zanac/PSN-Presepe-2026/simulation_web/README.md

# Web simulator — PRESEPE.INI

A single HTML page that runs the light cycle described by a `PRESEPE.INI` in the browser, with no hardware and no Arduino. Use it to try curves, colours and timings before copying the file to the microSD card.

Open `index.html` in any modern browser (double-click it). No server and no install needed; only the fonts come from Google Fonts, and the page works with fallback fonts when offline.

## What it shows

- **Left:** the INI text. Edit or paste a file; the simulation updates as you type. Parse errors are listed under the text, one per bad line, by the same rules the firmware uses (the firmware itself only reports how many there are and the first bad line). *Ripristina il file predefinito* reloads the repo's `PRESEPE.INI`; *Copia il file* copies the text, ready for the microSD.
- **Right:** three panels, TRAMONTO (left), CIELO (centre), ALBA (right), with their current RGB values; the name of the current phase and the position in the cycle.
- **Cycle line:** one band per strip (top to bottom: TRAMONTO, CIELO, ALBA), the tappe as white ticks, the level of the two star chains at the bottom (STELLE_01 above, STELLE_02 below, in their tint). Click or drag on it to jump to any point of the cycle.
- **Under the line:** the level of STELLE_01 and STELLE_02, the 16 relays.
- **Transport:** play/pause, cycle duration (`durata1`–`durata3` from the file, plus two fast speeds), previous/next phase.

The text you type is kept in the browser's local storage, so it survives a page reload.

**Grafico / Testo.** The *Grafico* view edits the phases on lanes (colour stops as dots, relay events), the *Testo* view shows the plain file; both stay in sync. See the [README, WiFi](../README.md#wifi-mega--wifi-r3-board) for how it works.

**On the board.** The same page is served by a "Mega + WiFi R3" board at `http://presepe.local/config` ([README, WiFi](../README.md#wifi-mega--wifi-r3-board)). There it starts from the board's `PRESEPE.INI` and adds a card with *Salva sul presepe*, *Riavvia il presepe*, *Ricarica dal presepe* and *Ripristina il file precedente*. `firmware/tools/build_web.py` builds that version from `simulator.template.html`, so rebuild the ESP firmware after changing the template.

## How faithful it is

The JavaScript re-implements the firmware's pure-logic part (the CONFIG block of `PSN-Presepe.ino`, release 039): the parser and its error rules (including the final checks: phase order, potentiometer range, star brightness and twinkle limits of `[STELLE_01]` and `[STELLE_02]`), the defaults, phase positions, the tappe engine (`morbida` smoothstep and `lineare`, truncating interpolation, wrap-around across the cycle end), the level of the two star chains and the relay schedule. The twinkling of single stars is not drawn.

It is a model, not the firmware: when the firmware logic changes, update `simulator.template.html` too.

A screen is not an LED strip. Real strips are more saturated and low values look different, so use the simulator for shape and timing, then fine-tune colours on the real strip or with the board's colour mode.

## Files

| File | Content |
|---|---|
| `index.html` | the simulator, generated — open this one |
| `simulator.template.html` | source of the page, with an `__INI__` placeholder for the default file |
| `build_simulator.py` | rebuilds `index.html` from the template and `firmware/PSN-Presepe/PRESEPE.INI` |

After every change to `firmware/PSN-Presepe/PRESEPE.INI` or to the template, rebuild. After a change to the template also run `python3 firmware/tools/build_web.py` (the ESP pages and the demo use it); after a change to `PRESEPE.INI` run both that and `python3 firmware/tools/embed_ini.py` (the copy inside the firmware). `firmware/tools/run_tests.sh` checks all of them with `--check`:

```sh
python3 simulation_web/build_simulator.py
# options: --ini PATH  --template PATH  --out PATH  --check
```
