zanac/PSN-Presepe-2026/reports/schematic-pcb-parity.txt

schematic pins 363, pcb pads 363, net mismatches 0, footprint mismatches 0
