zanac/PSN-Presepe-2026/hardware/rev-e/reports/schematic-pcb-parity.txt

schematic pins 373, pcb pads 373, net mismatches 0, footprint mismatches 0
