zanac/PSN-Presepe-2026/hardware/rev-e/previews/PSN-Presepe-Mega-RevE-copper-both.png

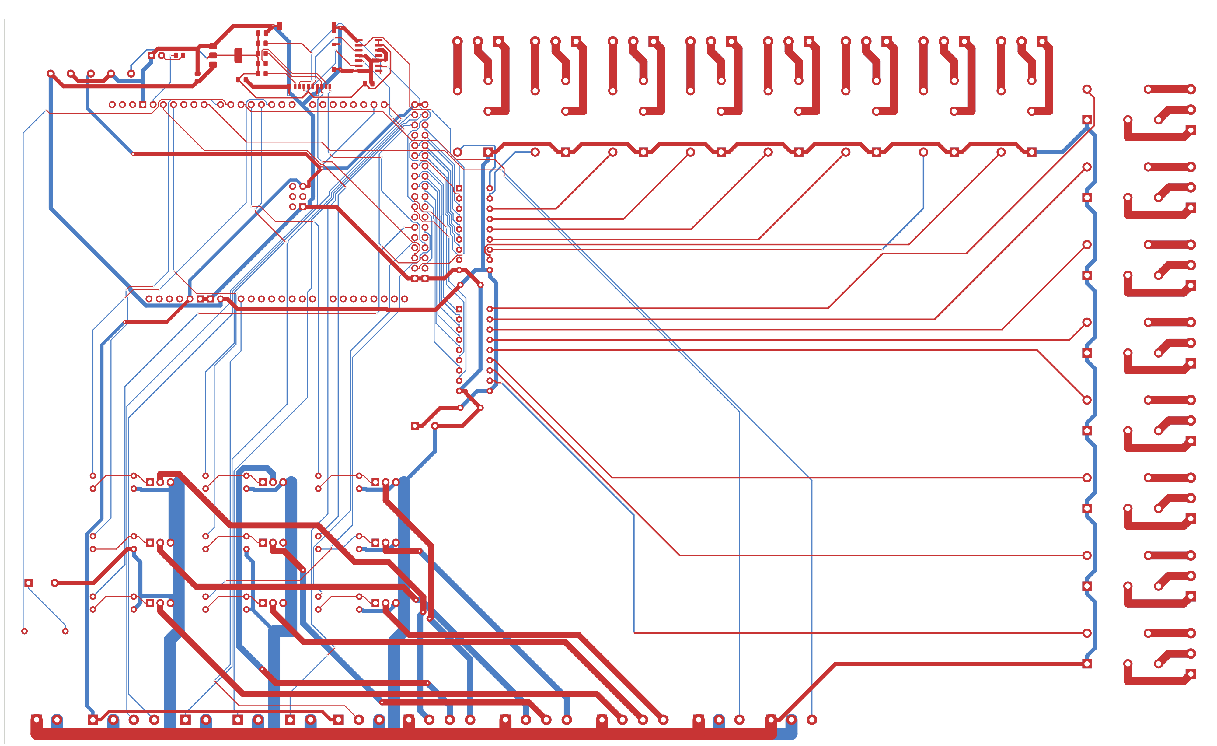
hardware/rev-e/previews/PSN-Presepe-Mega-RevE-copper-both.png
