zanac/PSN-Presepe-2026/hardware/rev-e/previews/PSN-Presepe-Mega-RevE-gerber-render-bottom.png

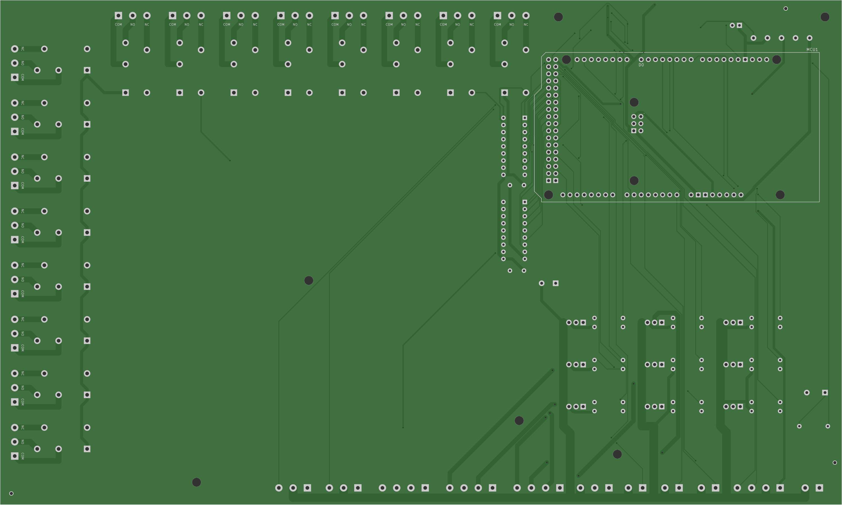
hardware/rev-e/previews/PSN-Presepe-Mega-RevE-gerber-render-bottom.png
