zanac/PSN-Presepe-2026/hardware/rev-e/previews/PSN-Presepe-Mega-RevE-gerber-render-top.png

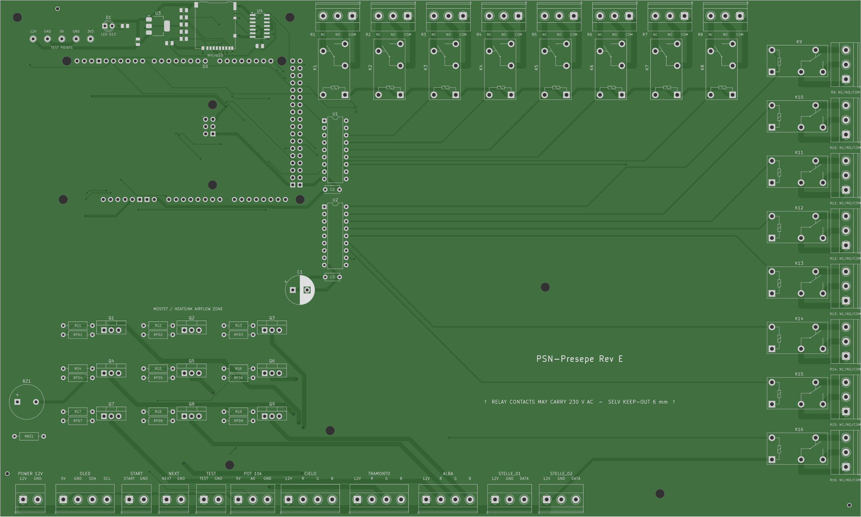
hardware/rev-e/previews/PSN-Presepe-Mega-RevE-gerber-render-top.png
