zanac/PSN-Presepe-2026/previews/PSN-Presepe-Mega-RevD-copper-both.png

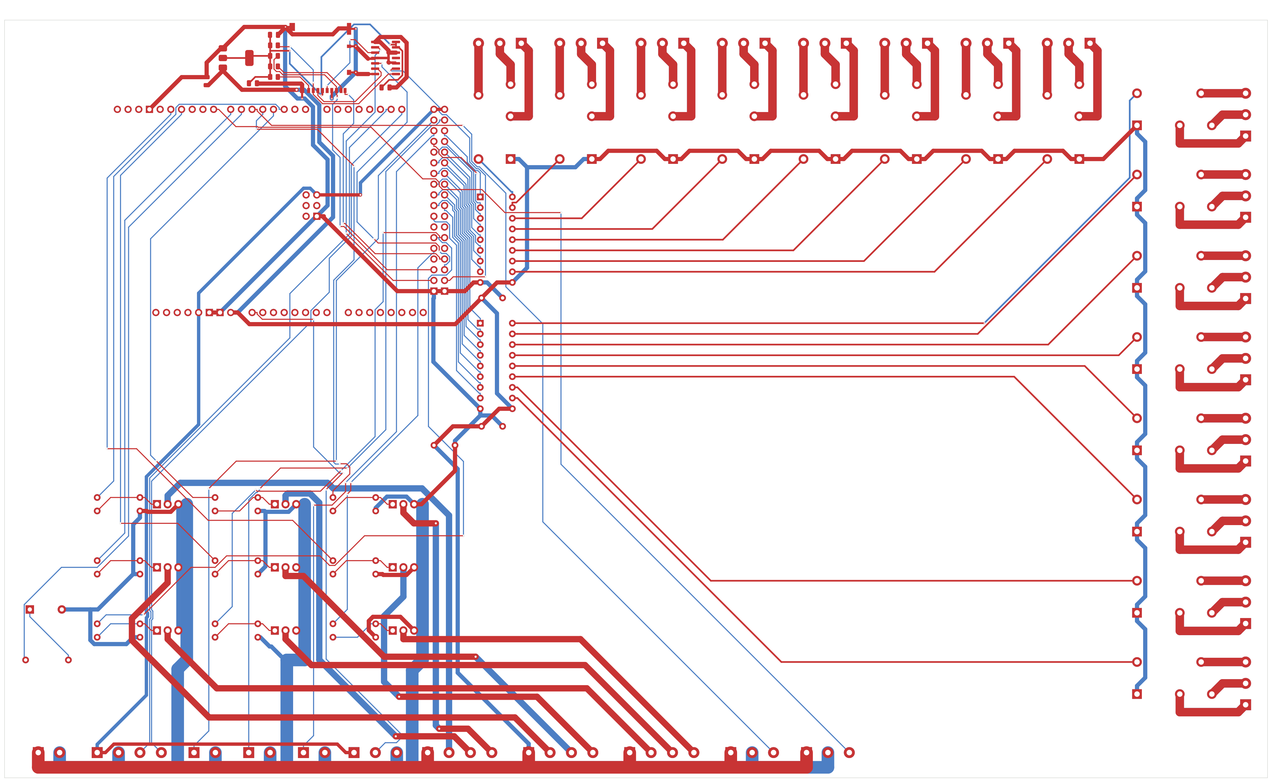
previews/PSN-Presepe-Mega-RevD-copper-both.png
