zanac/PSN-Presepe-2026/previews/PSN-Presepe-Mega-RevD-gerber-render-bottom.png

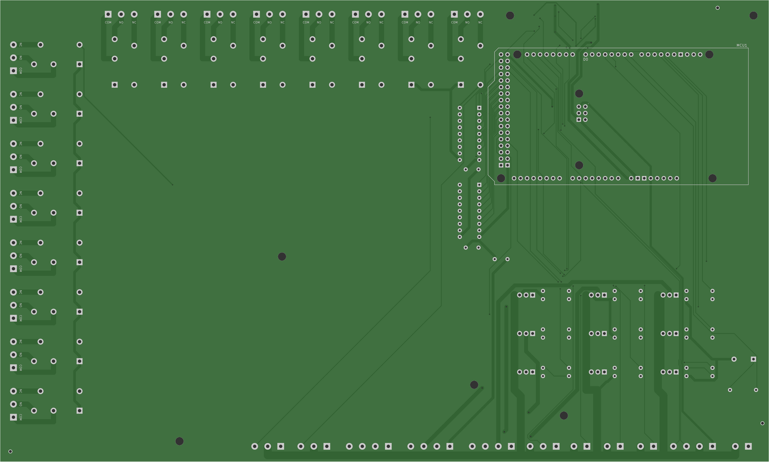
previews/PSN-Presepe-Mega-RevD-gerber-render-bottom.png
