zanac/PSN-Presepe-2026/undefined/sim.png

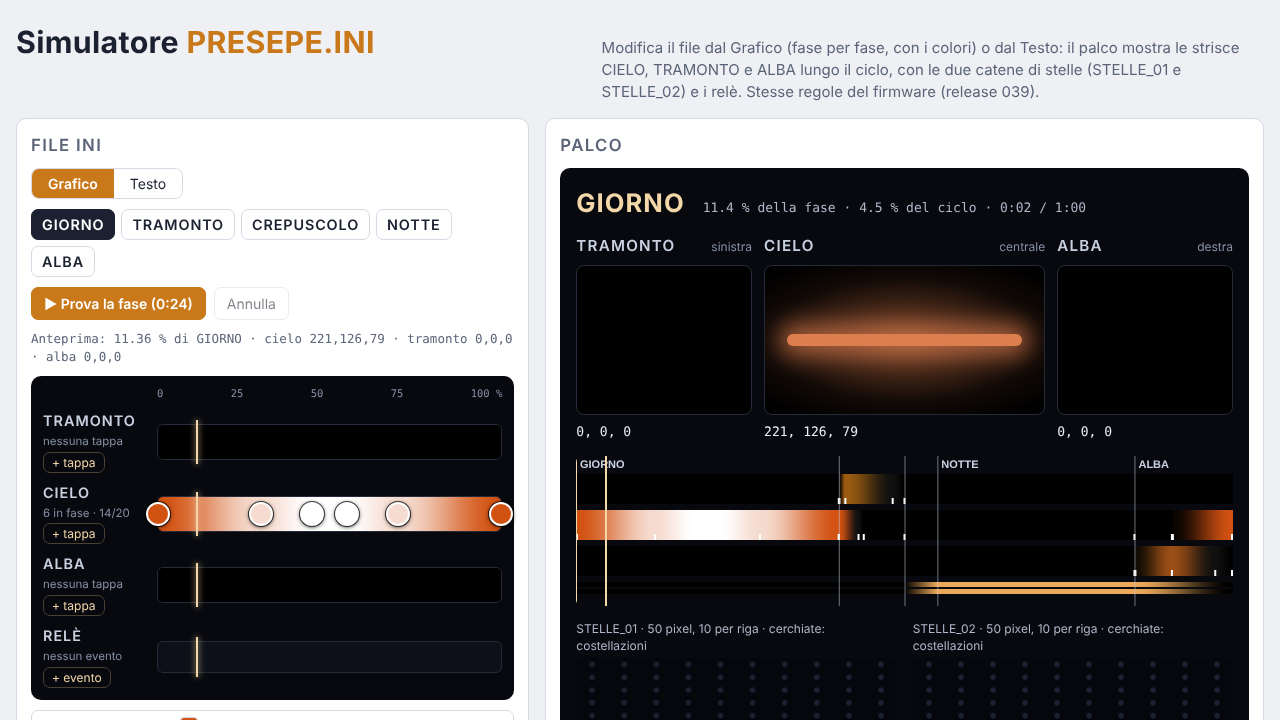
undefined/sim.png
