zanac/PSN-Presepe-2026/hardware/rev-d/manufacturing/pcbway-order-2026-10-04/README.md

# PCBWay order of 2026-10-04 (frozen)

These are the exact files uploaded to PCBWay for the first Rev D production run.
Never regenerate or edit them; `SHA256SUMS` lets you check that they are intact
(`sha256sum -c SHA256SUMS`).

| PCBWay upload field | File |
|---|---|
| Upload Gerbers file | `PSN-Presepe-Mega-RevD-gerbers.zip` |
| Parts List (BOM) Upload | `PSN-Presepe-Mega-RevD-BOM-PCBWay.csv` |
| Upload Centroid file | `PSN-Presepe-Mega-RevD-Centroid-PCBWay.csv` |
| Upload assembly other files | `PSN-Presepe-Mega-RevD-Assembly-Instructions.pdf` |

Order numbers: PCB `W1109855AS3D1`, assembly `T-3D2W1109855A`.

PCB options chosen: single pieces, 300 x 180 mm, quantity 5, 2 layers, FR-4 TG150,
1.6 mm, 8/8 mil (set by PCBWay for 2 oz), min hole 0.3 mm, green mask, white silk,
HASL lead-free (ENIG substitution allowed), tented vias, 2 oz finished copper,
product number removed. Assembly: turnkey, 2 boards, both sides (MCU1 headers on
the bottom), alternatives accepted for passives only (see the remarks below).

Remarks sent with the order:

> Board carries 230 VAC on relay contacts: do not modify copper, clearances or add
> vias. 2 oz copper required. Please send DFM results before production.

Message to the sales representative (Contact sales-rep):

> 1. Min copper spacing in the design is 0.20 mm (7.9 mil). Please confirm it is OK
>    with 2 oz copper, otherwise tell us before production. Do not modify copper,
>    clearances or vias: the relay area carries 230 VAC.
> 2. The Arduino Mega headers (MCU1) must be mounted on the BOTTOM side, and the ICSP
>    2x3 holes left empty, as described in the Assembly-Instructions PDF.
> 3. Please keep the exact part numbers in the BOM for relays, MOSFETs, ICs, the
>    microSD socket and the terminal blocks, and ask before substituting them.
> 4. Please send photos of the first assembled board before shipping.

Differences from the files regenerated by `./build.sh` (all cosmetic, verified):

* Gerbers: the X2 header attribute `TF.ProjectId` / job-file `Revision` says `C`
  (a leftover title-block value, fixed to `D` afterwards) and the creation dates
  differ. `reports/gerber-equivalence-vs-pcbway-order.txt` proves the copper, mask,
  silkscreen, outline and drill geometry is identical, primitive by primitive.
* Centroid: MCU1 X was rounded by hand to 85.6600 mm; the script writes 85.6580 mm.
