zanac/PSN-Presepe-2026/hardware/rev-e/previews/PSN-Presepe-Mega-RevE-assembly.png

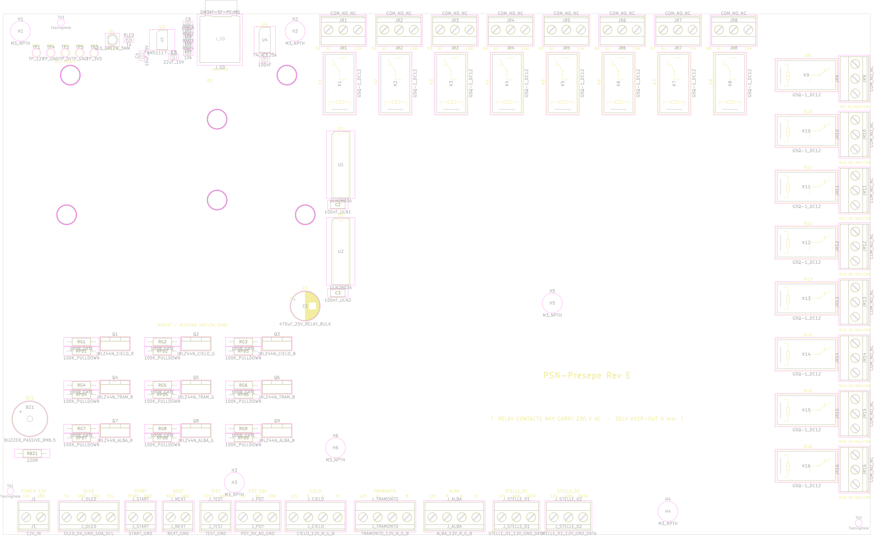
hardware/rev-e/previews/PSN-Presepe-Mega-RevE-assembly.png
