zanac/PSN-Presepe-2026/hardware/rev-e/kicad/PSN-Presepe-Mega-RevE-schematic.pdf

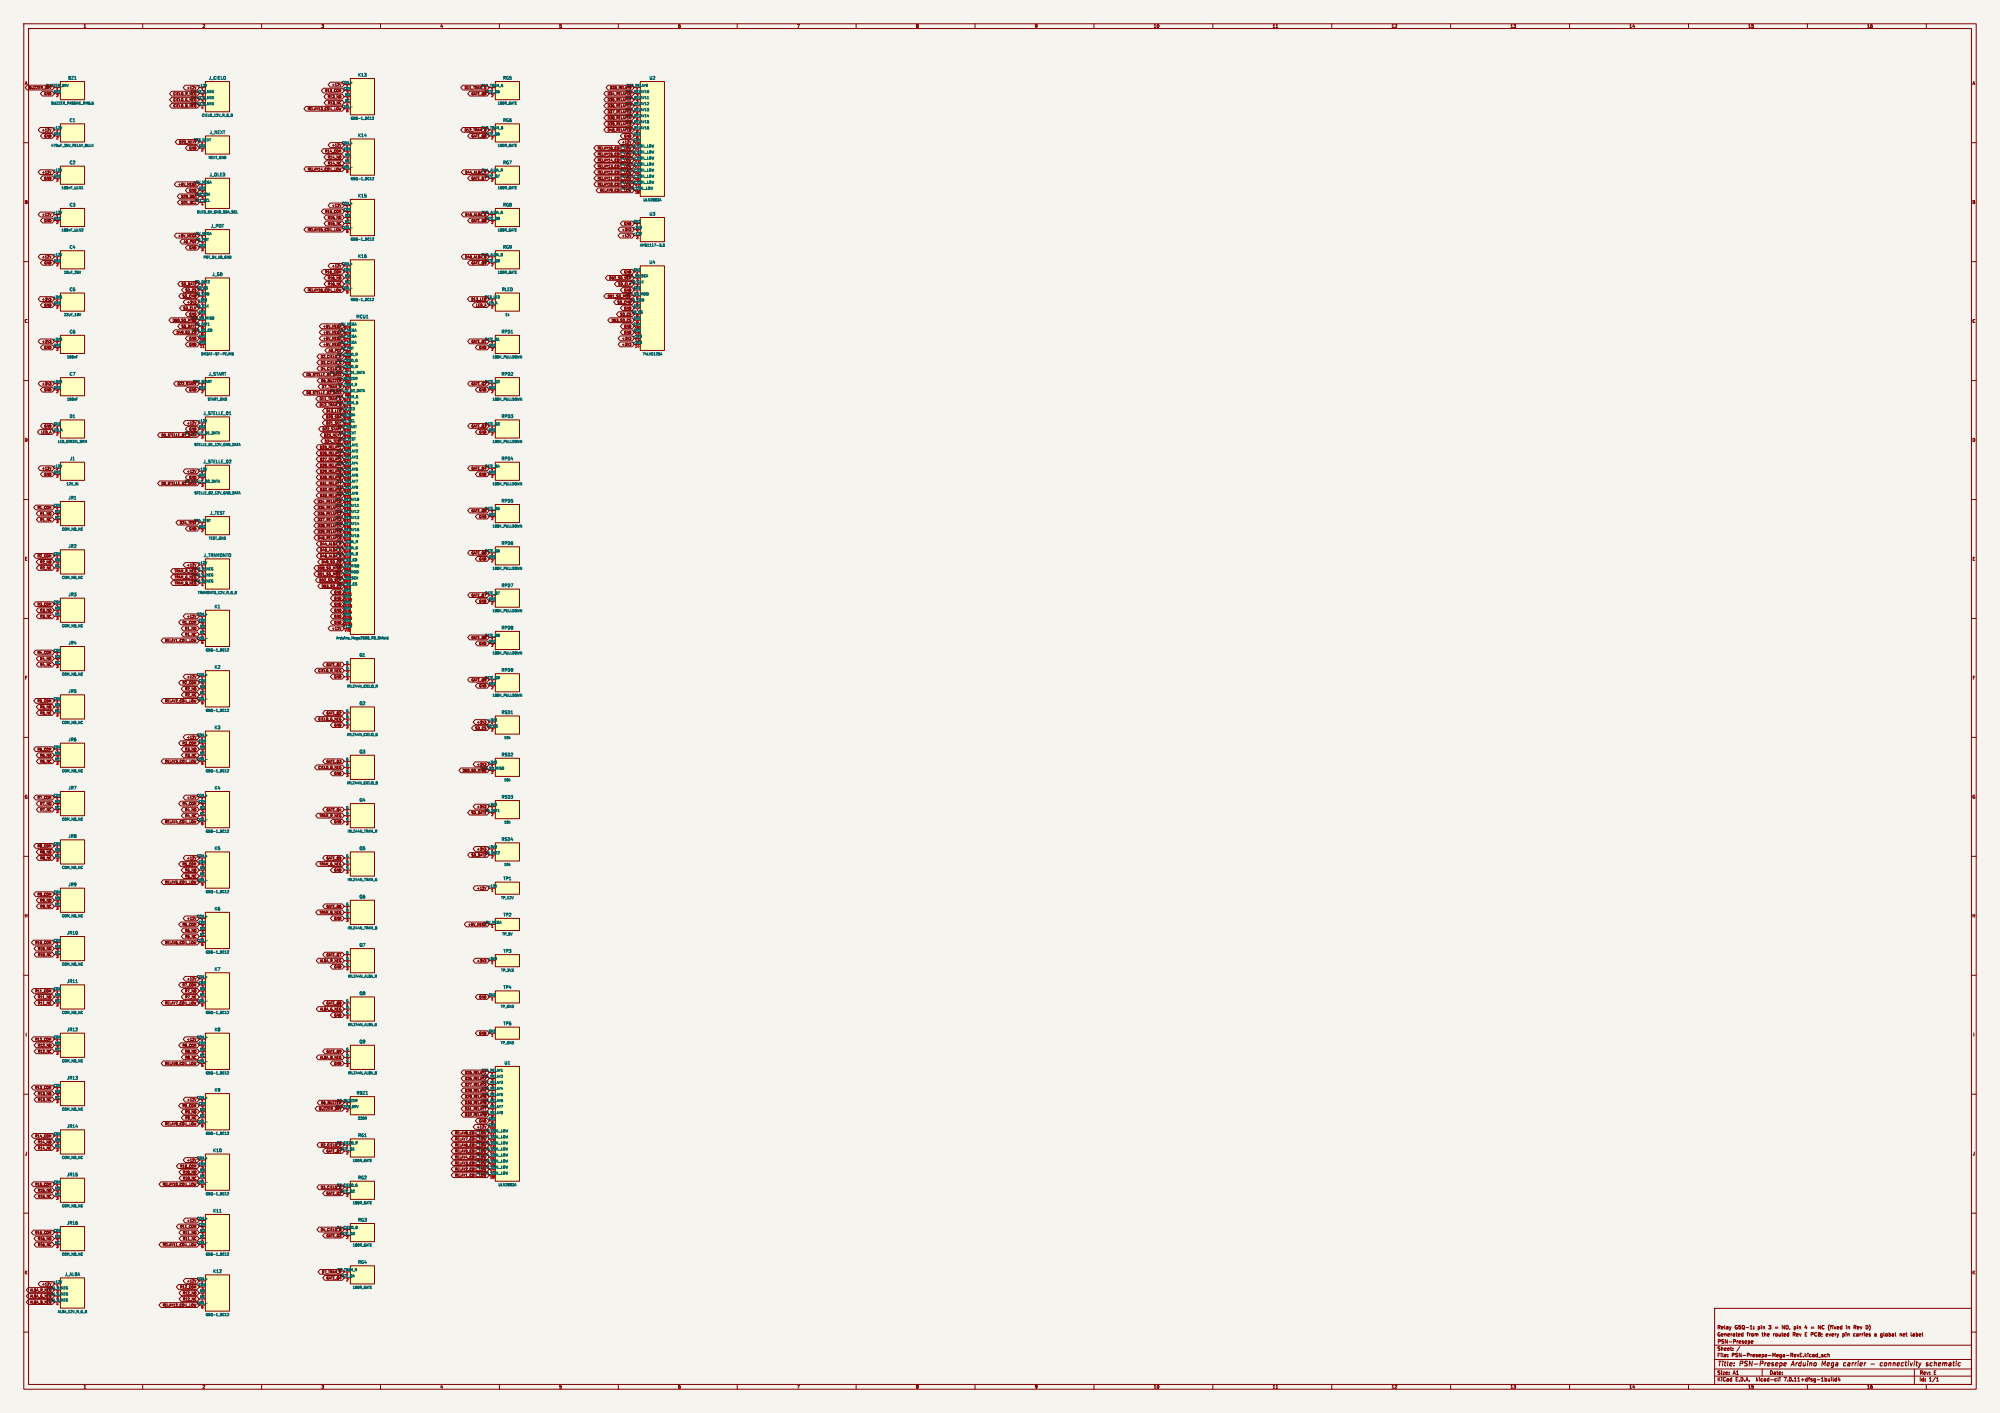
[picture p14: page 1]

POT_5V_A0_GND
D7 D8_STELLE_02_DATA D8 GND GND1 GND GND2 GND GND3 GND GND4 GND GND5 GND GND6 +12V

+3V3 GND GATE_Q9 GND GATE_Q8 GND GATE_Q7 GND GND
+12V GND GND GND GND
GATE_Q2 GND
