zanac/PSN-Presepe-2026/manufacturing/PSN-Presepe-Mega-RevD-1to1-A3-top.pdf

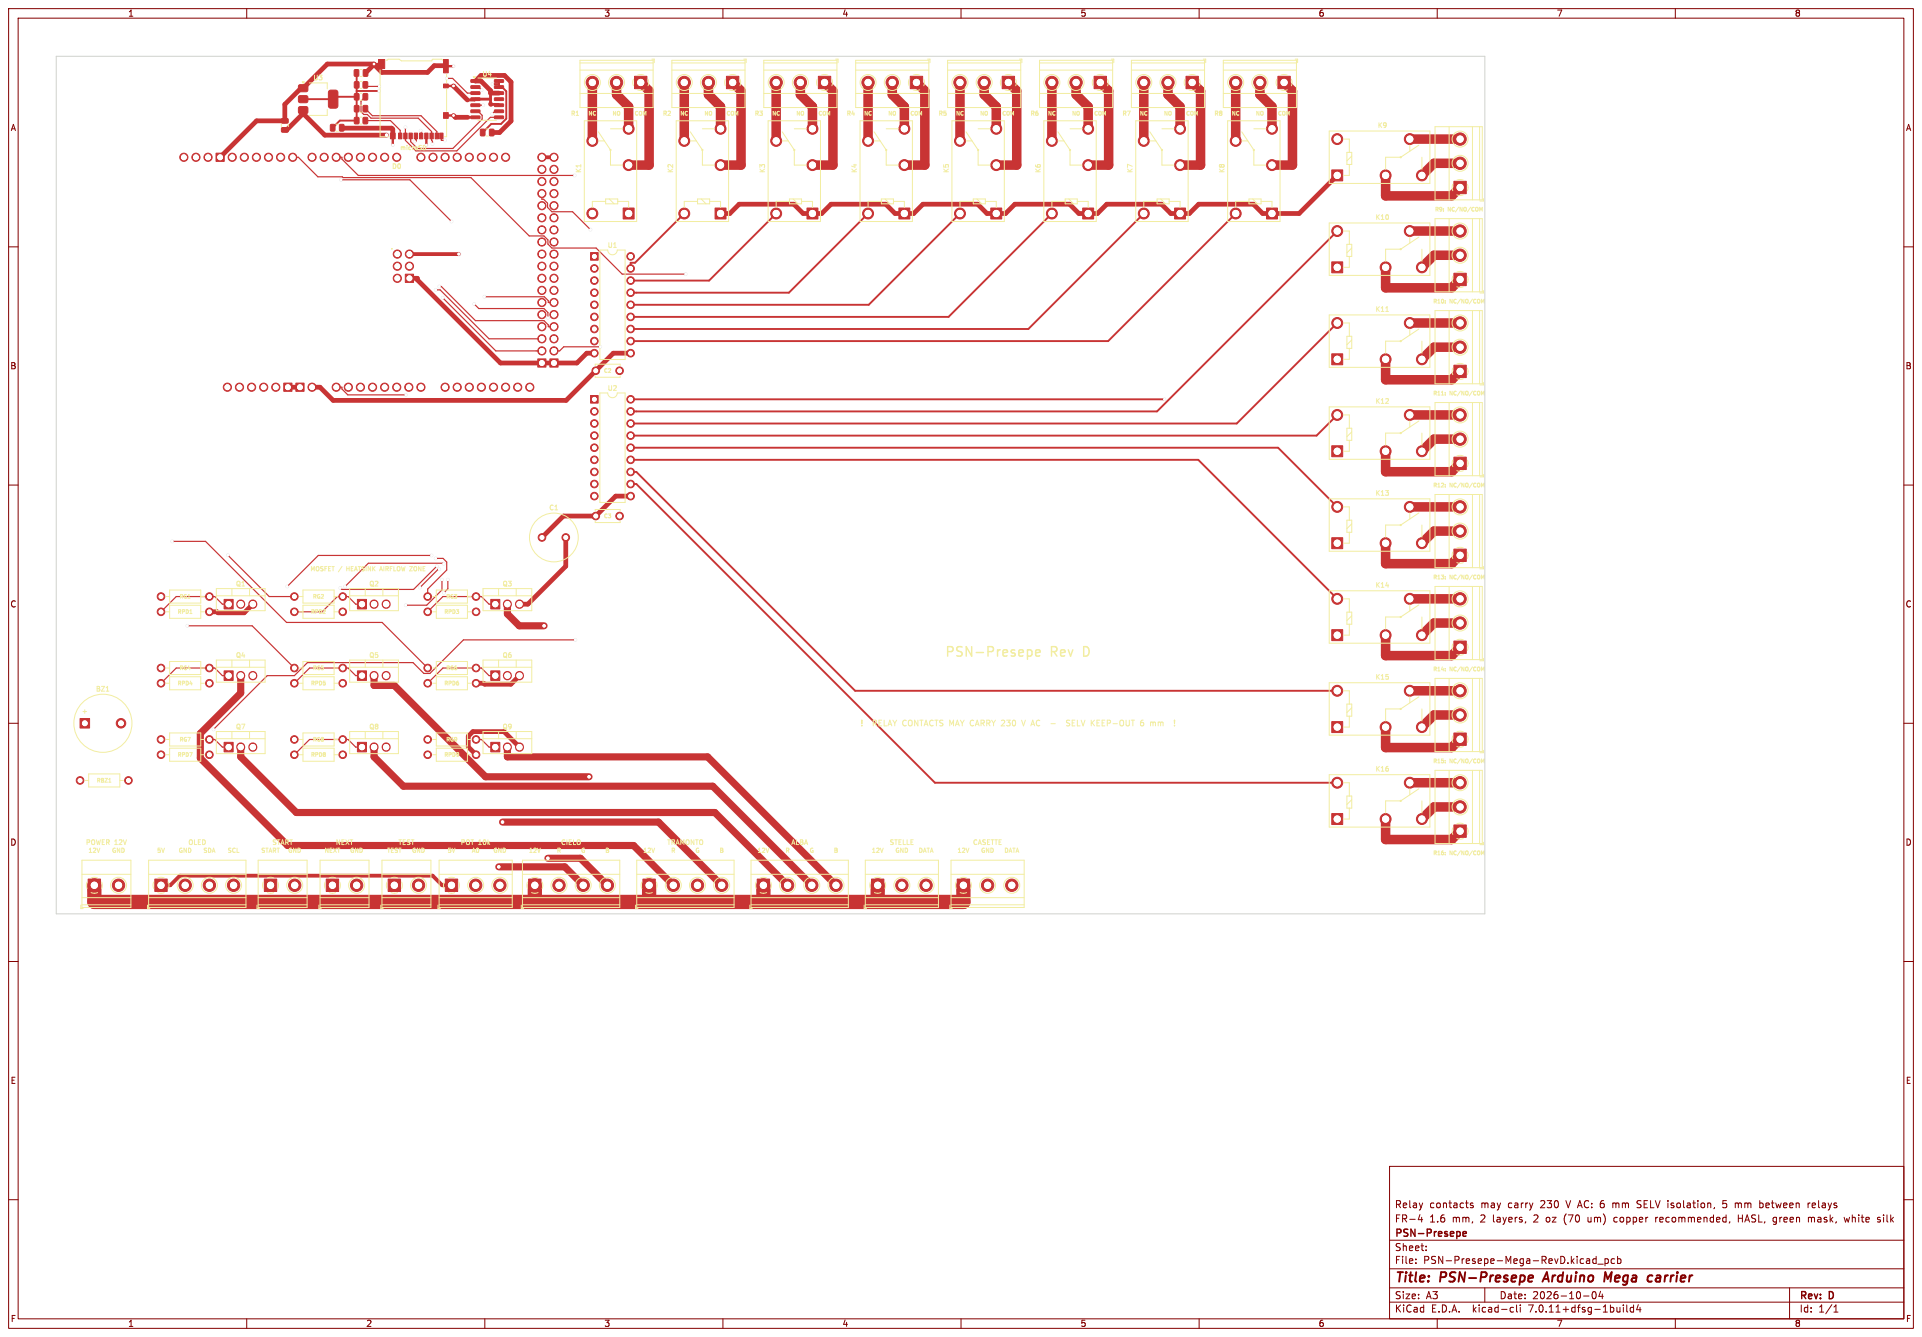
[picture p15: page 1]

R12: NC/NO/COM CASETTE
