zanac/PSN-Presepe-2026/hardware/rev-e/manufacturing/PSN-Presepe-Mega-RevE-1to1-A3-top.pdf

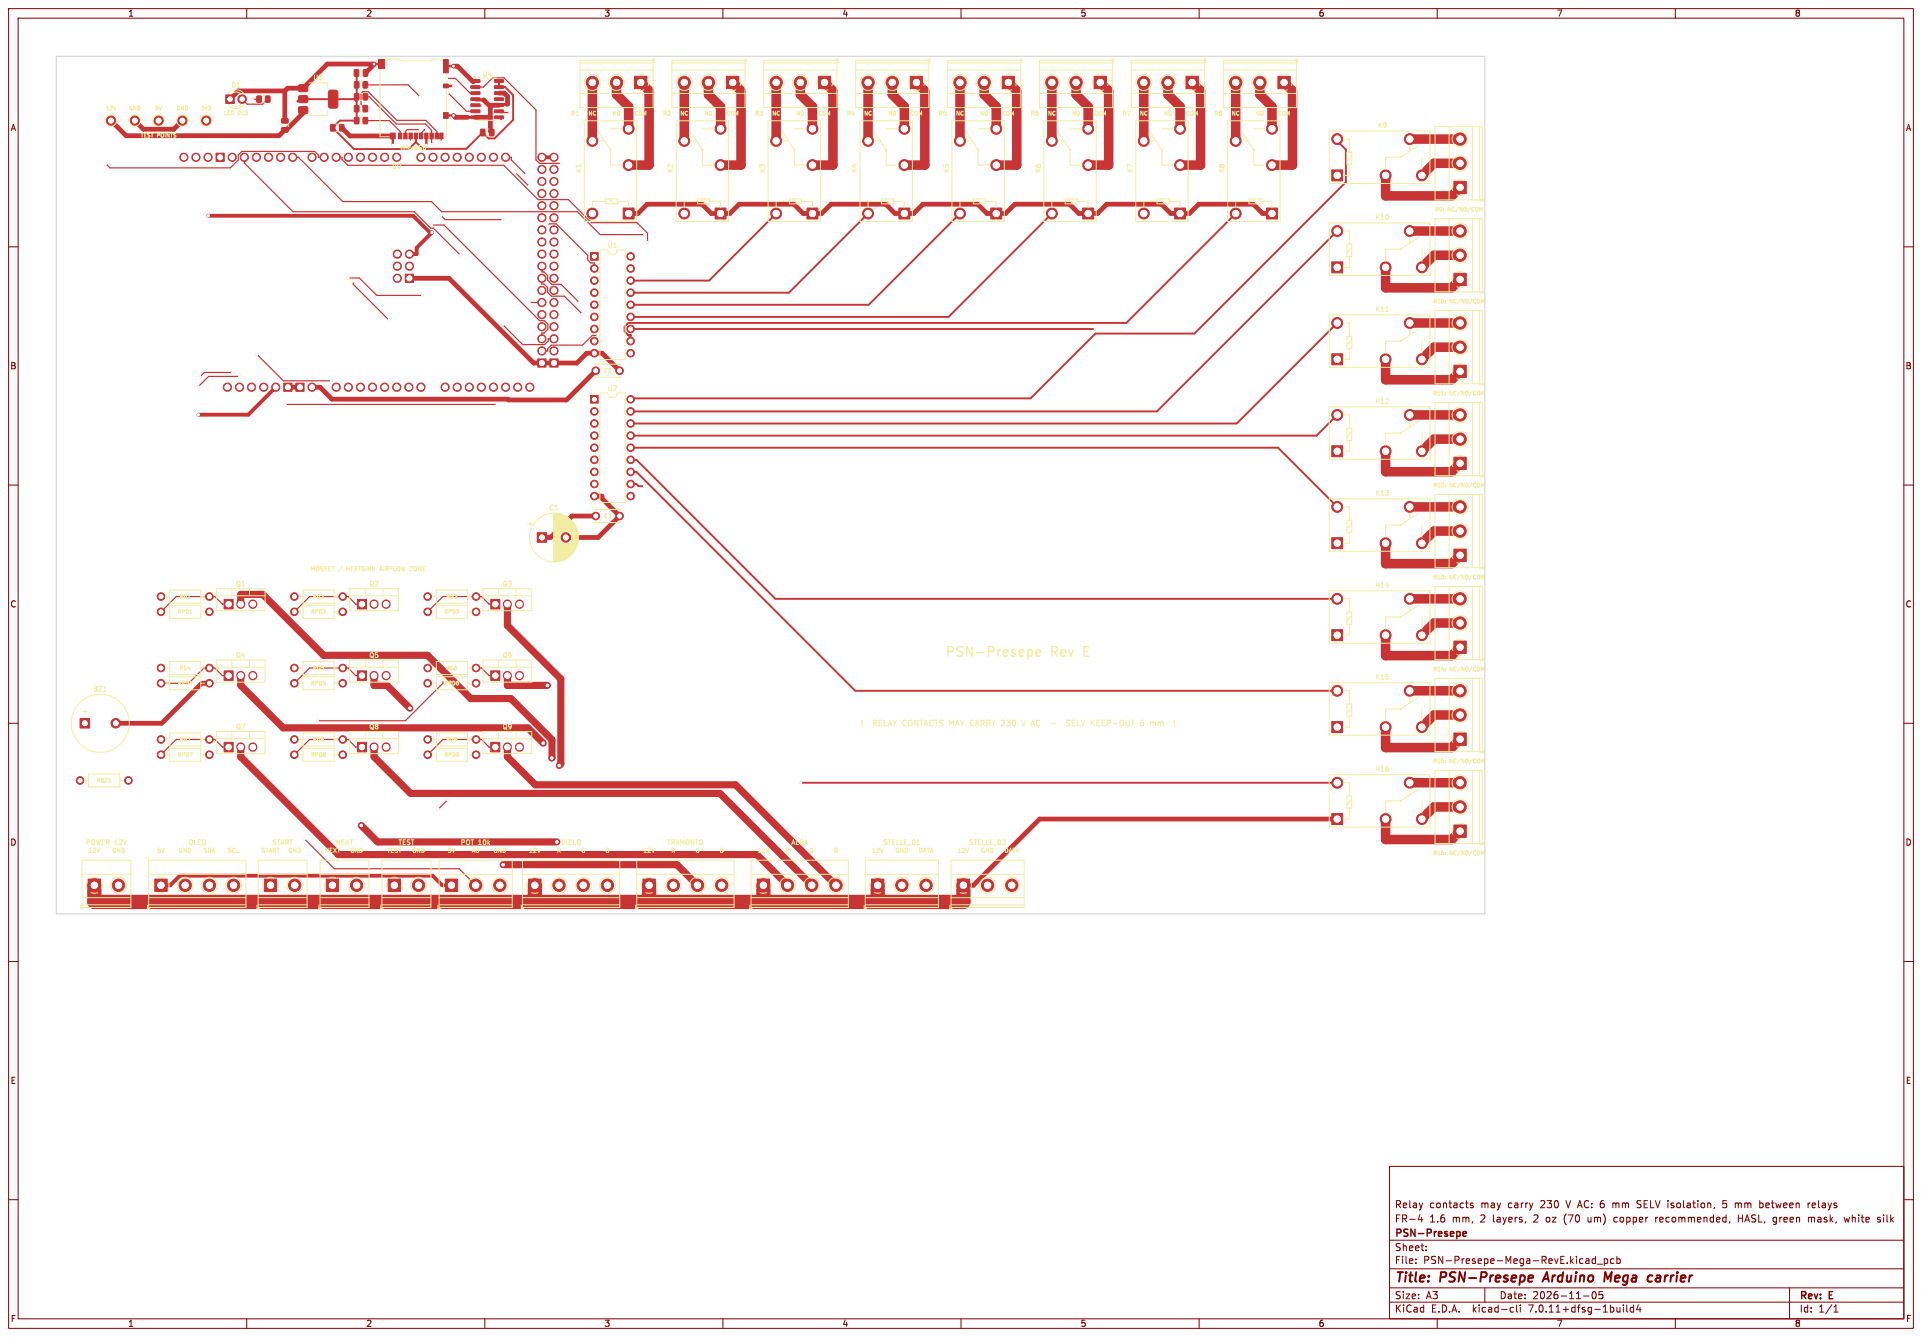
[picture p16: page 1]
