zanac/PSN-Presepe-2026/hardware/rev-d/kicad/PSN-Presepe-Mega-RevD-schematic.pdf

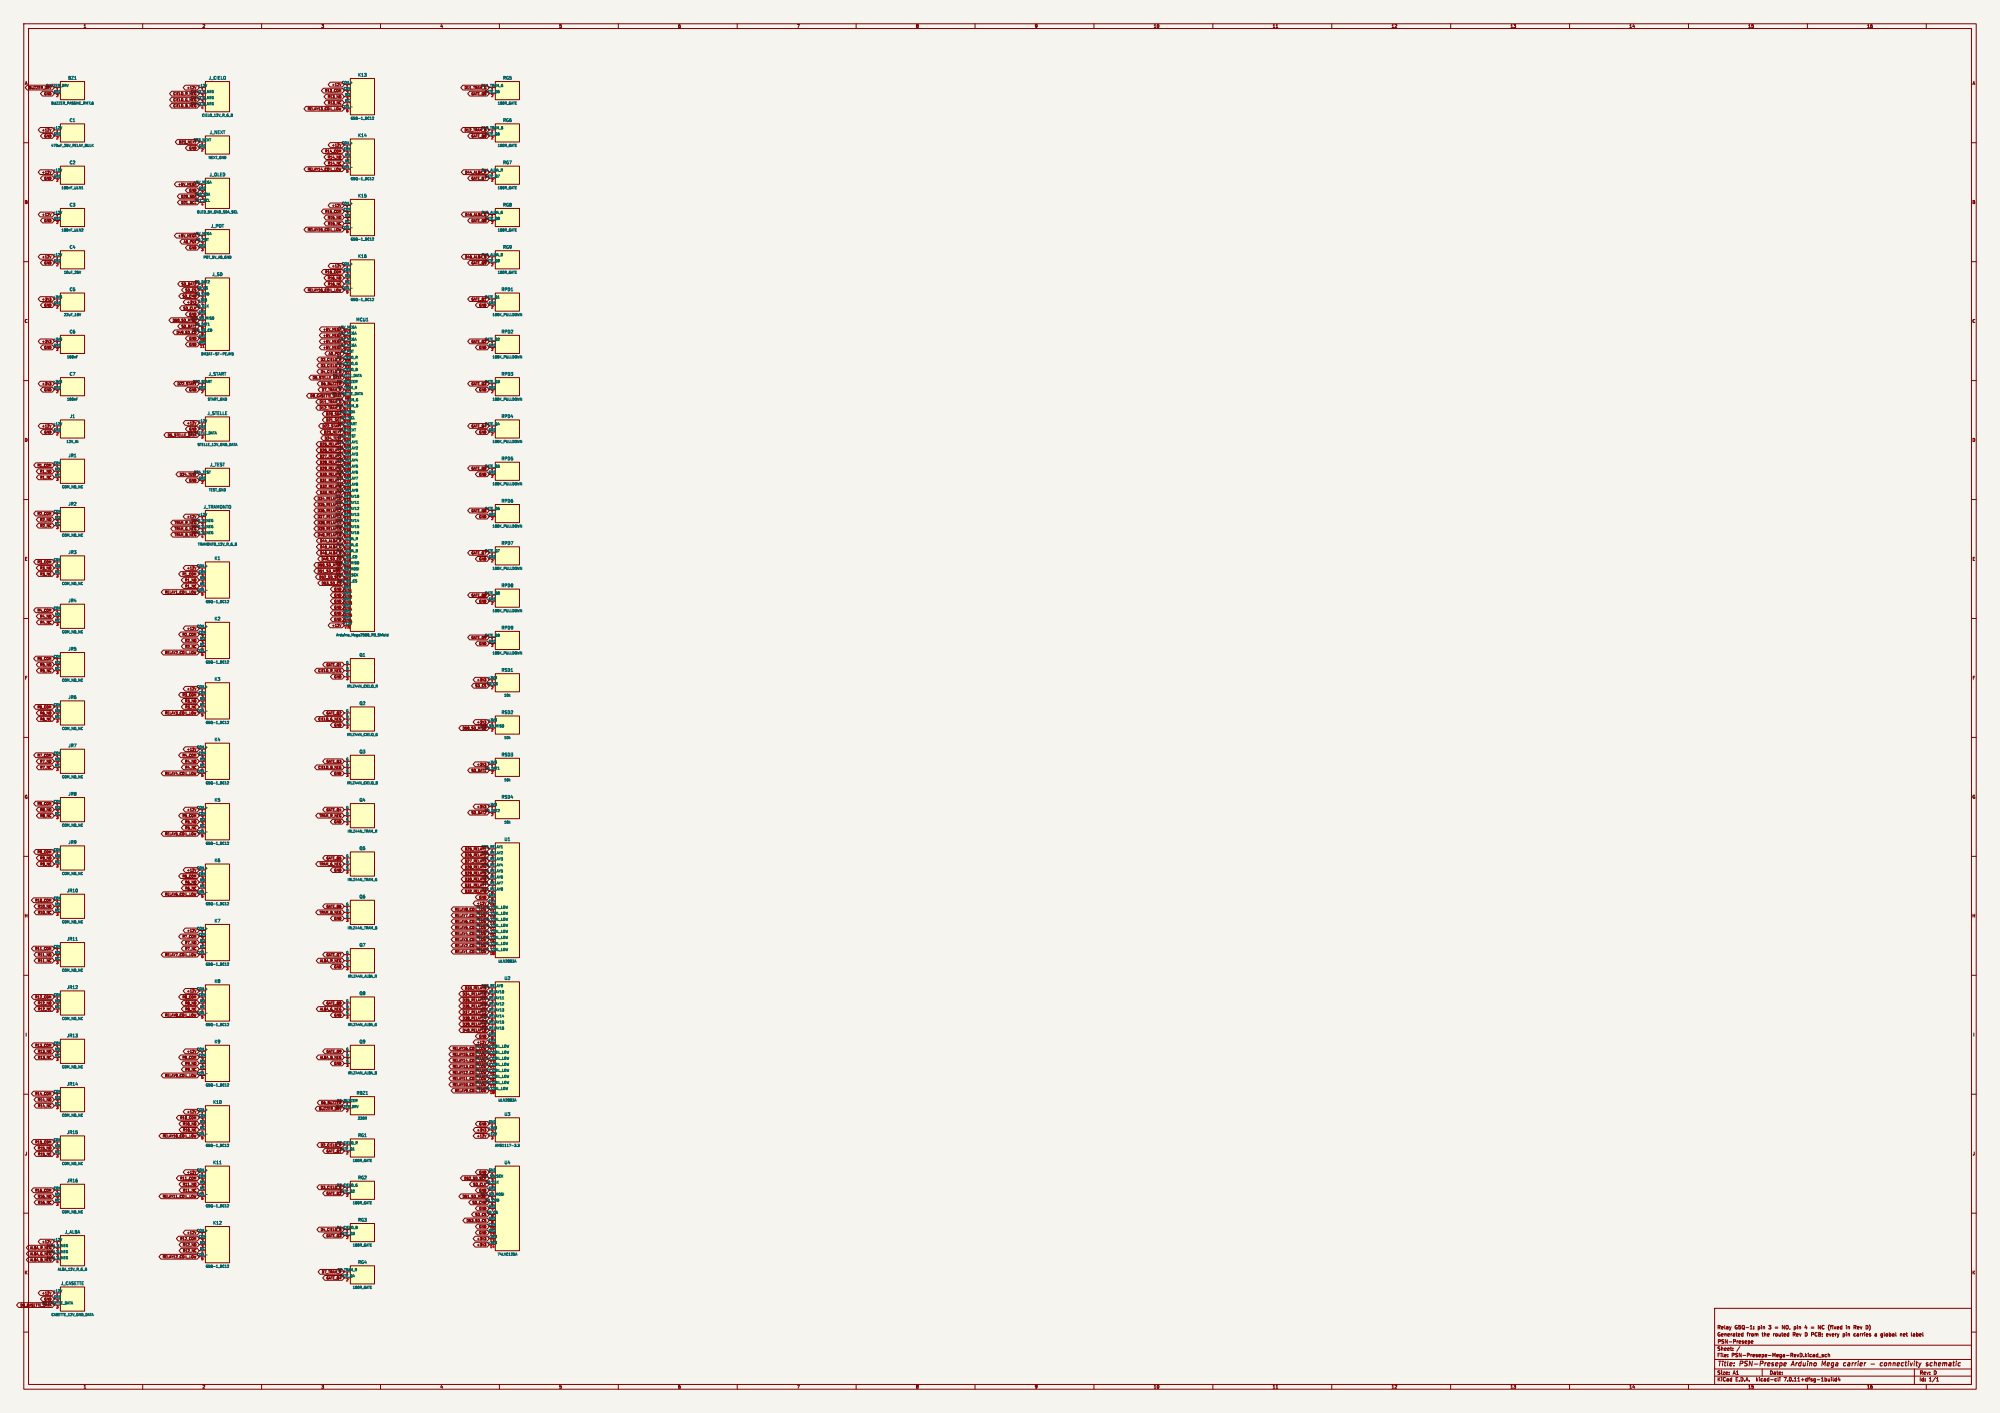
[picture p17: page 1]

+12V GND GND GND GND
