zanac/PSN-Presepe-2026/hardware/rev-e/kicad/PSN-Presepe-Mega-RevE.kicad_pcb

## KiCad design hardware/rev-e/kicad/PSN-Presepe-Mega-RevE.kicad_pcb (2026-11-05)

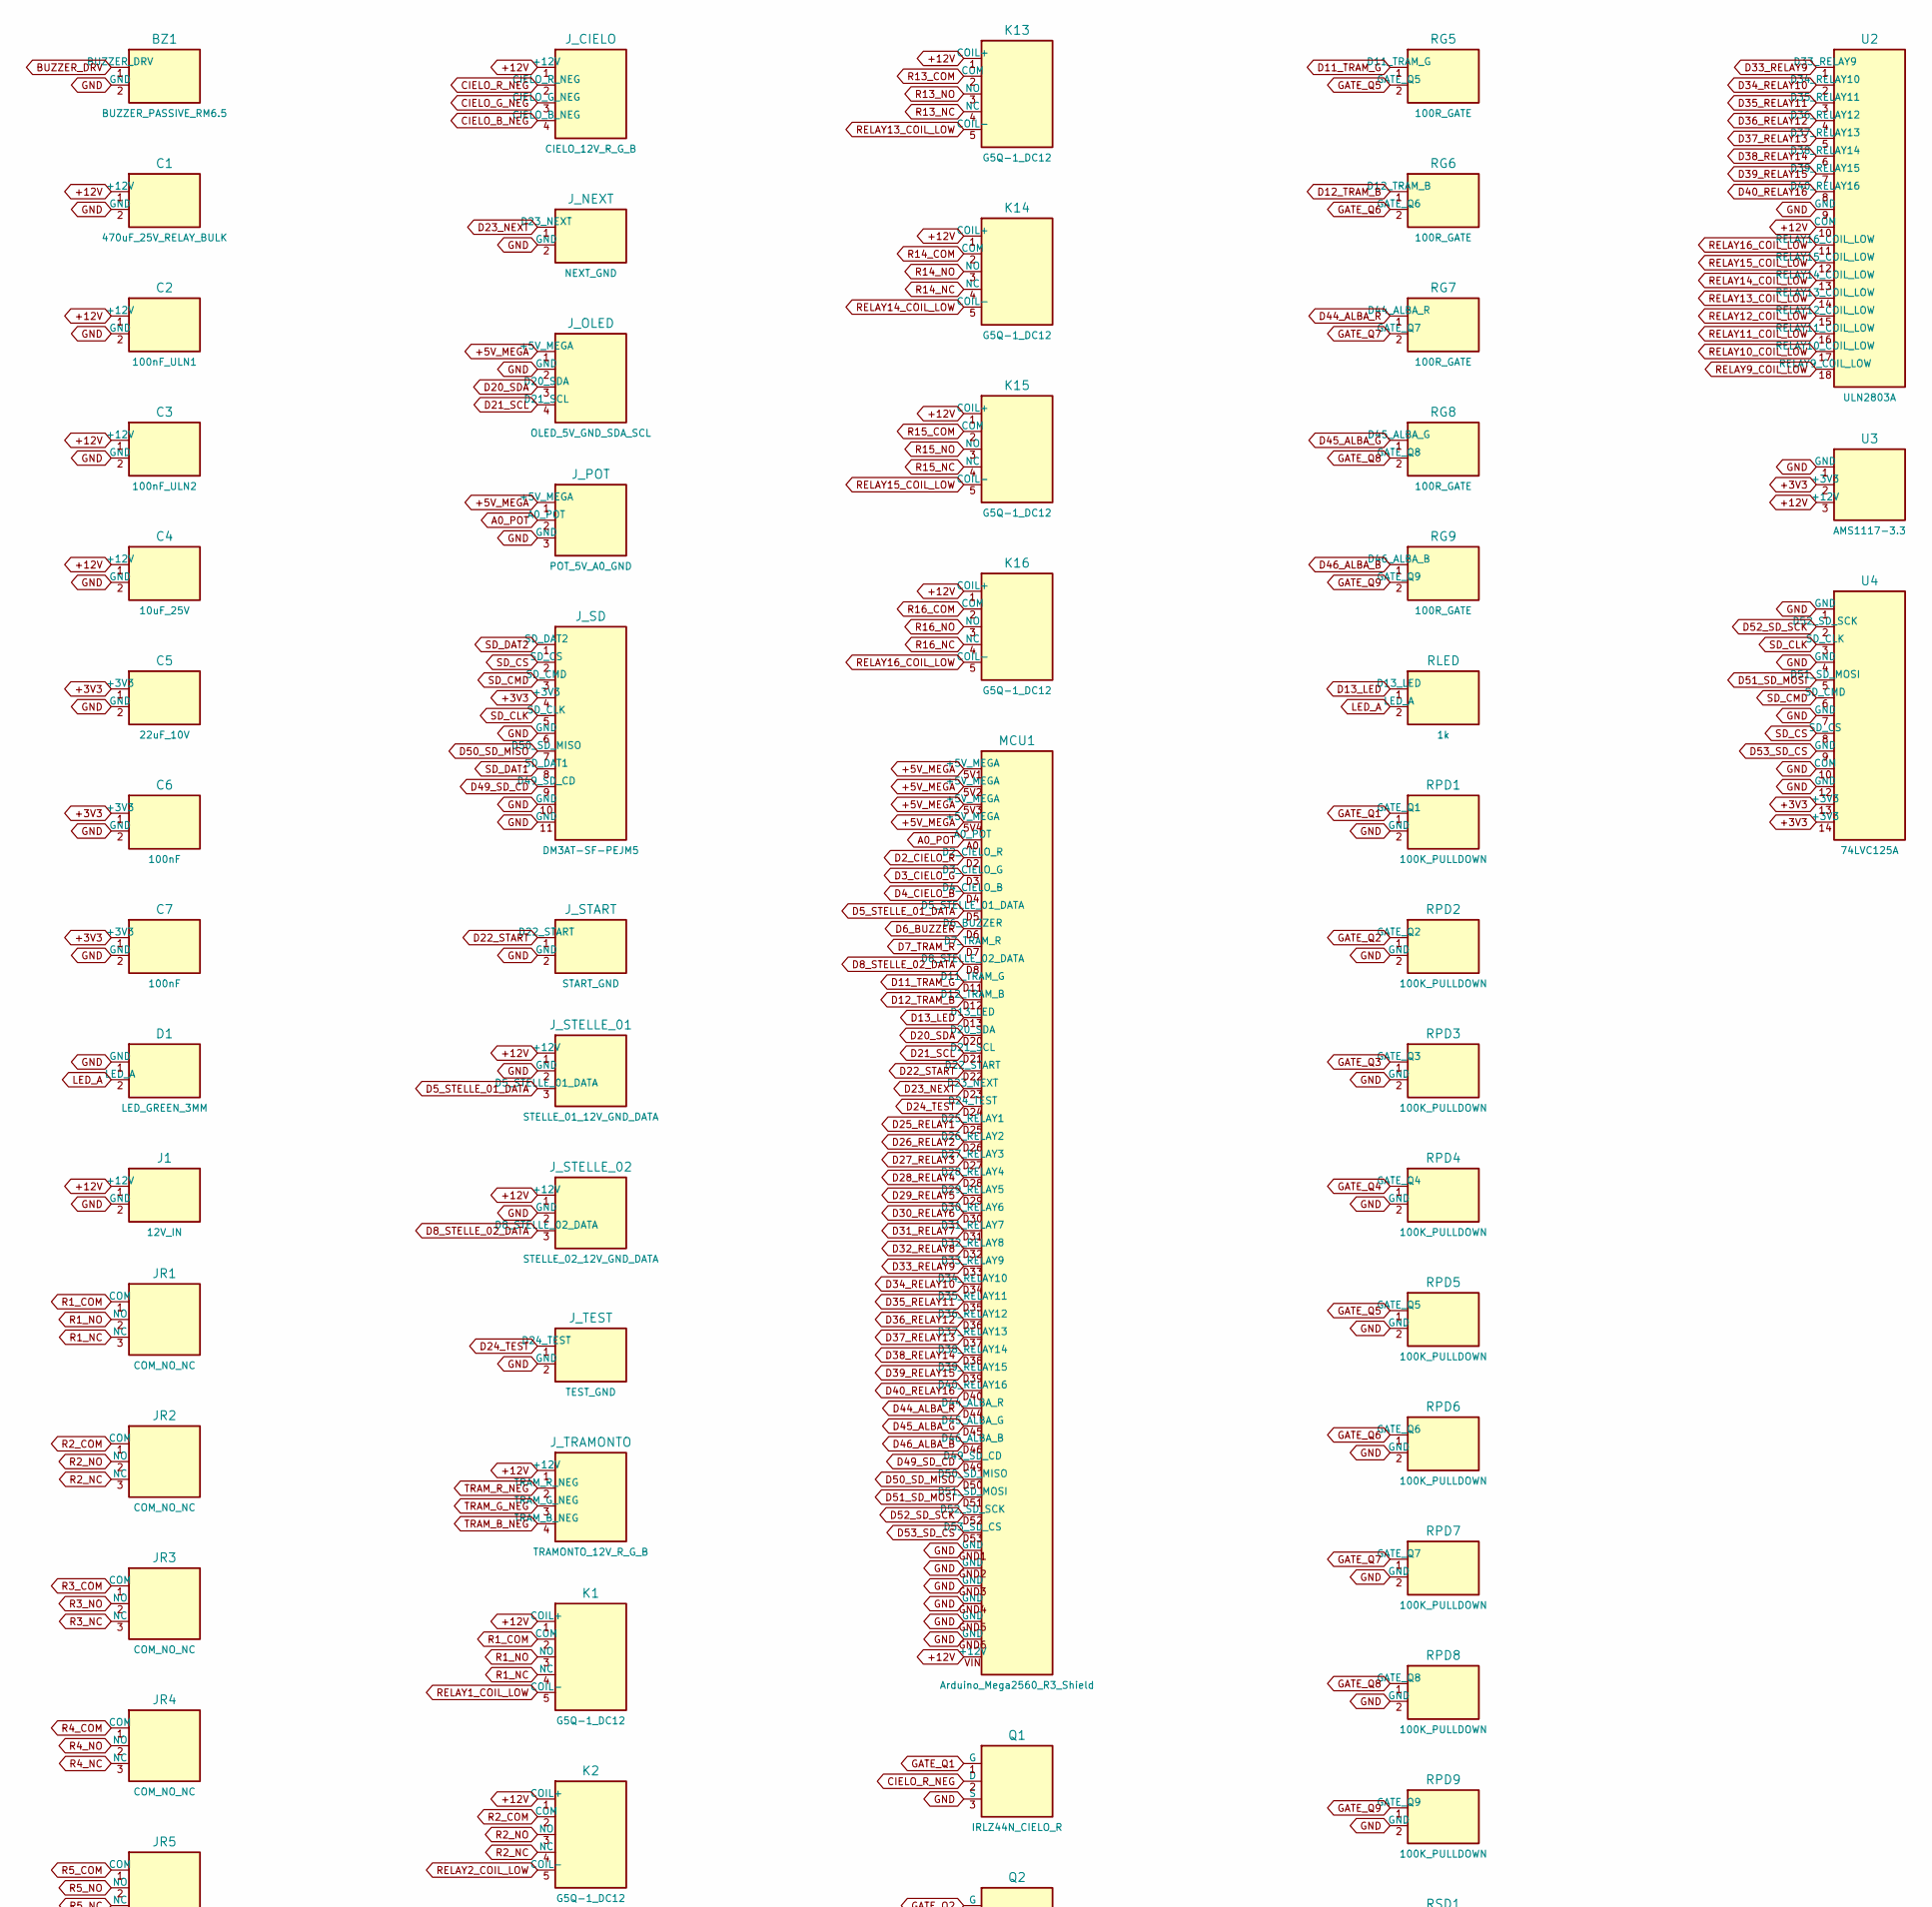
[picture p18: schematic PSN-Presepe-Mega-RevE.kicad_sch, PSN-Presepe Arduino Mega carrier - connectivity schematic, part in row 1, column 1]

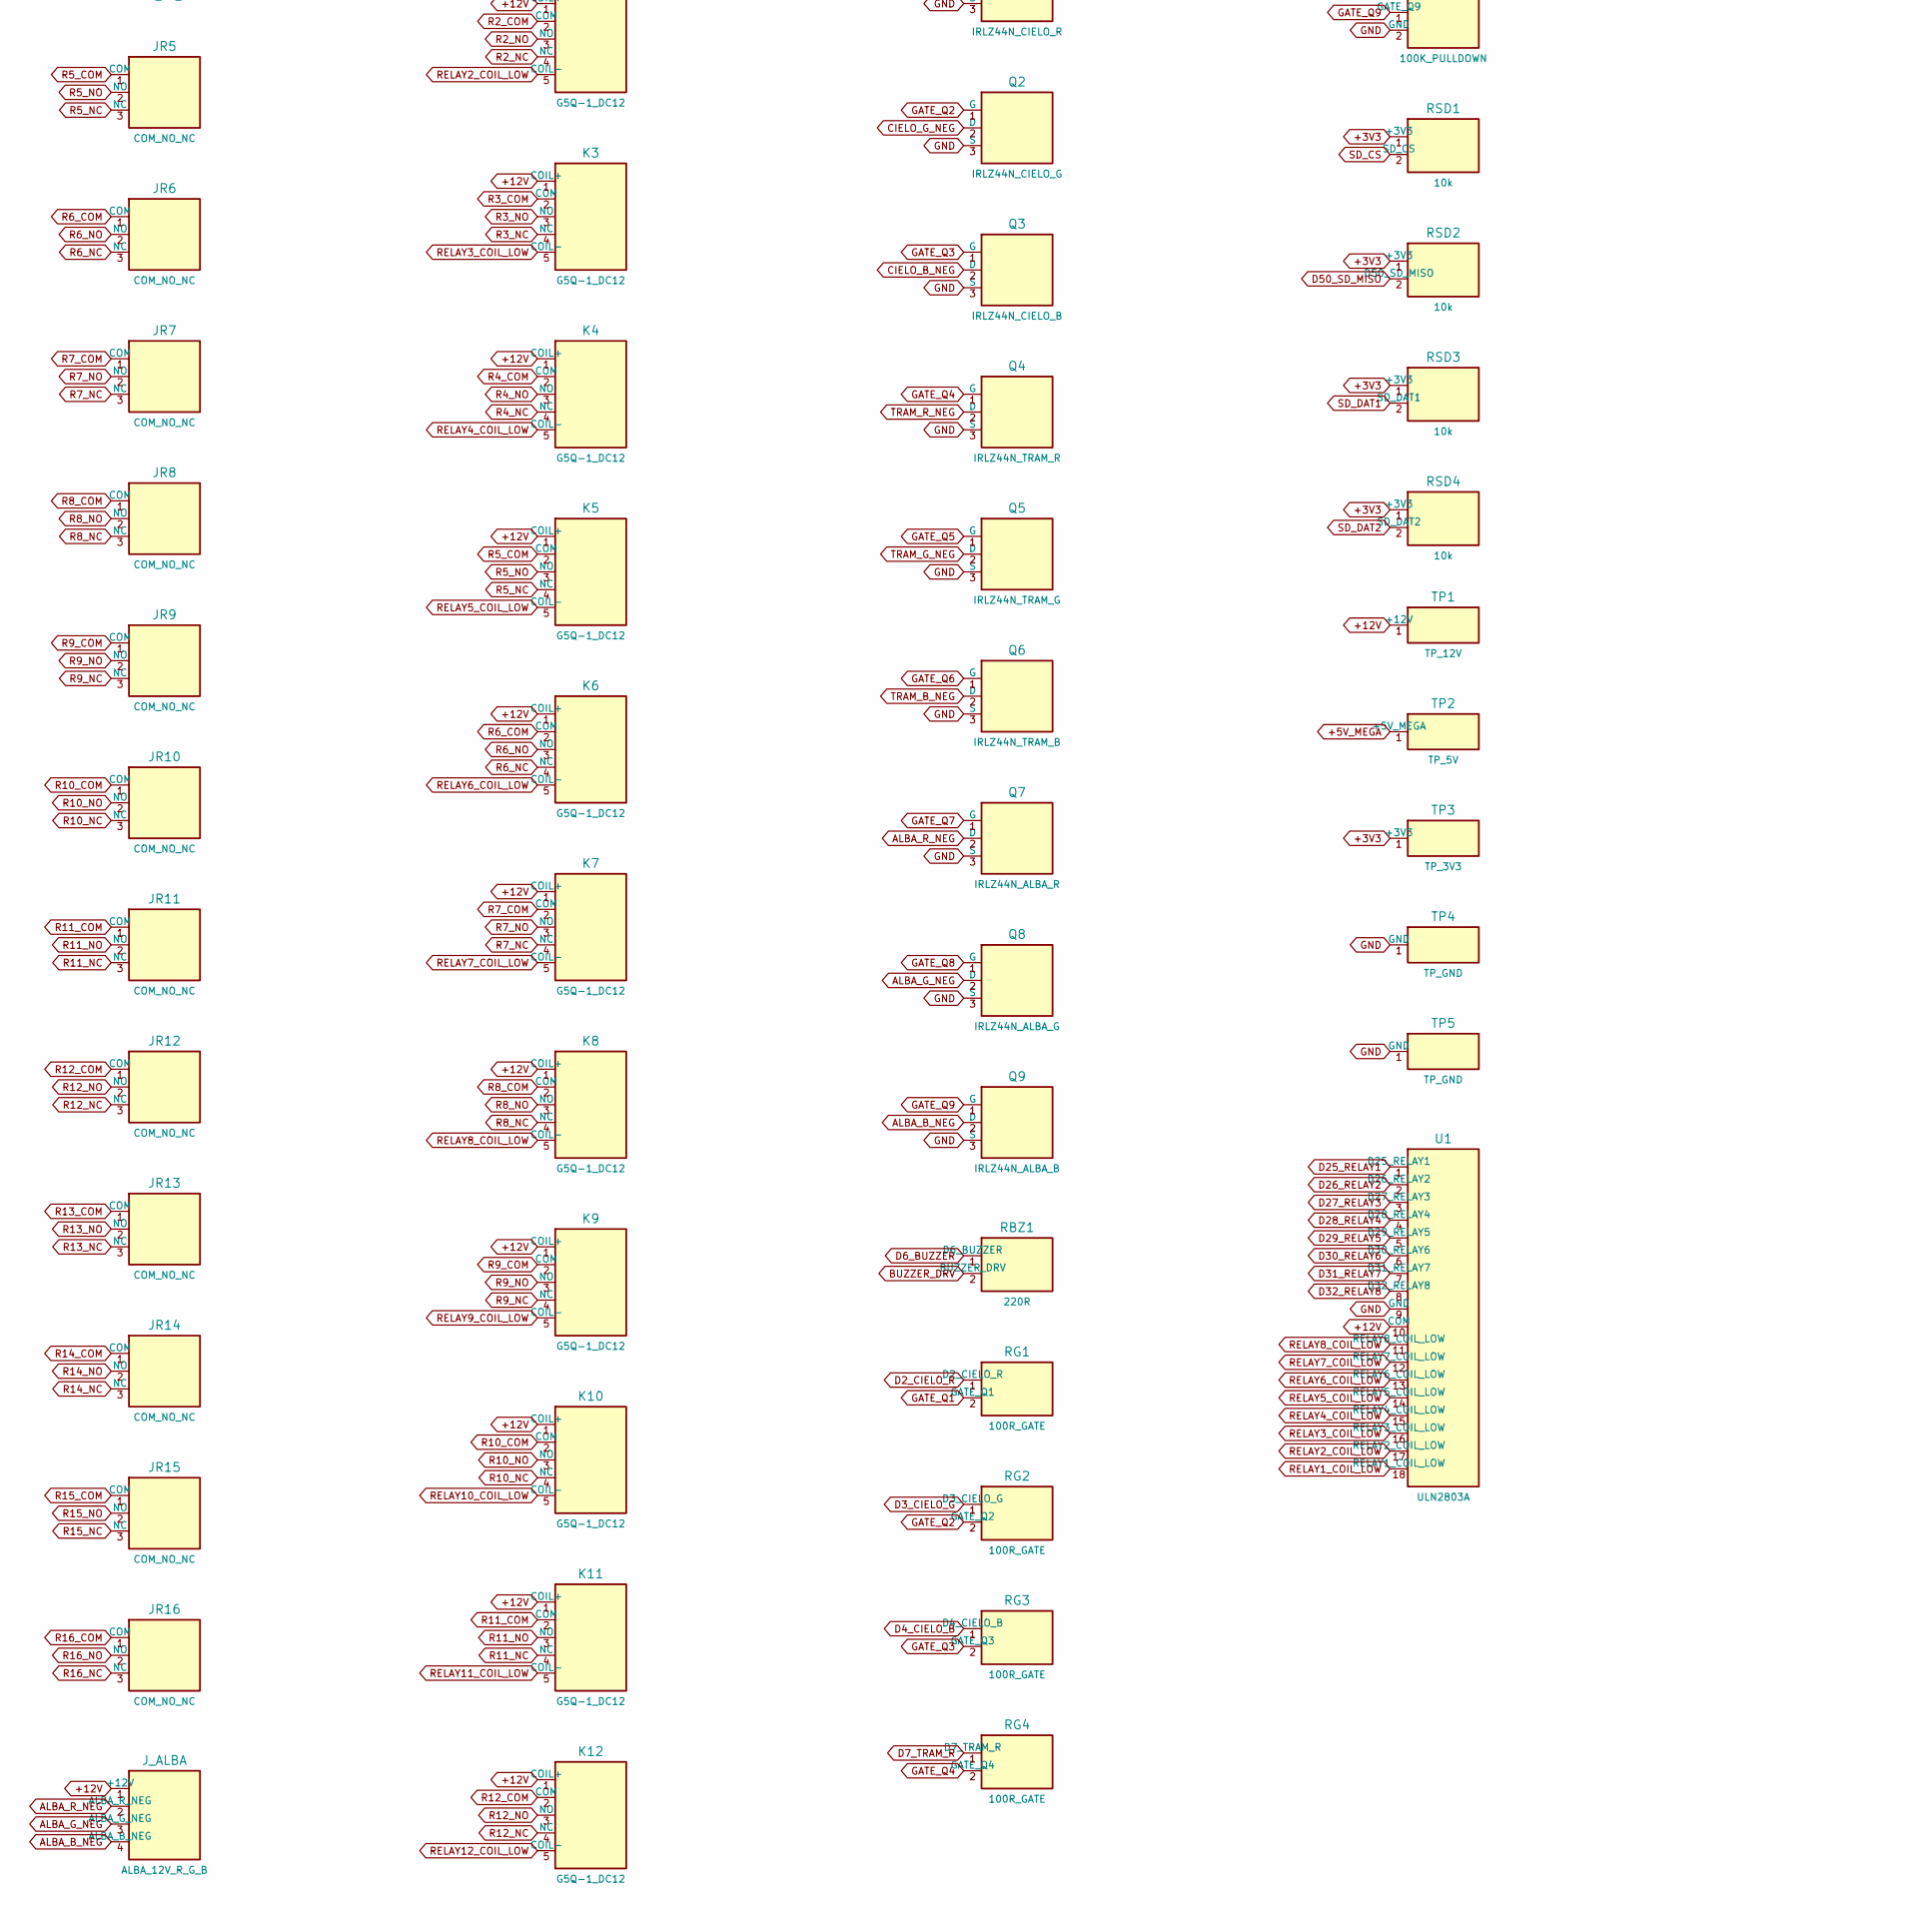
[picture p19: schematic PSN-Presepe-Mega-RevE.kicad_sch, PSN-Presepe Arduino Mega carrier - connectivity schematic, part in row 2, column 1]

Parts:
BZ1: BUZZER_PASSIVE_RM6.5; Buzzer_12x9.5RM6.5
C1: 470uF_25V_RELAY_BULK; CP_Radial_D10.0mm_P5.00mm
C2: 100nF_ULN1; C_Disc_D5.0mm_W2.5mm_P5.00mm
C3: 100nF_ULN2; C_Disc_D5.0mm_W2.5mm_P5.00mm
C4: 10uF_25V; C_0805_2012Metric
C5: 22uF_10V; C_0805_2012Metric
C6, C7: 100nF; C_0805_2012Metric
D1: LED_GREEN_3MM; LED_D3.0mm
J1: 12V_IN; TerminalBlock_Phoenix_MKDS-1,5-2-5.08_1x02_P5.08mm_Horizont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
JR1, JR2, JR3, JR4, JR5, JR6, JR7, JR8, JR9, JR10, JR11, JR12, JR13, JR14, JR15, JR16: COM_NO_NC; TerminalBlock_Phoenix_MKDS-1,5-3-5.08_1x03_P5.08mm_Horizont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
J_ALBA: ALBA_12V_R_G_B; TerminalBlock_Phoenix_MKDS-1,5-4-5.08_1x04_P5.08mm_Horizont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
J_CIELO: CIELO_12V_R_G_B; TerminalBlock_Phoenix_MKDS-1,5-4-5.08_1x04_P5.08mm_Horizont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
J_NEXT: NEXT_GND; TerminalBlock_Phoenix_MKDS-1,5-2-5.08_1x02_P5.08mm_Horizont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
J_OLED: OLED_5V_GND_SDA_SCL; TerminalBlock_Phoenix_MKDS-1,5-4-5.08_1x04_P5.08mm_Horizont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
J_POT: POT_5V_A0_GND; TerminalBlock_Phoenix_MKDS-1,5-3-5.08_1x03_P5.08mm_Horizont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
J_SD: DM3AT-SF-PEJM5; microSD_HC_Hirose_DM3AT-SF-PEJM5
J_START: START_GND; TerminalBlock_Phoenix_MKDS-1,5-2-5.08_1x02_P5.08mm_Horizont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
J_STELLE_01: STELLE_01_12V_GND_DATA; TerminalBlock_Phoenix_MKDS-1,5-3-5.08_1x03_P5.08mm_Horizont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
J_STELLE_02: STELLE_02_12V_GND_DATA; TerminalBlock_Phoenix_MKDS-1,5-3-5.08_1x03_P5.08mm_Horizont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
J_TEST: TEST_GND; TerminalBlock_Phoenix_MKDS-1,5-2-5.08_1x02_P5.08mm_Horizont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
J_TRAMONTO: TRAMONTO_12V_R_G_B; TerminalBlock_Phoenix_MKDS-1,5-4-5.08_1x04_P5.08mm_Horizont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
K1, K2, K3, K4, K5, K6, K7, K8, K9, K10, K11, K12, K13, K14, K15, K16: G5Q-1_DC12; Relay_SPDT_Omron-G5Q-1
MCU1: Arduino_Mega2560_R3_Shield
Q1: IRLZ44N_CIELO_R; TO-220-3_Vertical
Q2: IRLZ44N_CIELO_G; TO-220-3_Vertical
Q3: IRLZ44N_CIELO_B; TO-220-3_Vertical
Q4: IRLZ44N_TRAM_R; TO-220-3_Vertical
Q5: IRLZ44N_TRAM_G; TO-220-3_Vertical
Q6: IRLZ44N_TRAM_B; TO-220-3_Vertical
Q7: IRLZ44N_ALBA_R; TO-220-3_Vertical
Q8: IRLZ44N_ALBA_G; TO-220-3_Vertical
Q9: IRLZ44N_ALBA_B; TO-220-3_Vertical
RBZ1: 220R; R_Axial_DIN0207_L6.3mm_D2.5mm_P10.16mm_Horizontal
RG1, RG2, RG3, RG4, RG5, RG6, RG7, RG8, RG9: 100R_GATE; R_Axial_DIN0207_L6.3mm_D2.5mm_P10.16mm_Horizontal
RLED: 1k; R_0805_2012Metric
RPD1, RPD2, RPD3, RPD4, RPD5, RPD6, RPD7, RPD8, RPD9: 100K_PULLDOWN; R_Axial_DIN0207_L6.3mm_D2.5mm_P10.16mm_Horizontal
RSD1, RSD2, RSD3, RSD4: 10k; R_0805_2012Metric
TP1: TP_12V; TestPoint_THTPad_D2.0mm_Drill1.0mm
TP2: TP_5V; TestPoint_THTPad_D2.0mm_Drill1.0mm
TP3: TP_3V3; TestPoint_THTPad_D2.0mm_Drill1.0mm
TP4, TP5: TP_GND; TestPoint_THTPad_D2.0mm_Drill1.0mm
U1, U2: ULN2803A; DIP-18_W7.62mm
U3: AMS1117-3.3; SOT-223-3_TabPin2
U4: 74LVC125A; SOIC-14_3.9x8.7mm_P1.27mm

Connections:
+3V3: C5.1 (+3V3), C6.1 (+3V3), C7.1 (+3V3), J_SD.4 (+3V3), RSD1.1 (+3V3), RSD2.1 (+3V3), RSD3.1 (+3V3), RSD4.1 (+3V3), TP3.1, U3.2 (+3V3), U4.13 (+3V3), U4.14 (+3V3)
+5V_MEGA: J_OLED.1 (+5V_MEGA), J_POT.1 (+5V_MEGA), MCU1.5V1 (+5V_MEGA), MCU1.5V2 (+5V_MEGA), MCU1.5V3 (+5V_MEGA), MCU1.5V4 (+5V_MEGA), TP2.1
+12V: C1.1 (+12V), C2.1 (+12V), C3.1 (+12V), C4.1 (+12V), J1.1 (+12V), J_ALBA.1 (+12V), J_CIELO.1 (+12V), J_STELLE_01.1 (+12V), J_STELLE_02.1 (+12V), J_TRAMONTO.1 (+12V), K1.1 (COIL+), K2.1 (COIL+), K3.1 (COIL+), K4.1 (COIL+), K5.1 (COIL+), K6.1 (COIL+), K7.1 (COIL+), K8.1 (COIL+), K9.1 (COIL+), K10.1 (COIL+), K11.1 (COIL+), K12.1 (COIL+), K13.1 (COIL+), K14.1 (COIL+), K15.1 (COIL+), K16.1 (COIL+), MCU1.VIN (+12V), TP1.1, U1.10 (COM), U2.10 (COM), U3.3 (+12V)
A0_POT: J_POT.2 (A0_POT), MCU1.A0 (A0_POT)
ALBA_B_NEG: J_ALBA.4 (ALBA_B_NEG), Q9.2 (D)
ALBA_G_NEG: J_ALBA.3 (ALBA_G_NEG), Q8.2 (D)
ALBA_R_NEG: J_ALBA.2 (ALBA_R_NEG), Q7.2 (D)
BUZZER_DRV: BZ1.1 (BUZZER_DRV), RBZ1.2 (BUZZER_DRV)
CIELO_B_NEG: J_CIELO.4 (CIELO_B_NEG), Q3.2 (D)
CIELO_G_NEG: J_CIELO.3 (CIELO_G_NEG), Q2.2 (D)
CIELO_R_NEG: J_CIELO.2 (CIELO_R_NEG), Q1.2 (D)
D2_CIELO_R: MCU1.D2 (D2_CIELO_R), RG1.1 (D2_CIELO_R)
D3_CIELO_G: MCU1.D3 (D3_CIELO_G), RG2.1 (D3_CIELO_G)
D4_CIELO_B: MCU1.D4 (D4_CIELO_B), RG3.1 (D4_CIELO_B)
D5_STELLE_01_DATA: J_STELLE_01.3 (D5_STELLE_01_DATA), MCU1.D5 (D5_STELLE_01_DATA)
D6_BUZZER: MCU1.D6 (D6_BUZZER), RBZ1.1 (D6_BUZZER)
D7_TRAM_R: MCU1.D7 (D7_TRAM_R), RG4.1 (D7_TRAM_R)
D8_STELLE_02_DATA: J_STELLE_02.3 (D8_STELLE_02_DATA), MCU1.D8 (D8_STELLE_02_DATA)
D11_TRAM_G: MCU1.D11 (D11_TRAM_G), RG5.1 (D11_TRAM_G)
D12_TRAM_B: MCU1.D12 (D12_TRAM_B), RG6.1 (D12_TRAM_B)
D13_LED: MCU1.D13 (D13_LED), RLED.1 (D13_LED)
D20_SDA: J_OLED.3 (D20_SDA), MCU1.D20 (D20_SDA)
D21_SCL: J_OLED.4 (D21_SCL), MCU1.D21 (D21_SCL)
D22_START: J_START.1 (D22_START), MCU1.D22 (D22_START)
D23_NEXT: J_NEXT.1 (D23_NEXT), MCU1.D23 (D23_NEXT)
D24_TEST: J_TEST.1 (D24_TEST), MCU1.D24 (D24_TEST)
D25_RELAY1: MCU1.D25 (D25_RELAY1), U1.1 (D25_RELAY1)
D26_RELAY2: MCU1.D26 (D26_RELAY2), U1.2 (D26_RELAY2)
D27_RELAY3: MCU1.D27 (D27_RELAY3), U1.3 (D27_RELAY3)
D28_RELAY4: MCU1.D28 (D28_RELAY4), U1.4 (D28_RELAY4)
D29_RELAY5: MCU1.D29 (D29_RELAY5), U1.5 (D29_RELAY5)
D30_RELAY6: MCU1.D30 (D30_RELAY6), U1.6 (D30_RELAY6)
D31_RELAY7: MCU1.D31 (D31_RELAY7), U1.7 (D31_RELAY7)
D32_RELAY8: MCU1.D32 (D32_RELAY8), U1.8 (D32_RELAY8)
D33_RELAY9: MCU1.D33 (D33_RELAY9), U2.1 (D33_RELAY9)
D34_RELAY10: MCU1.D34 (D34_RELAY10), U2.2 (D34_RELAY10)
D35_RELAY11: MCU1.D35 (D35_RELAY11), U2.3 (D35_RELAY11)
D36_RELAY12: MCU1.D36 (D36_RELAY12), U2.4 (D36_RELAY12)
D37_RELAY13: MCU1.D37 (D37_RELAY13), U2.5 (D37_RELAY13)
D38_RELAY14: MCU1.D38 (D38_RELAY14), U2.6 (D38_RELAY14)
D39_RELAY15: MCU1.D39 (D39_RELAY15), U2.7 (D39_RELAY15)
D40_RELAY16: MCU1.D40 (D40_RELAY16), U2.8 (D40_RELAY16)
D44_ALBA_R: MCU1.D44 (D44_ALBA_R), RG7.1 (D44_ALBA_R)
D45_ALBA_G: MCU1.D45 (D45_ALBA_G), RG8.1 (D45_ALBA_G)
D46_ALBA_B: MCU1.D46 (D46_ALBA_B), RG9.1 (D46_ALBA_B)
D49_SD_CD: J_SD.9 (D49_SD_CD), MCU1.D49 (D49_SD_CD)
D50_SD_MISO: J_SD.7 (D50_SD_MISO), MCU1.D50 (D50_SD_MISO), RSD2.2 (D50_SD_MISO)
D51_SD_MOSI: MCU1.D51 (D51_SD_MOSI), U4.5 (D51_SD_MOSI)
D52_SD_SCK: MCU1.D52 (D52_SD_SCK), U4.2 (D52_SD_SCK)
D53_SD_CS: MCU1.D53 (D53_SD_CS), U4.9 (GND)
GATE_Q1: Q1.1 (G), RG1.2 (GATE_Q1), RPD1.1 (GATE_Q1)
GATE_Q2: Q2.1 (G), RG2.2 (GATE_Q2), RPD2.1 (GATE_Q2)
GATE_Q3: Q3.1 (G), RG3.2 (GATE_Q3), RPD3.1 (GATE_Q3)
GATE_Q4: Q4.1 (G), RG4.2 (GATE_Q4), RPD4.1 (GATE_Q4)
GATE_Q5: Q5.1 (G), RG5.2 (GATE_Q5), RPD5.1 (GATE_Q5)
GATE_Q6: Q6.1 (G), RG6.2 (GATE_Q6), RPD6.1 (GATE_Q6)
GATE_Q7: Q7.1 (G), RG7.2 (GATE_Q7), RPD7.1 (GATE_Q7)
GATE_Q8: Q8.1 (G), RG8.2 (GATE_Q8), RPD8.1 (GATE_Q8)
GATE_Q9: Q9.1 (G), RG9.2 (GATE_Q9), RPD9.1 (GATE_Q9)
GND: BZ1.2 (GND), C1.2 (GND), C2.2 (GND), C3.2 (GND), C4.2 (GND), C5.2 (GND), C6.2 (GND), C7.2 (GND), D1.1 (GND), J1.2 (GND), J_NEXT.2 (GND), J_OLED.2 (GND), J_POT.3 (GND), J_SD.6 (GND), J_SD.10 (GND), J_SD.11 (GND), J_START.2 (GND), J_STELLE_01.2 (GND), J_STELLE_02.2 (GND), J_TEST.2 (GND), MCU1.GND1 (GND), MCU1.GND2 (GND), MCU1.GND3 (GND), MCU1.GND4 (GND), MCU1.GND5 (GND), MCU1.GND6 (GND), Q1.3 (S), Q2.3 (S), Q3.3 (S), Q4.3 (S), Q5.3 (S), Q6.3 (S), Q7.3 (S), Q8.3 (S), Q9.3 (S), RPD1.2 (GND), RPD2.2 (GND), RPD3.2 (GND), RPD4.2 (GND), RPD5.2 (GND), RPD6.2 (GND), RPD7.2 (GND), RPD8.2 (GND), RPD9.2 (GND), TP4.1, TP5.1, U1.9 (GND), U2.9 (GND), U3.1 (GND), U4.1 (GND), U4.4 (GND), U4.7 (GND), U4.10 (COM), U4.12 (GND)
LED_A: D1.2 (LED_A), RLED.2 (LED_A)
R1_COM: JR1.1 (COM), K1.2 (COM)
R1_NC: JR1.3 (NC), K1.4 (NC)
R1_NO: JR1.2 (NO), K1.3 (NO)
R2_COM: JR2.1 (COM), K2.2 (COM)
R2_NC: JR2.3 (NC), K2.4 (NC)
R2_NO: JR2.2 (NO), K2.3 (NO)
R3_COM: JR3.1 (COM), K3.2 (COM)
R3_NC: JR3.3 (NC), K3.4 (NC)
R3_NO: JR3.2 (NO), K3.3 (NO)
R4_COM: JR4.1 (COM), K4.2 (COM)
R4_NC: JR4.3 (NC), K4.4 (NC)
R4_NO: JR4.2 (NO), K4.3 (NO)
R5_COM: JR5.1 (COM), K5.2 (COM)
R5_NC: JR5.3 (NC), K5.4 (NC)
R5_NO: JR5.2 (NO), K5.3 (NO)
R6_COM: JR6.1 (COM), K6.2 (COM)
R6_NC: JR6.3 (NC), K6.4 (NC)
R6_NO: JR6.2 (NO), K6.3 (NO)
R7_COM: JR7.1 (COM), K7.2 (COM)
R7_NC: JR7.3 (NC), K7.4 (NC)
R7_NO: JR7.2 (NO), K7.3 (NO)
R8_COM: JR8.1 (COM), K8.2 (COM)
R8_NC: JR8.3 (NC), K8.4 (NC)
R8_NO: JR8.2 (NO), K8.3 (NO)
R9_COM: JR9.1 (COM), K9.2 (COM)
R9_NC: JR9.3 (NC), K9.4 (NC)
R9_NO: JR9.2 (NO), K9.3 (NO)
R10_COM: JR10.1 (COM), K10.2 (COM)
R10_NC: JR10.3 (NC), K10.4 (NC)
R10_NO: JR10.2 (NO), K10.3 (NO)
R11_COM: JR11.1 (COM), K11.2 (COM)
R11_NC: JR11.3 (NC), K11.4 (NC)
R11_NO: JR11.2 (NO), K11.3 (NO)
R12_COM: JR12.1 (COM), K12.2 (COM)
R12_NC: JR12.3 (NC), K12.4 (NC)
R12_NO: JR12.2 (NO), K12.3 (NO)
R13_COM: JR13.1 (COM), K13.2 (COM)
R13_NC: JR13.3 (NC), K13.4 (NC)
R13_NO: JR13.2 (NO), K13.3 (NO)
R14_COM: JR14.1 (COM), K14.2 (COM)
R14_NC: JR14.3 (NC), K14.4 (NC)
R14_NO: JR14.2 (NO), K14.3 (NO)
R15_COM: JR15.1 (COM), K15.2 (COM)
R15_NC: JR15.3 (NC), K15.4 (NC)
R15_NO: JR15.2 (NO), K15.3 (NO)
R16_COM: JR16.1 (COM), K16.2 (COM)
R16_NC: JR16.3 (NC), K16.4 (NC)
R16_NO: JR16.2 (NO), K16.3 (NO)
RELAY1_COIL_LOW: K1.5 (COIL-), U1.18 (RELAY1_COIL_LOW)
RELAY2_COIL_LOW: K2.5 (COIL-), U1.17 (RELAY2_COIL_LOW)
RELAY3_COIL_LOW: K3.5 (COIL-), U1.16 (RELAY3_COIL_LOW)
RELAY4_COIL_LOW: K4.5 (COIL-), U1.15 (RELAY4_COIL_LOW)
RELAY5_COIL_LOW: K5.5 (COIL-), U1.14 (RELAY5_COIL_LOW)
RELAY6_COIL_LOW: K6.5 (COIL-), U1.13 (RELAY6_COIL_LOW)
RELAY7_COIL_LOW: K7.5 (COIL-), U1.12 (RELAY7_COIL_LOW)
RELAY8_COIL_LOW: K8.5 (COIL-), U1.11 (RELAY8_COIL_LOW)
RELAY9_COIL_LOW: K9.5 (COIL-), U2.18 (RELAY9_COIL_LOW)
RELAY10_COIL_LOW: K10.5 (COIL-), U2.17 (RELAY10_COIL_LOW)
RELAY11_COIL_LOW: K11.5 (COIL-), U2.16 (RELAY11_COIL_LOW)
RELAY12_COIL_LOW: K12.5 (COIL-), U2.15 (RELAY12_COIL_LOW)
RELAY13_COIL_LOW: K13.5 (COIL-), U2.14 (RELAY13_COIL_LOW)
RELAY14_COIL_LOW: K14.5 (COIL-), U2.13 (RELAY14_COIL_LOW)
RELAY15_COIL_LOW: K15.5 (COIL-), U2.12 (RELAY15_COIL_LOW)
RELAY16_COIL_LOW: K16.5 (COIL-), U2.11 (RELAY16_COIL_LOW)
SD_CLK: J_SD.5 (SD_CLK), U4.3 (SD_CLK)
SD_CMD: J_SD.3 (SD_CMD), U4.6 (SD_CMD)
SD_CS: J_SD.2 (SD_CS), RSD1.2 (SD_CS), U4.8 (SD_CS)
SD_DAT1: J_SD.8 (SD_DAT1), RSD3.2 (SD_DAT1)
SD_DAT2: J_SD.1 (SD_DAT2), RSD4.2 (SD_DAT2)
TRAM_B_NEG: J_TRAMONTO.4 (TRAM_B_NEG), Q6.2 (D)
TRAM_G_NEG: J_TRAMONTO.3 (TRAM_G_NEG), Q5.2 (D)
TRAM_R_NEG: J_TRAMONTO.2 (TRAM_R_NEG), Q4.2 (D)

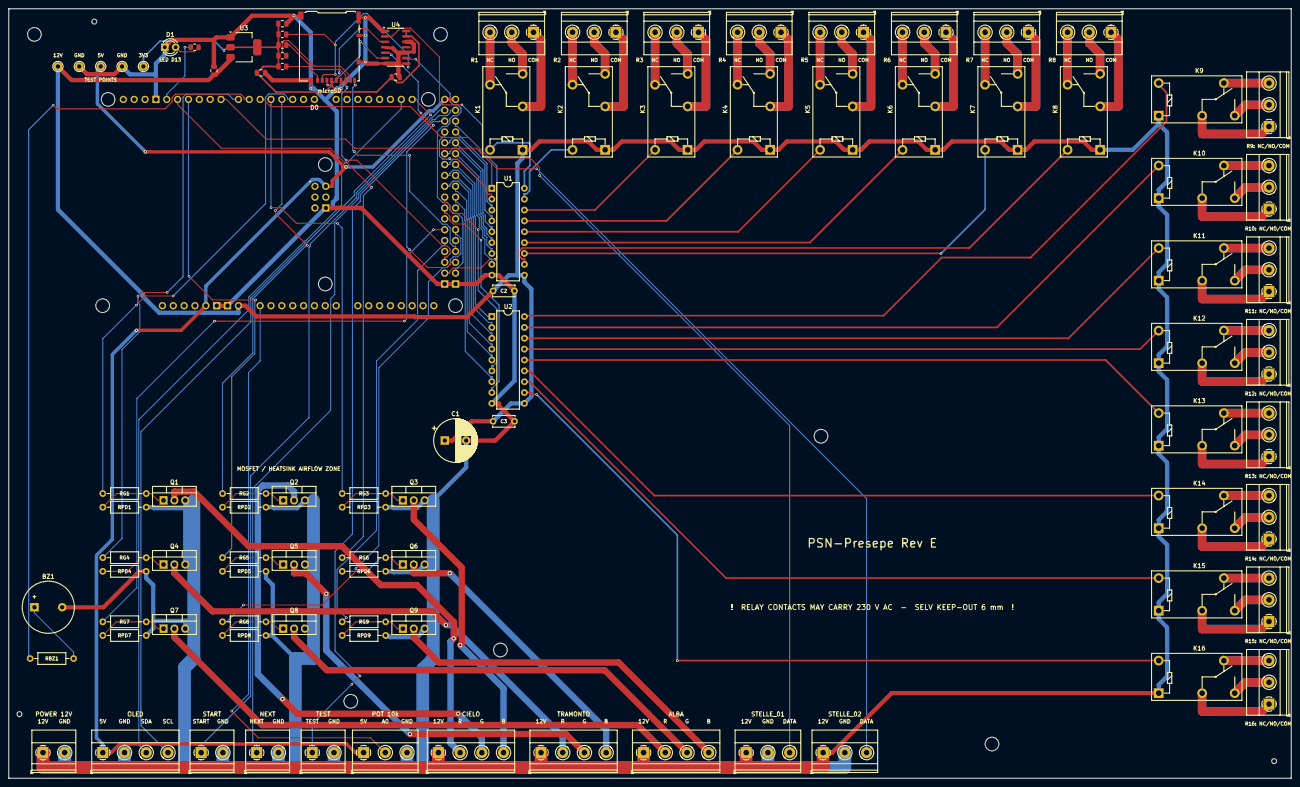
[picture p20: board PSN-Presepe-Mega-RevE.kicad_pcb from above]

Board: 2 copper layers, 300.0 x 180.0 mm, 105 parts (0 on the bottom side), 133 nets.

Other parts of the board:
H1, H2, H3, H4, H5, H6: M3_NPTH; MountingHole_3.2mm_M3
TH1, TH2, TH3: ToolingHole; ToolingHole_JLC_1.152mm_NPTH
