zanac/PSN-Presepe-2026/firmware/PSN-Presepe/PSN-Presepe.ino

/*
  PresepeController - Rev D (PCB PSN-Presepe Rev D)
  Arduino Mega 2560

  FILE UNICO: tutto il firmware sta in questo .ino (aprilo con l'IDE Arduino o
  copialo in sketch.ino su Wokwi). Il blocco CONFIG BEGIN/END contiene il lettore
  di PRESEPE.INI ed e' verificato su PC da firmware/tools/run_tests.sh.

  NOVITA' REV D
    - Parametri della scenografia letti all'avvio da microSD (/PRESEPE.INI, oppure
      /PRESEPE.TXT se manca il primo):
      durate del ciclo, fasi, schedulazione rele', nomi rele', colori,
      stelle (due catene), buzzer/OLED/autotest. Senza SD -> valori di default.
    - microSD su SPI: D50 MISO, D51 MOSI, D52 SCK, D53 CS, D49 rilevamento scheda.
    - Potenziometro esterno su morsetto J_POT (5V / A0 / GND).
    - Due catene di stelle WS2811 uguali: STELLE_01 su D5 e STELLE_02 su D8, ognuna
      con la sua sezione [STELLE_01] / [STELLE_02] (per due zone del cielo).

  USCITE (PCB Rev D)
    D2/D3/D4    = CIELO RGB R/G/B      -> MOSFET Q1-Q3 -> morsetto J_CIELO (12V comune, R-, G-, B-)
    D7/D11/D12  = TRAMONTO RGB R/G/B   -> MOSFET Q4-Q6 -> morsetto J_TRAMONTO
    D44/D45/D46 = ALBA RGB R/G/B       -> MOSFET Q7-Q9 -> morsetto J_ALBA
    D5          = DATA WS2811 STELLE_01 -> morsetto J_STELLE (Rev D) / J_STELLE_01 (Rev E) (12V / GND / DATA)
    D8          = DATA WS2811 STELLE_02 -> morsetto J_CASETTE (Rev D) / J_STELLE_02 (Rev E) (12V / GND / DATA)
    D6          = buzzer passivo (220 ohm in serie, BZ1 sulla scheda)
    D25..D40    = rele' 1..16 tramite ULN2803A U1/U2 -> morsetti JR1..JR16 (COM/NO/NC)

  COMANDI (pulsanti NO verso GND, INPUT_PULLUP: nessuna resistenza esterna)
    D22 = START/STOP   (morsetto J_START): breve = pausa/ripresa, tenuto 2 s = STOP
                       (tutto spento), in STOP breve = PLAY (ciclo dall'inizio del GIORNO)
    D23 = AVANTI/NEXT  (morsetto J_NEXT)
    D24 = TEST         (morsetto J_TEST)
    A0  = potenziometro lineare 10k esterno (morsetto J_POT: 5V / cursore / GND)

  DISPLAY E SD
    D20 SDA / D21 SCL = OLED SSD1306 128x64 I2C 0x3C (morsetto J_OLED: 5V / GND / SDA / SCL)
    D49 = rilevamento scheda microSD, D50-D53 = SPI microSD (MISO/MOSI/SCK/CS)

  CICLO
    GIORNO -> TRAMONTO -> CREPUSCOLO -> NOTTE -> ALBA -> GIORNO
    Il potenziometro sceglie fra tre durate del ciclo ([CICLO] durata1..3,
    default 1, 3 o 5 minuti).

  Serial Monitor: 115200 baud
*/

#include <Arduino.h>
#include <Adafruit_NeoPixel.h>
#include <Wire.h>
#include <Adafruit_GFX.h>
#include <Adafruit_SSD1306.h>
#include <SPI.h>
#include <SD.h>
// (blocco CONFIG piu' sotto, prima della prima funzione: vedi CONFIG BEGIN)

// ============================================================
// CONFIGURAZIONE PIN
// ============================================================

const uint8_t PIN_CIELO_R = 2;
const uint8_t PIN_CIELO_G = 3;
const uint8_t PIN_CIELO_B = 4;
const uint8_t PIN_STELLE_01_DATA = 5;   // catena WS2811 STELLE_01
const uint8_t PIN_STELLE_02_DATA = 8;   // catena WS2811 STELLE_02 (stesso funzionamento)
const uint8_t PIN_BUZZER = 6; // piezo passivo opzionale: se assente il firmware funziona normalmente

// Strisce RGB laterali da 1 m, dedicate agli effetti direzionali.
// Sinistra = tramonto; destra = alba.
const uint8_t PIN_TRAMONTO_R = 7;
const uint8_t PIN_TRAMONTO_G = 11;
const uint8_t PIN_TRAMONTO_B = 12;
const uint8_t PIN_ALBA_R = 44;
const uint8_t PIN_ALBA_G = 45;
const uint8_t PIN_ALBA_B = 46;
// Due catene di stelle identiche: indice 0 = STELLE_01, 1 = STELLE_02 (sezioni [STELLE_01] e [STELLE_02]).
Adafruit_NeoPixel stelle01(50, PIN_STELLE_01_DATA, NEO_GRB + NEO_KHZ800);   // lunghezza aggiornata da cfg nel setup
Adafruit_NeoPixel stelle02(50, PIN_STELLE_02_DATA, NEO_GRB + NEO_KHZ800);
Adafruit_NeoPixel *const catena[2] = { &stelle01, &stelle02 };

const uint8_t PIN_START = 22;
const uint8_t PIN_NEXT  = 23;
const uint8_t PIN_TEST  = 24;
const uint8_t PIN_POT   = A0;   // Rev D: potenziometro esterno su morsetto J_POT
const uint8_t PIN_SD_CS = 53;   // microSD chip select (SPI hardware: D50 MISO, D51 MOSI, D52 SCK)
const uint8_t PIN_SD_CD = 49;   // contatto "scheda inserita" dello slot (LOW = inserita)
// LED di stato (PCB Rev E: LED verde D1 + RLED su D13). D13 e' libero anche sulla Rev D,
// dove lampeggia solo il LED "L" della Mega sotto lo shield. Nome senza PIN_ di proposito:
// le verifiche della Rev D controllano che ogni PIN_ arrivi a una pista della scheda.
const uint8_t LED_STATO = 13;


// -----------------------------------------------------------------------------
// RELÈ: 16 uscite ON/OFF (G5Q-1 sulla PCB, pilotati da ULN2803A U1/U2).
// D25-D40 = rele' 1..16 (Grp_GG_RR: gruppo GG 01..04, rele' RR 01..04).
// La logica scenografica usa una tabella di schedulazione per fase/percentuale.
// -----------------------------------------------------------------------------
const uint8_t PIN_RELE[16] = {
  25, 26, 27, 28,
  29, 30, 31, 32,
  33, 34, 35, 36,
  37, 38, 39, 40
};

#define PWM_INVERTED (cfg.pwmInvertito)
#define RELE_ACTIVE_LOW (cfg.releAttivoBasso)   // [RELE] logica = alta|bassa
#define BUZZER_ENABLED (cfg.buzzer)             // [SISTEMA] buzzer = 0 silenzia tutto

// OLED ELEGOO EL-SM-008, 128x64, I2C 0x3C.
// Il display e' opzionale: se assente il presepe continua normalmente.
const uint8_t OLED_ADDR = 0x3C;
const uint8_t OLED_W = 128;
const uint8_t OLED_H = 64;
Adafruit_SSD1306 display(OLED_W, OLED_H, &Wire, -1);
bool oledPresente = false;
unsigned long oledPopupFino = 0;
enum OledPopup : uint8_t { OLED_NESSUNO, OLED_PAUSA, OLED_RIPRESA, OLED_AVANTI, OLED_TEST, OLED_VELOCITA, OLED_PLAY };
OledPopup oledPopup = OLED_NESSUNO;
int ultimoPotOled = -1;
int potRawOled = 0;
int potPopupUltimaLettura = -1;
unsigned long potPopupUltimaVariazioneMs = 0;
bool potPopupInAttesa = false;
const int POT_POPUP_DELTA = 60;
const unsigned long POT_POPUP_SETTLE_MS = 3000UL;
const unsigned long OLED_POPUP_MS = 1800UL;

// Tre velocita' discrete scelte dal potenziometro: durate da [CICLO] durata1..3
// (default 1, 3, 5 minuti). Corsa utile del pot da [CICLO] pot_min / pot_max.
#define MIN_CYCLE_MS (cfg.durataMs[0])
#define MID_CYCLE_MS (cfg.durataMs[1])
#define MAX_CYCLE_MS (cfg.durataMs[2])

// Tasti della modalita' colore (dichiarati qui, prima di ogni funzione, per i
// prototipi automatici dell'IDE Arduino).
struct TastoColore {
  uint8_t pin;
  bool stabile, ultimaLettura, lungoFatto;
  unsigned long cambioMs, premutoMs;
};
enum EventoTasto : uint8_t { TASTO_NULLA = 0, TASTO_BREVE, TASTO_LUNGO };

// ==== CONFIG BEGIN ====
// Parametri da microSD: strutture, valori di default, lettore di PRESEPE.INI.
// Questo blocco (fino a CONFIG END) e' indipendente dall'hardware tranne le parti
// #ifdef ARDUINO: firmware/tools/run_tests.sh lo estrae e lo verifica su PC.
// =============================================================================
// PresepeConfig - parametri della scenografia caricati da microSD (PRESEPE.INI)
// =============================================================================
// Ogni parametro ha un valore di default identico al comportamento del firmware
// precedente. All'avvio il firmware legge /PRESEPE.INI dalla microSD: le chiavi
// presenti sostituiscono il default, quelle assenti o errate restano di default.
// Senza SD (o senza file) si usano solo i default.
//
// Il parser e' indipendente dall'hardware (cfgParseBuffer / cfgParseLine) e
// viene verificato anche su PC con test automatici (tools/test_config.cpp).
// =============================================================================
#include <stdint.h>

#define CFG_MAX_STELLE   100   // pixel WS2811 massimi per catena di stelle
#define CFG_NUM_CATENE     2   // catene di stelle: [STELLE_01] e [STELLE_02]
#define CFG_MAX_COSTELLAZIONI 8 // righe "costellazione" di [COSTELLAZIONI]
#define CFG_MAX_EVENTI    64   // righe "evento" della schedulazione rele'
#define CFG_NOME_LEN      13   // 12 caratteri + terminatore (nome rele' su OLED)
#define CFG_MAX_TAPPE     20   // tappe di colore massime per striscia RGB (CIELO / TRAMONTO / ALBA)
#define CFG_SSID_LEN      33   // SSID WiFi: max 32 caratteri + terminatore
#define CFG_WPWD_LEN      64   // password WPA/WPA2: 8..63 caratteri (vuota = rete aperta)
#define CFG_HOST_LEN      25   // nome in rete (mDNS): max 24 caratteri a-z 0-9 -
#define CFG_UTENTE_LEN    33   // utente e password della pagina web: max 32 caratteri
#define CFG_FILE_NAME     "PRESEPE.INI"   // file cercato per primo nella radice della microSD
#define CFG_FILE_NAME_ALT "PRESEPE.TXT"   // alternativa (Wokwi non accetta file .ini; utile anche su Windows)

enum CfgFase : uint8_t { CFG_GIORNO = 0, CFG_TRAMONTO, CFG_CREPUSCOLO, CFG_NOTTE, CFG_ALBA };

struct CfgRGB { uint8_t r, g, b; };

struct CfgEvento {          // { FASE, RELE', ACCESO, % DELLA FASE }
  uint8_t fase;             // CfgFase
  uint8_t rele;             // 0..15
  uint8_t acceso;           // 0/1
  uint8_t pct;              // 0..100
};

enum CfgForza : uint8_t { FORZA_AUTO = 0, FORZA_ON = 1, FORZA_OFF = 2 };

// Strisce RGB analogiche con colori a tappe ([CIELO], [TRAMONTO], [ALBA]).
enum CfgStriscia : uint8_t { CFG_S_CIELO = 0, CFG_S_TRAMONTO, CFG_S_ALBA, CFG_NUM_STRISCE };
// Come si arriva a una tappa partendo dalla precedente.
enum CfgCurva : uint8_t { CURVA_MORBIDA = 0,   // parte e arriva piano (smoothstep), come le dissolvenze storiche
                          CURVA_LINEARE = 1 }; // velocita' costante per tutto il tratto

// Aggancio del potenziometro nella modalita' colore (vedi cfgAggancioAggiorna).
struct CfgAggancio { uint8_t agganciato; int8_t lato; };   // lato: -1 sotto, +1 sopra, 0 ignoto

struct CfgTappa {           // "tappa = FASE, %, R, G, B [, curva]"
  uint8_t fase;             // CfgFase
  uint8_t curva;            // CfgCurva del tratto che ARRIVA a questa tappa
  float   pct;              // 0..100 % della fase
  CfgRGB  col;              // colore da avere esattamente in quel punto
};

enum CfgSdStato : uint8_t {
  SD_NON_LETTA = 0,   // lettura non tentata
  SD_ASSENTE,         // nessuna scheda / init fallita
  SD_NO_FILE,         // scheda presente ma PRESEPE.INI mancante
  SD_OK,              // file letto senza errori
  SD_OK_ERRORI        // file letto, alcune righe ignorate (vedi primaRigaErrata)
};

// Una catena di stelle ([STELLE_01] o [STELLE_02]): stessi parametri per entrambe.
struct CfgStelle {
  uint16_t numero;                        // pixel della catena (0 = non usata)
  uint8_t  attive, lumMin, lumMax, livelloNotte;
  uint16_t scintillioMinMs, scintillioMaxMs;
  CfgRGB   colore;                        // tinta in % per canale (100,72,38 = bianco caldo)
};

// [COSTELLAZIONE]: una sezione per costellazione.
enum CfgModoCost { COST_INSIEME, COST_UNA_ALLA_VOLTA, COST_SCINTILLA };
struct CfgPunto { uint8_t fase, pct; };     // FASE (0..4) e % della fase
struct CfgCostellazione {
  uint8_t  lum;             // luminosita' piena 0..255
  uint8_t  modo;            // CfgModoCost
  bool     haColore;        // colore proprio, altrimenti quello della catena di ogni stella
  CfgRGB   colore;          // tinta in % per canale
  CfgPunto acc[2], sp[2];   // accensione da..a, spegnimento da..a (posizioni nel ciclo)
  uint8_t  n0, n;           // stelle in STELLE_01 e in tutto (le conta cfgValida)
};

struct PresepeConfig {
  // [CICLO]
  uint32_t durataMs[3];      // 3 scaglioni selezionati dal potenziometro
  int16_t  potMin, potMax;   // corsa utile letta su A0
  uint8_t  potInvertito;     // 1 = pot cablato al contrario (comportamento storico)
  uint8_t  partenzaInPausa;  // 1 = dopo il boot il ciclo parte in PAUSA
  // [FASI] inizio di ogni fase in % del ciclo (GIORNO parte da 0)
  float    pTramonto, pCrepuscolo, pNotte, pAlba;
  // [RELE]
  uint8_t  releAttivoBasso;
  uint8_t  forza[16];
  char     nome[16][CFG_NOME_LEN];
  CfgEvento eventi[CFG_MAX_EVENTI];
  uint8_t  numEventi;
  // [CIELO] [TRAMONTO] [ALBA] - colori a tappe, in ordine di tempo nel ciclo
  CfgTappa tappe[CFG_NUM_STRISCE][CFG_MAX_TAPPE];
  uint8_t  numTappe[CFG_NUM_STRISCE];
  // [COLORI]
  uint8_t  lumCielo, lumTramonto, lumAlba; // limite luminosita' 0..100 %
  uint8_t  gamma, pwmInvertito;
  // [STELLE_01] [STELLE_02]
  CfgStelle stelle[CFG_NUM_CATENE];
  // [COSTELLAZIONE] (una sezione per costellazione) gruppi di stelle, anche di catene
  // diverse, esclusi dalle stelle scelte a caso
  uint8_t  numCostellazioni;
  CfgCostellazione cost[CFG_MAX_COSTELLAZIONI];
  // costellazione di ogni stella, 4 bit per stella (0 = libera): cfgCost() / cfgSetCost()
  uint8_t  costStella[CFG_NUM_CATENE][CFG_MAX_STELLE / 2];
  // [SISTEMA]
  uint8_t  buzzer, melodiaAvvio, autotestAvvio, oled;
  uint8_t  fastboot;                      // 1 = avvio rapido: niente schermata SD, autotest e melodia (lo splash di 3 s resta)
  uint16_t beepHz, beepMs;
  uint32_t debugMs;
  // [WIFI] scheda Mega + WiFi (ESP8266 collegato alla Serial3)
  uint8_t  wifiAbilitato;                 // 0 = Serial3 non usata: come un Mega senza WiFi, 1 = rete di casa,
                                          // 2 = access point, 3 = rete di casa, se non si collega access point
  char     wifiSsid[CFG_SSID_LEN];
  char     wifiPassword[CFG_WPWD_LEN];
  char     wifiNome[CFG_HOST_LEN];        // nome in rete: http://<nome>.local
  // [ACCESS_POINT] rete creata dall'ESP8266 (abilitato = 2, oppure 3 senza rete di casa)
  char     apSsid[CFG_SSID_LEN];
  char     apPassword[CFG_WPWD_LEN];
  uint8_t  apCanale, apNascosta, apMaxClient, apPortale;
  uint8_t  apIp[4];
  uint16_t apAttesa;                      // abilitato = 3: secondi di tentativi sulla rete di casa
  // [AUTENTICAZIONE] utente e password della pagina web
  char     webUtente[CFG_UTENTE_LEN];
  char     webPassword[CFG_UTENTE_LEN];
  // stato lettura (non configurabile)
  uint8_t  sdStato;
  uint16_t righeLette, errori, primaRigaErrata;
  uint8_t  eventiDaFile;                  // 1 = la schedulazione arriva dal file
  uint8_t  tappeDaFile[CFG_NUM_STRISCE];  // bit f = le tappe di quella striscia nella fase f arrivano dal file
};

extern PresepeConfig cfg;

void cfgDefault(PresepeConfig &c);
// Elabora una singola riga (modifica 'riga'). 'sezione' mantiene lo stato tra le righe.
void cfgParseLine(PresepeConfig &c, char *riga, char *sezione, uint16_t numeroRiga);
// Elabora un testo completo (usato dai test su PC).
void cfgParseBuffer(PresepeConfig &c, const char *testo);
// Controlli di coerenza finali (fasi crescenti, limiti, ecc.).
void cfgValida(PresepeConfig &c);
const char *cfgNomeFase(uint8_t f);
// Posizione nel ciclo (0..100 %) del punto "pct % della fase".
float cfgPosizione(const PresepeConfig &c, uint8_t fase, float pct);
// Colore della striscia 's' nel punto 'p' (0..100 %) del ciclo, calcolato dalle tappe.
CfgRGB cfgColoreTappe(const PresepeConfig &c, uint8_t s, float p);

#ifdef ARDUINO
// Legge /PRESEPE.INI dalla microSD (pin CS). Ritorna lo stato in cfg.sdStato.
uint8_t cfgCaricaDaSD(uint8_t pinCS, uint8_t pinCD);
// Nome del file effettivamente letto (CFG_FILE_NAME o CFG_FILE_NAME_ALT).
extern const char *cfgFileLetto;
#endif

#include <string.h>
#include <stdlib.h>
#include <ctype.h>
#ifdef ARDUINO
  #include <Arduino.h>
  #include <SPI.h>
  #include <SD.h>
#else
  #include <strings.h>
#endif

PresepeConfig cfg;

static const char *const NOMI_FASE[5] = { "GIORNO", "TRAMONTO", "CREPUSCOLO", "NOTTE", "ALBA" };
const char *cfgNomeFase(uint8_t f) { return f < 5 ? NOMI_FASE[f] : "?"; }

static CfgRGB rgb(uint8_t r, uint8_t g, uint8_t b) { CfgRGB c = { r, g, b }; return c; }

static void tappa(PresepeConfig &c, uint8_t s, uint8_t fase, float pct, uint8_t r, uint8_t g, uint8_t b) {
  CfgTappa &t = c.tappe[s][c.numTappe[s]++];
  t.fase = fase; t.pct = pct; t.col = rgb(r, g, b); t.curva = CURVA_MORBIDA;
}

// Curve storiche (fino al firmware Rev D senza tappe), tutte con curva morbida.
static void cfgTappeDefault(PresepeConfig &c) {
  for (uint8_t s = 0; s < CFG_NUM_STRISCE; s++) c.numTappe[s] = 0;
  // In ordine di tempo; ogni fase in cui la striscia lavora ha la tappa di inizio (0) e di fine (100).
  // CIELO: caldo -> quasi bianco al 30 % del GIORNO -> bianco pieno 45..55 % -> quasi bianco
  // al 70 % -> caldo a fine giorno; nel TRAMONTO sbiadisce e si spegne; resta spento fino al
  // 38 % dell'ALBA, si accende rapidamente (1 %) a un minimo caldo e sale fino al GIORNO.
  tappa(c, CFG_S_CIELO, CFG_GIORNO,     0.0f, 210,  82,  18);
  tappa(c, CFG_S_CIELO, CFG_GIORNO,    30.0f, 246, 220, 208);
  tappa(c, CFG_S_CIELO, CFG_GIORNO,    45.0f, 255, 255, 255);
  tappa(c, CFG_S_CIELO, CFG_GIORNO,    55.0f, 255, 255, 255);
  tappa(c, CFG_S_CIELO, CFG_GIORNO,    70.0f, 246, 220, 208);
  tappa(c, CFG_S_CIELO, CFG_GIORNO,   100.0f, 210,  82,  18);
  tappa(c, CFG_S_CIELO, CFG_TRAMONTO,   0.0f, 210,  82,  18);
  tappa(c, CFG_S_CIELO, CFG_TRAMONTO,  30.0f,  16,  16,  16);
  tappa(c, CFG_S_CIELO, CFG_TRAMONTO,  38.0f,   0,   0,   0);
  tappa(c, CFG_S_CIELO, CFG_TRAMONTO, 100.0f,   0,   0,   0);
  tappa(c, CFG_S_CIELO, CFG_ALBA,       0.0f,   0,   0,   0);
  tappa(c, CFG_S_CIELO, CFG_ALBA,      38.0f,   0,   0,   0);
  tappa(c, CFG_S_CIELO, CFG_ALBA,      39.0f,  10,   4,   1);
  tappa(c, CFG_S_CIELO, CFG_ALBA,     100.0f, 210,  82,  18);
  // TRAMONTO (striscia sinistra): accesa solo nella fase TRAMONTO, accensione rapida (1 %).
  tappa(c, CFG_S_TRAMONTO, CFG_TRAMONTO,   0.0f,   0,  0,  0);
  tappa(c, CFG_S_TRAMONTO, CFG_TRAMONTO,   1.0f,  18, 10,  4);
  tappa(c, CFG_S_TRAMONTO, CFG_TRAMONTO,  10.0f, 155, 92, 16);
  tappa(c, CFG_S_TRAMONTO, CFG_TRAMONTO,  82.0f,  16, 16, 16);
  tappa(c, CFG_S_TRAMONTO, CFG_TRAMONTO, 100.0f,   0,  0,  0);
  // ALBA (striscia destra): accesa solo nella fase ALBA, accensione rapida (1 %).
  tappa(c, CFG_S_ALBA, CFG_ALBA,   0.0f,   0,  0,  0);
  tappa(c, CFG_S_ALBA, CFG_ALBA,   1.0f,  18, 12,  5);
  tappa(c, CFG_S_ALBA, CFG_ALBA,  38.0f, 155, 78, 22);
  tappa(c, CFG_S_ALBA, CFG_ALBA,  82.0f,  16, 16, 16);
  tappa(c, CFG_S_ALBA, CFG_ALBA, 100.0f,   0,  0,  0);
}

float cfgPosizione(const PresepeConfig &c, uint8_t fase, float pct) {
  const float inizio[5] = { 0.0f, c.pTramonto, c.pCrepuscolo, c.pNotte, c.pAlba };
  const float fine[5]   = { c.pTramonto, c.pCrepuscolo, c.pNotte, c.pAlba, 100.0f };
  if (fase > 4) fase = 4;
  return inizio[fase] + (fine[fase] - inizio[fase]) * pct / 100.0f;
}

// Stessa aritmetica di interpola8() dello sketch (troncamento).
static uint8_t interp8(uint8_t da, uint8_t a, float t) {
  if (t < 0.0f) t = 0.0f;
  if (t > 1.0f) t = 1.0f;
  return (uint8_t)(da + ((float)a - da) * t);
}

CfgRGB cfgColoreTappe(const PresepeConfig &c, uint8_t s, float p) {
  const uint8_t n = c.numTappe[s];
  if (n == 0) return rgb(0, 0, 0);
  const CfgTappa *t = c.tappe[s];
  if (n == 1) return t[0].col;
  // tappa precedente = l'ultima con posizione <= p (a pari posizione vince l'ultima: "scatto")
  int8_t prec = -1;
  for (uint8_t i = 0; i < n; i++) if (cfgPosizione(c, t[i].fase, t[i].pct) <= p) prec = i;
  float pPrec, pSucc; uint8_t succ;
  if (prec < 0) {                       // prima della prima tappa: arriva dall'ultima del giro prima
    prec = n - 1; succ = 0;
    pPrec = cfgPosizione(c, t[prec].fase, t[prec].pct) - 100.0f;
    pSucc = cfgPosizione(c, t[0].fase, t[0].pct);
  } else {
    pPrec = cfgPosizione(c, t[prec].fase, t[prec].pct);
    if (prec + 1 < n) { succ = prec + 1; pSucc = cfgPosizione(c, t[succ].fase, t[succ].pct); }
    else { succ = 0; pSucc = cfgPosizione(c, t[0].fase, t[0].pct) + 100.0f; }   // giro del ciclo
  }
  float x = (pSucc > pPrec) ? (p - pPrec) / (pSucc - pPrec) : 1.0f;
  if (x < 0.0f) x = 0.0f;
  if (x > 1.0f) x = 1.0f;
  if (t[succ].curva == CURVA_MORBIDA) x = x * x * (3.0f - 2.0f * x);
  return rgb(interp8(t[prec].col.r, t[succ].col.r, x),
             interp8(t[prec].col.g, t[succ].col.g, x),
             interp8(t[prec].col.b, t[succ].col.b, x));
}

void cfgDefault(PresepeConfig &c) {
  memset(&c, 0, sizeof(c));
  // [CICLO] - 1 / 3 / 5 minuti, pot invertito come nel cablaggio storico.
  c.durataMs[0] = 60000UL; c.durataMs[1] = 180000UL; c.durataMs[2] = 300000UL;
  c.potMin = 0; c.potMax = 1023;  // Rev D: pot esterno alimentato a 5 V -> corsa 0..1023
  c.potInvertito = 1; c.partenzaInPausa = 0;
  // [FASI]
  c.pTramonto = 40.0f; c.pCrepuscolo = 50.0f; c.pNotte = 55.0f; c.pAlba = 85.0f;
  // [RELE] - logica alta, nessuna forzatura, schedulazione storica di esempio.
  c.releAttivoBasso = 0;
  c.eventi[0].fase = CFG_TRAMONTO; c.eventi[0].rele = 2; c.eventi[0].acceso = 1; c.eventi[0].pct = 30;
  c.eventi[1].fase = CFG_NOTTE;    c.eventi[1].rele = 2; c.eventi[1].acceso = 0; c.eventi[1].pct = 50;
  c.numEventi = 2;
  // [CIELO] [TRAMONTO] [ALBA] - tappe che riproducono le curve storiche del firmware.
  cfgTappeDefault(c);
  // [COLORI]
  c.lumCielo = 100; c.lumTramonto = 100; c.lumAlba = 100;
  c.gamma = 1; c.pwmInvertito = 0;
  // [STELLE_01] [STELLE_02] - stessi valori predefiniti per le due catene.
  for (uint8_t k = 0; k < CFG_NUM_CATENE; k++) {
    CfgStelle &s = c.stelle[k];
    s.numero = 50; s.attive = 20; s.lumMin = 22; s.lumMax = 75; s.livelloNotte = 235;
    s.scintillioMinMs = 6400; s.scintillioMaxMs = 12200; s.colore = rgb(100, 72, 38);
  }
  // [SISTEMA]
  c.buzzer = 1; c.melodiaAvvio = 1; c.autotestAvvio = 1; c.oled = 1;
  c.fastboot = 1;   // dalla release 038 l'avvio rapido e' il predefinito
  c.beepHz = 900; c.beepMs = 90; c.debugMs = 5000UL;
  // [WIFI] spento: la scheda si comporta come un Arduino Mega senza WiFi.
  // Resta spento anche senza microSD (nessun dato sui pin 14/15 di un Mega senza ESP8266):
  // il file di esempio invece lo accende (abilitato = 3).
  c.wifiAbilitato = 0;
  strcpy(c.wifiNome, "presepe");
  // [ACCESS_POINT] pronto all'uso: rete "Presepe", password presepe2026, http://192.168.4.1
  strcpy(c.apSsid, "Presepe");
  strcpy(c.apPassword, "presepe2026");
  c.apCanale = 6; c.apNascosta = 0; c.apMaxClient = 4; c.apPortale = 0;
  c.apIp[0] = 192; c.apIp[1] = 168; c.apIp[2] = 4; c.apIp[3] = 1;
  c.apAttesa = 60;
  // [AUTENTICAZIONE] della pagina web (da cambiare nel file).
  strcpy(c.webUtente, "admin");
  strcpy(c.webPassword, "presepe2026");
  c.sdStato = SD_NON_LETTA;
}

// ------------------------------------------------------------------ utilita'
static char *trim(char *s) {
  while (*s == ' ' || *s == '\t') s++;
  char *e = s + strlen(s);
  while (e > s && (e[-1] == ' ' || e[-1] == '\t' || e[-1] == '\r' || e[-1] == '\n')) *--e = 0;
  return s;
}
static bool ugualeCI(const char *a, const char *b) { return strcasecmp(a, b) == 0; }

static void errore(PresepeConfig &c, uint16_t riga) {
  c.errori++;
  if (!c.primaRigaErrata) c.primaRigaErrata = riga;
}

static bool leggiLong(const char *s, long &out, long minimo, long massimo) {
  char *fine;
  long v = strtol(s, &fine, 10);
  while (*fine == ' ' || *fine == '\t') fine++;
  if (fine == s || *fine) return false;
  if (v < minimo || v > massimo) return false;
  out = v; return true;
}
static bool leggiFloat(const char *s, float &out, float minimo, float massimo) {
  char *fine;
  double v = strtod(s, &fine);
  while (*fine == ' ' || *fine == '\t') fine++;
  if (fine == s || *fine) return false;
  if (v < minimo || v > massimo) return false;
  out = (float)v; return true;
}
static bool leggiBool(const char *s, uint8_t &out) {
  if (ugualeCI(s, "1") || ugualeCI(s, "si") || ugualeCI(s, "on") || ugualeCI(s, "true") || ugualeCI(s, "acceso")) { out = 1; return true; }
  if (ugualeCI(s, "0") || ugualeCI(s, "no") || ugualeCI(s, "off") || ugualeCI(s, "false") || ugualeCI(s, "spento")) { out = 0; return true; }
  return false;
}
// Divide "a, b, c" in campi (modifica la stringa). Ritorna il numero di campi.
static uint8_t campi(char *s, char **out, uint8_t max) {
  uint8_t n = 0;
  while (n < max) {
    char *virg = strchr(s, ',');
    if (virg) *virg = 0;
    out[n++] = trim(s);
    if (!virg) break;
    s = virg + 1;
  }
  return n;
}
static bool leggiRGB(char *s, CfgRGB &out) {
  char *f[4]; if (campi(s, f, 4) != 3) return false;
  long r, g, b;
  if (!leggiLong(f[0], r, 0, 255) || !leggiLong(f[1], g, 0, 255) || !leggiLong(f[2], b, 0, 255)) return false;
  out = rgb((uint8_t)r, (uint8_t)g, (uint8_t)b); return true;
}
static bool leggiFase(const char *s, uint8_t &out) {
  for (uint8_t i = 0; i < 5; i++) if (ugualeCI(s, NOMI_FASE[i])) { out = i; return true; }
  return false;
}
// Rele': numero 1..16, "Grp_GG_RR" (GG 01..04, RR 01..04) oppure un nome gia' definito.
static bool leggiRele(const PresepeConfig &c, const char *s, uint8_t &out) {
  long n;
  if (leggiLong(s, n, 1, 16)) { out = (uint8_t)(n - 1); return true; }
  if ((s[0] == 'G' || s[0] == 'g') && strlen(s) == 9 && (s[1] == 'r' || s[1] == 'R') && (s[2] == 'p' || s[2] == 'P')
      && s[3] == '_' && s[6] == '_' && isdigit(s[4]) && isdigit(s[5]) && isdigit(s[7]) && isdigit(s[8])) {
    int gg = (s[4] - '0') * 10 + (s[5] - '0'), rr = (s[7] - '0') * 10 + (s[8] - '0');
    if (gg >= 1 && gg <= 4 && rr >= 1 && rr <= 4) { out = (uint8_t)((gg - 1) * 4 + (rr - 1)); return true; }
    return false;
  }
  for (uint8_t i = 0; i < 16; i++) if (c.nome[i][0] && ugualeCI(s, c.nome[i])) { out = i; return true; }
  return false;
}
// "chiaveN" con N 1..16 -> indice 0..15, altrimenti -1
static int8_t suffissoRele(const char *chiave, const char *prefisso) {
  size_t lp = strlen(prefisso);
  if (strncasecmp(chiave, prefisso, lp) != 0) return -1;
  long n; if (!leggiLong(chiave + lp, n, 1, 16)) return -1;
  return (int8_t)(n - 1);
}

// ------------------------------------------------------------------ parser
static bool sezCiclo(PresepeConfig &c, const char *k, char *v) {
  long n;
  if (ugualeCI(k, "durata1") || ugualeCI(k, "durata2") || ugualeCI(k, "durata3")) {
    if (!leggiLong(v, n, 10, 86400)) return false;
    c.durataMs[k[6] - '1'] = (uint32_t)n * 1000UL; return true;
  }
  if (ugualeCI(k, "pot_min")) { if (!leggiLong(v, n, 0, 1023)) return false; c.potMin = (int16_t)n; return true; }
  if (ugualeCI(k, "pot_max")) { if (!leggiLong(v, n, 0, 1023)) return false; c.potMax = (int16_t)n; return true; }
  if (ugualeCI(k, "pot_invertito")) return leggiBool(v, c.potInvertito);
  if (ugualeCI(k, "partenza")) {
    if (ugualeCI(v, "marcia")) { c.partenzaInPausa = 0; return true; }
    if (ugualeCI(v, "pausa"))  { c.partenzaInPausa = 1; return true; }
    return false;
  }
  return false;
}
static bool sezFasi(PresepeConfig &c, const char *k, char *v) {
  float *dst = 0;
  if (ugualeCI(k, "tramonto")) dst = &c.pTramonto;
  else if (ugualeCI(k, "crepuscolo")) dst = &c.pCrepuscolo;
  else if (ugualeCI(k, "notte")) dst = &c.pNotte;
  else if (ugualeCI(k, "alba")) dst = &c.pAlba;
  if (!dst) return false;
  return leggiFloat(v, *dst, 1.0f, 99.0f);
}
static bool sezRele(PresepeConfig &c, const char *k, char *v) {
  int8_t i;
  if (ugualeCI(k, "logica")) {
    if (ugualeCI(v, "alta")) { c.releAttivoBasso = 0; return true; }
    if (ugualeCI(v, "bassa")) { c.releAttivoBasso = 1; return true; }
    return false;
  }
  if ((i = suffissoRele(k, "nome")) >= 0) {
    if (!*v || strlen(v) >= CFG_NOME_LEN || strchr(v, ',')) return false;
    strcpy(c.nome[i], v); return true;
  }
  if ((i = suffissoRele(k, "forza")) >= 0) {
    if (ugualeCI(v, "auto")) c.forza[i] = FORZA_AUTO;
    else if (ugualeCI(v, "on") || ugualeCI(v, "acceso")) c.forza[i] = FORZA_ON;
    else if (ugualeCI(v, "off") || ugualeCI(v, "spento")) c.forza[i] = FORZA_OFF;
    else return false;
    return true;
  }
  return false;
}
static bool sezColori(PresepeConfig &c, const char *k, char *v) {
  long n;
  if (ugualeCI(k, "lum_cielo")) { if (!leggiLong(v, n, 0, 100)) return false; c.lumCielo = (uint8_t)n; return true; }
  if (ugualeCI(k, "lum_tramonto")) { if (!leggiLong(v, n, 0, 100)) return false; c.lumTramonto = (uint8_t)n; return true; }
  if (ugualeCI(k, "lum_alba")) { if (!leggiLong(v, n, 0, 100)) return false; c.lumAlba = (uint8_t)n; return true; }
  if (ugualeCI(k, "gamma")) return leggiBool(v, c.gamma);
  if (ugualeCI(k, "pwm_invertito")) return leggiBool(v, c.pwmInvertito);
  return false;
}
// Sezioni di fase [GIORNO] [TRAMONTO] [CREPUSCOLO] [NOTTE] [ALBA]:
//   cielo | tramonto | alba = %, R, G, B [, morbida|lineare]     (tappa di colore)
//   rele = RELE', ON|OFF, %                                      (evento rele')
static bool tappaPrima(const CfgTappa &a, const CfgTappa &b) {   // a viene prima di b nel ciclo?
  return a.fase < b.fase || (a.fase == b.fase && a.pct < b.pct);
}
static bool sezFase(PresepeConfig &c, uint8_t fase, const char *k, char *v) {
  int8_t s = -1;
  if (ugualeCI(k, "cielo")) s = CFG_S_CIELO;
  else if (ugualeCI(k, "tramonto")) s = CFG_S_TRAMONTO;
  else if (ugualeCI(k, "alba")) s = CFG_S_ALBA;
  if (s >= 0) {
    char *f[6]; uint8_t nf = campi(v, f, 6);
    if (nf != 4 && nf != 5) return false;
    CfgTappa t; memset(&t, 0, sizeof(t)); float pct; long r, g, b;
    if (!leggiFloat(f[0], pct, 0.0f, 100.0f) ||
        !leggiLong(f[1], r, 0, 255) || !leggiLong(f[2], g, 0, 255) || !leggiLong(f[3], b, 0, 255)) return false;
    t.fase = fase; t.pct = pct; t.col = rgb((uint8_t)r, (uint8_t)g, (uint8_t)b); t.curva = CURVA_MORBIDA;
    if (nf == 5) {
      if (ugualeCI(f[4], "morbida")) t.curva = CURVA_MORBIDA;
      else if (ugualeCI(f[4], "lineare")) t.curva = CURVA_LINEARE;
      else return false;
    }
    CfgTappa *lista = c.tappe[s];
    uint8_t &n = c.numTappe[s];
    if (!(c.tappeDaFile[s] & (1 << fase))) {         // prima riga di questa striscia in questa fase:
      uint8_t j = 0;                                   // toglie le tappe predefinite di questa fase
      for (uint8_t i = 0; i < n; i++) if (lista[i].fase != fase) lista[j++] = lista[i];
      for (uint8_t i = j; i < n; i++) memset(&lista[i], 0, sizeof(CfgTappa));
      n = j;
      c.tappeDaFile[s] |= (uint8_t)(1 << fase);
    }
    if (n >= CFG_MAX_TAPPE) return false;
    uint8_t pos = n;                                   // inserimento in ordine di tempo; a pari punto
    while (pos > 0 && tappaPrima(t, lista[pos - 1])) { lista[pos] = lista[pos - 1]; pos--; }   // resta l'ordine del file
    lista[pos] = t; n++;
    return true;
  }
  if (ugualeCI(k, "rele")) {
    char *f[4]; if (campi(v, f, 4) != 3) return false;
    CfgEvento e; uint8_t st; long pct;
    if (!leggiRele(c, f[0], e.rele) || !leggiBool(f[1], st) || !leggiLong(f[2], pct, 0, 100)) return false;
    e.fase = fase; e.acceso = st; e.pct = (uint8_t)pct;
    if (!c.eventiDaFile) { c.numEventi = 0; c.eventiDaFile = 1; }   // il file sostituisce la tabella di default
    if (c.numEventi >= CFG_MAX_EVENTI) return false;
    c.eventi[c.numEventi++] = e; return true;
  }
  return false;
}
static bool sezStelle(CfgStelle &s, const char *k, char *v) {   // [STELLE_01] e [STELLE_02]
  long n;
  if (ugualeCI(k, "numero")) { if (!leggiLong(v, n, 0, CFG_MAX_STELLE)) return false; s.numero = (uint16_t)n; return true; }
  if (ugualeCI(k, "attive")) { if (!leggiLong(v, n, 0, CFG_MAX_STELLE)) return false; s.attive = (uint8_t)n; return true; }
  if (ugualeCI(k, "lum_min")) { if (!leggiLong(v, n, 0, 255)) return false; s.lumMin = (uint8_t)n; return true; }
  if (ugualeCI(k, "lum_max")) { if (!leggiLong(v, n, 0, 255)) return false; s.lumMax = (uint8_t)n; return true; }
  if (ugualeCI(k, "livello_notte")) { if (!leggiLong(v, n, 0, 255)) return false; s.livelloNotte = (uint8_t)n; return true; }
  if (ugualeCI(k, "scintillio_min")) { if (!leggiLong(v, n, 500, 60000)) return false; s.scintillioMinMs = (uint16_t)n; return true; }
  if (ugualeCI(k, "scintillio_max")) { if (!leggiLong(v, n, 500, 60000)) return false; s.scintillioMaxMs = (uint16_t)n; return true; }
  if (ugualeCI(k, "colore")) {
    CfgRGB x; if (!leggiRGB(v, x) || x.r > 100 || x.g > 100 || x.b > 100) return false;
    s.colore = x; return true;
  }
  return false;
}
uint8_t cfgCost(const PresepeConfig &c, uint8_t k, uint8_t i) {
  uint8_t b = c.costStella[k][i >> 1];
  return (i & 1) ? (b >> 4) : (b & 15);
}
static void cfgSetCost(PresepeConfig &c, uint8_t k, uint8_t i, uint8_t n) {
  uint8_t &b = c.costStella[k][i >> 1];
  b = (i & 1) ? (uint8_t)((b & 15) | (n << 4)) : (uint8_t)((b & 0xF0) | n);
}
// Valori di una costellazione nuova: luminosita' 80, tutte insieme, colore della catena,
// tempi come le stelle (appaiono in tutto il CREPUSCOLO, spariscono in tutta l'ALBA).
static void costDefault(CfgCostellazione &x) {
  memset(&x, 0, sizeof(x));
  x.lum = 80; x.modo = COST_INSIEME;
  x.acc[0] = { CFG_CREPUSCOLO, 0 }; x.acc[1] = { CFG_NOTTE, 0 };
  x.sp[0]  = { CFG_ALBA, 0 };       x.sp[1]  = { CFG_ALBA, 100 };
}
// "catena:numero" o "catena:da-a" (catena 01 o 02, numero da 1)
static bool stellaCost(char *t, uint8_t &k, uint8_t &da, uint8_t &a) {
  char *dp = strchr(t, ':');
  if (!dp) return false;
  *dp = 0;
  long kk, x, y;
  char *cat = trim(t), *num = trim(dp + 1), *tr = strchr(num, '-');
  if (!leggiLong(cat, kk, 1, CFG_NUM_CATENE)) return false;
  if (tr) { *tr = 0; if (!leggiLong(trim(num), x, 1, CFG_MAX_STELLE) || !leggiLong(trim(tr + 1), y, x, CFG_MAX_STELLE)) return false; }
  else { if (!leggiLong(num, x, 1, CFG_MAX_STELLE)) return false; y = x; }
  k = (uint8_t)(kk - 1); da = (uint8_t)(x - 1); a = (uint8_t)(y - 1);
  return true;
}
// "FASE %" (anche "FASE, %"), % intero 0..100
static bool puntoCost(char *t, CfgPunto &out) {
  t = trim(t);
  char *sp = t; while (*sp && *sp != ' ' && *sp != '\t' && *sp != ',') sp++;
  if (!*sp) return false;
  *sp = 0;
  char *num = trim(sp + 1); if (*num == ',') num = trim(num + 1);
  long n;
  if (!leggiFase(t, out.fase) || !leggiLong(num, n, 0, 100)) return false;
  out.pct = (uint8_t)n; return true;
}
// "FASE % - FASE %": da dove a dove sale (accendi) o scende (spegni)
static bool trattoCost(char *v, CfgPunto out[2]) {
  char *m = strchr(v, '-');
  if (!m) return false;
  *m = 0;
  CfgPunto a, b;
  if (!puntoCost(v, a) || !puntoCost(m + 1, b)) return false;
  out[0] = a; out[1] = b; return true;
}
// [COSTELLAZIONE] (la sezione e' gia' stata aggiunta da cfgParseRiga: questa e' l'ultima)
//   nome        = Orsa maggiore                  solo per l'editor
//   stelle      = 01:3, 01:7, 01:12-14, 02:5     catena:numero o catena:da-a
//   luminosita  = 80                             0..255
//   accendi     = CREPUSCOLO 30 - NOTTE 0        sale da .. a
//   spegni      = ALBA 10 - ALBA 60              scende da .. a
//   colore      = 100,90,60                      facoltativo, % per canale
//   modo        = insieme | una_alla_volta | scintilla
// La riga "stelle" si prende tutta o niente: una stella scritta male o gia' in un'altra
// costellazione la scarta intera. I numeri oltre il "numero" della catena li toglie cfgValida().
static bool sezCostellazione(PresepeConfig &c, const char *k, char *v) {
  if (!c.numCostellazioni) return false;
  uint8_t n = c.numCostellazioni;                 // 1..8
  CfgCostellazione &x = c.cost[n - 1];
  long l;
  if (ugualeCI(k, "nome")) return true;
  if (ugualeCI(k, "luminosita")) { if (!leggiLong(v, l, 0, 255)) return false; x.lum = (uint8_t)l; return true; }
  if (ugualeCI(k, "accendi")) return trattoCost(v, x.acc);
  if (ugualeCI(k, "spegni")) return trattoCost(v, x.sp);
  if (ugualeCI(k, "colore")) {
    CfgRGB y; if (!leggiRGB(v, y) || y.r > 100 || y.g > 100 || y.b > 100) return false;
    x.colore = y; x.haColore = true; return true;
  }
  if (ugualeCI(k, "modo")) {
    if (ugualeCI(v, "insieme")) x.modo = COST_INSIEME;
    else if (ugualeCI(v, "una_alla_volta")) x.modo = COST_UNA_ALLA_VOLTA;
    else if (ugualeCI(v, "scintilla")) x.modo = COST_SCINTILLA;
    else return false;
    return true;
  }
  if (!ugualeCI(k, "stelle")) return false;
  // due giri sulla stessa lista: il primo controlla, il secondo assegna
  char copia[128];
  for (uint8_t giro = 0; giro < 2; giro++) {
    strncpy(copia, v, sizeof(copia) - 1); copia[sizeof(copia) - 1] = 0;
    char *t = copia; uint8_t quante = 0;
    while (t) {
      char *virg = strchr(t, ',');
      if (virg) *virg = 0;
      uint8_t kk, da, a;
      if (!stellaCost(t, kk, da, a)) return false;
      for (uint8_t i = da; i <= a; i++) {
        uint8_t gia = cfgCost(c, kk, i);
        if (!giro && gia && gia != n) return false;              // gia' in un'altra costellazione
        if (giro) cfgSetCost(c, kk, i, n);
        quante++;
      }
      t = virg ? virg + 1 : 0;
    }
    if (!quante) return false;
  }
  return true;
}
static bool sezSistema(PresepeConfig &c, const char *k, char *v) {
  long n;
  if (ugualeCI(k, "buzzer")) return leggiBool(v, c.buzzer);
  if (ugualeCI(k, "melodia_avvio")) return leggiBool(v, c.melodiaAvvio);
  if (ugualeCI(k, "autotest_avvio")) return leggiBool(v, c.autotestAvvio);
  if (ugualeCI(k, "fastboot")) return leggiBool(v, c.fastboot);
  if (ugualeCI(k, "oled")) return leggiBool(v, c.oled);
  if (ugualeCI(k, "beep_hz")) { if (!leggiLong(v, n, 100, 8000)) return false; c.beepHz = (uint16_t)n; return true; }
  if (ugualeCI(k, "beep_ms")) { if (!leggiLong(v, n, 10, 2000)) return false; c.beepMs = (uint16_t)n; return true; }
  if (ugualeCI(k, "debug_ms")) { if (!leggiLong(v, n, 0, 3600000L)) return false; c.debugMs = (uint32_t)n; return true; }
  return false;
}
// Testo libero: "valore" tra virgolette (puo' contenere ; # = e spazi) oppure senza.
// Copia in dst (capienza cap, terminatore compreso) solo se lungo minimo..cap-1.
static bool leggiTesto(const char *v, char *dst, size_t cap, size_t minimo) {
  size_t l = strlen(v);
  if (l && v[0] == '"') {
    if (l < 2 || v[l - 1] != '"') return false;
    v++; l -= 2;
    for (size_t i = 0; i < l; i++) if (v[i] == '"') return false;   // nessuna virgoletta interna
  }
  if (l < minimo || l >= cap) return false;
  for (size_t i = 0; i < l; i++) if ((unsigned char)v[i] < 32) return false;
  memcpy(dst, v, l); dst[l] = 0;
  return true;
}
static bool leggiPasswordWpa(const char *v, char *dst) {   // vuota (rete aperta) oppure 8..63 caratteri
  char tmp[CFG_WPWD_LEN];
  if (!leggiTesto(v, tmp, CFG_WPWD_LEN, 0)) return false;
  if (tmp[0] && strlen(tmp) < 8) return false;
  strcpy(dst, tmp); return true;
}
static bool sezWifi(PresepeConfig &c, const char *k, char *v) {
  if (ugualeCI(k, "abilitato")) {             // 0/1 (anche si/no...), 2 o "ap" = access point, 3 o "auto"
    if (ugualeCI(v, "2") || ugualeCI(v, "ap")) { c.wifiAbilitato = 2; return true; }
    if (ugualeCI(v, "3") || ugualeCI(v, "auto")) { c.wifiAbilitato = 3; return true; }
    return leggiBool(v, c.wifiAbilitato);
  }
  if (ugualeCI(k, "ssid")) return leggiTesto(v, c.wifiSsid, CFG_SSID_LEN, 0);
  if (ugualeCI(k, "password")) return leggiPasswordWpa(v, c.wifiPassword);
  if (ugualeCI(k, "nome")) {
    char tmp[CFG_HOST_LEN];
    if (!leggiTesto(v, tmp, CFG_HOST_LEN, 1) || tmp[0] == '-') return false;
    for (char *p = tmp; *p; p++) {
      if (!(isalnum((unsigned char)*p) || *p == '-')) return false;
      *p = (char)tolower((unsigned char)*p);
    }
    strcpy(c.wifiNome, tmp); return true;
  }
  return false;
}
static bool sezAccessPoint(PresepeConfig &c, const char *k, char *v) {
  long n;
  if (ugualeCI(k, "ssid")) return leggiTesto(v, c.apSsid, CFG_SSID_LEN, 1);
  if (ugualeCI(k, "password")) return leggiPasswordWpa(v, c.apPassword);
  if (ugualeCI(k, "canale")) { if (!leggiLong(v, n, 1, 13)) return false; c.apCanale = (uint8_t)n; return true; }
  if (ugualeCI(k, "nascosta")) return leggiBool(v, c.apNascosta);
  if (ugualeCI(k, "max_client")) { if (!leggiLong(v, n, 1, 8)) return false; c.apMaxClient = (uint8_t)n; return true; }
  if (ugualeCI(k, "portale")) return leggiBool(v, c.apPortale);
  if (ugualeCI(k, "attesa")) { if (!leggiLong(v, n, 10, 600)) return false; c.apAttesa = (uint16_t)n; return true; }
  if (ugualeCI(k, "ip")) {                    // a.b.c.d, rete /24: l'ultimo numero da 1 a 55
    // (il DHCP dell'ESP8266 da' ai telefoni da ultimo+99 a ultimo+199: oltre 55 sforerebbe il 255)
    uint8_t x[4]; const char *s = v;
    for (uint8_t i = 0; i < 4; i++) {
      if (!isdigit((unsigned char)*s)) return false;
      char *fine; long q = strtol(s, &fine, 10);
      if (fine - s > 3 || q < 0 || q > 255 || (i < 3 ? *fine != '.' : *fine != 0)) return false;
      x[i] = (uint8_t)q; s = fine + 1;
    }
    if (x[3] == 0 || x[3] > 55 || x[0] == 0 || x[0] >= 224 || x[0] == 127) return false;
    memcpy(c.apIp, x, 4); return true;
  }
  return false;
}
static bool sezAutenticazione(PresepeConfig &c, const char *k, char *v) {
  if (ugualeCI(k, "utente")) return leggiTesto(v, c.webUtente, CFG_UTENTE_LEN, 1);
  if (ugualeCI(k, "password")) return leggiTesto(v, c.webPassword, CFG_UTENTE_LEN, 1);
  return false;
}

void cfgParseLine(PresepeConfig &c, char *riga, char *sezione, uint16_t numeroRiga) {
  c.righeLette = numeroRiga;
  // Commenti: da ; o # in poi. Se il valore comincia con " il commento si cerca solo
  // dopo la virgoletta di chiusura (la password puo' contenere ; e #). Una " in mezzo
  // a un valore normale (es. nome1 = TV 12") non cambia nulla.
  char *inizio = riga;
  char *ug = strchr(riga, '=');
  if (ug && !memchr(riga, ';', ug - riga) && !memchr(riga, '#', ug - riga)) {
    char *q = ug + 1;
    while (*q == ' ' || *q == '\t') q++;
    if (*q == '"') { char *chiusa = strchr(q + 1, '"'); inizio = chiusa ? chiusa + 1 : q + strlen(q); }
  }
  for (char *p = inizio; *p; p++)
    if (*p == ';' || *p == '#') { *p = 0; break; }
  char *s = trim(riga);
  if (!*s) return;
  if (*s == '[') {
    char *e = strchr(s, ']');
    if (!e || e[1]) { errore(c, numeroRiga); sezione[0] = 0; return; }
    *e = 0; char *n = trim(s + 1);
    if (strlen(n) > 15) { errore(c, numeroRiga); sezione[0] = 0; return; }
    strcpy(sezione, n);
    if (!(ugualeCI(n, "CICLO") || ugualeCI(n, "FASI") || ugualeCI(n, "RELE") || ugualeCI(n, "COLORI") ||
          ugualeCI(n, "GIORNO") || ugualeCI(n, "TRAMONTO") || ugualeCI(n, "CREPUSCOLO") ||
          ugualeCI(n, "NOTTE") || ugualeCI(n, "ALBA") ||
          ugualeCI(n, "STELLE_01") || ugualeCI(n, "STELLE_02") || ugualeCI(n, "COSTELLAZIONE") || ugualeCI(n, "SISTEMA") ||
          ugualeCI(n, "WIFI") || ugualeCI(n, "ACCESS_POINT") || ugualeCI(n, "AUTENTICAZIONE"))) { errore(c, numeroRiga); sezione[0] = 0; }
    else if (ugualeCI(n, "COSTELLAZIONE")) {        // ogni [COSTELLAZIONE] e' una costellazione nuova
      if (c.numCostellazioni < CFG_MAX_COSTELLAZIONI) costDefault(c.cost[c.numCostellazioni++]);
      else { errore(c, numeroRiga); sezione[0] = 0; }
    }
    return;
  }
  char *uguale = strchr(s, '=');
  if (!uguale || !sezione[0]) { errore(c, numeroRiga); return; }
  *uguale = 0;
  char *k = trim(s), *v = trim(uguale + 1);
  bool ok = false;
  if (ugualeCI(sezione, "CICLO")) ok = sezCiclo(c, k, v);
  else if (ugualeCI(sezione, "FASI")) ok = sezFasi(c, k, v);
  else if (ugualeCI(sezione, "RELE")) ok = sezRele(c, k, v);
  else if (ugualeCI(sezione, "COLORI")) ok = sezColori(c, k, v);
  else if (ugualeCI(sezione, "STELLE_01")) ok = sezStelle(c.stelle[0], k, v);
  else if (ugualeCI(sezione, "STELLE_02")) ok = sezStelle(c.stelle[1], k, v);
  else if (ugualeCI(sezione, "COSTELLAZIONE")) ok = sezCostellazione(c, k, v);
  else if (ugualeCI(sezione, "SISTEMA")) ok = sezSistema(c, k, v);
  else if (ugualeCI(sezione, "WIFI")) ok = sezWifi(c, k, v);
  else if (ugualeCI(sezione, "ACCESS_POINT")) ok = sezAccessPoint(c, k, v);
  else if (ugualeCI(sezione, "AUTENTICAZIONE")) ok = sezAutenticazione(c, k, v);
  else {
    uint8_t fase;
    if (leggiFase(sezione, fase)) ok = sezFase(c, fase, k, v);   // [GIORNO] .. [ALBA]
  }
  if (!ok) errore(c, numeroRiga);
}

void cfgValida(PresepeConfig &c) {
  // Nessuna copia completa dei default (sarebbe ~1,6 kB sullo stack): i valori
  // di ripiego qui sotto sono gli stessi di cfgDefault().
  // fasi strettamente crescenti, altrimenti tutte di default
  if (!(c.pTramonto < c.pCrepuscolo && c.pCrepuscolo < c.pNotte && c.pNotte < c.pAlba)) {
    c.pTramonto = 40.0f; c.pCrepuscolo = 50.0f; c.pNotte = 55.0f; c.pAlba = 85.0f;
    errore(c, 0xFFFF);
  }
  if (c.potMax - c.potMin < 30) { c.potMin = 0; c.potMax = 1023; errore(c, 0xFFFF); }
  for (uint8_t k = 0; k < CFG_NUM_CATENE; k++) {
    CfgStelle &s = c.stelle[k];
    if (s.lumMin > s.lumMax) { s.lumMin = 22; s.lumMax = 75; errore(c, 0xFFFF); }
    if (s.scintillioMinMs > s.scintillioMaxMs) { s.scintillioMinMs = 6400; s.scintillioMaxMs = 12200; errore(c, 0xFFFF); }
    if (s.attive > s.numero) s.attive = (uint8_t)s.numero;
    // stelle di costellazione oltre la fine della catena: tolte (un errore solo)
    bool fuori = false;
    for (uint8_t i = (uint8_t)s.numero; i < CFG_MAX_STELLE; i++) if (cfgCost(c, k, i)) { cfgSetCost(c, k, i, 0); fuori = true; }
    if (fuori) errore(c, 0xFFFF);
  }
  // costellazioni: quante stelle (per "una_alla_volta") e tempi in ordine nel giro del ciclo
  // (sale, resta, scende); se no tornano i tempi delle stelle
  for (uint8_t q = 0; q < c.numCostellazioni; q++) {
    CfgCostellazione &x = c.cost[q];
    x.n0 = x.n = 0;
    for (uint8_t k = 0; k < CFG_NUM_CATENE; k++)
      for (uint8_t i = 0; i < CFG_MAX_STELLE; i++)
        if (cfgCost(c, k, i) == q + 1) { x.n++; if (!k) x.n0++; }
    float a1 = cfgPosizione(c, x.acc[0].fase, x.acc[0].pct);
    float d[3] = { cfgPosizione(c, x.acc[1].fase, x.acc[1].pct), cfgPosizione(c, x.sp[0].fase, x.sp[0].pct),
                   cfgPosizione(c, x.sp[1].fase, x.sp[1].pct) };
    for (uint8_t j = 0; j < 3; j++) { d[j] -= a1; if (d[j] < 0.0f) d[j] += 100.0f; }
    if (d[0] > d[1] || d[1] > d[2]) {
      CfgCostellazione y; costDefault(y);
      memcpy(x.acc, y.acc, sizeof(x.acc)); memcpy(x.sp, y.sp, sizeof(x.sp));
      errore(c, 0xFFFF);
    }
  }
}

void cfgParseBuffer(PresepeConfig &c, const char *testo) {
  char riga[128], sezione[16] = "";
  uint16_t n = 0;
  while (*testo) {
    size_t l = 0;
    while (testo[l] && testo[l] != '\n') l++;
    n++;
    if (l >= sizeof(riga)) errore(c, n);
    else { memcpy(riga, testo, l); riga[l] = 0; cfgParseLine(c, riga, sezione, n); }
    testo += l; if (*testo == '\n') testo++;
  }
  cfgValida(c);
}

#ifdef ARDUINO
const char *cfgFileLetto = CFG_FILE_NAME;

uint8_t cfgCaricaDaSD(uint8_t pinCS, uint8_t pinCD) {
  (void)pinCD;   // il contatto di rilevamento e' solo informativo (vedi .ino)
  if (!SD.begin(pinCS)) { cfg.sdStato = SD_ASSENTE; return cfg.sdStato; }
  File f = SD.open(CFG_FILE_NAME, FILE_READ);
  if (!f) { f = SD.open(CFG_FILE_NAME_ALT, FILE_READ); if (f) cfgFileLetto = CFG_FILE_NAME_ALT; }
  if (!f) { cfg.sdStato = SD_NO_FILE; SD.end(); return cfg.sdStato; }
  char riga[128], sezione[16] = "";
  uint16_t n = 0; uint8_t l = 0; bool troppoLunga = false;
  while (true) {
    int ch = f.read();
    if (ch < 0 || ch == '\n') {
      if (ch < 0 && l == 0 && !troppoLunga) break;
      n++;
      riga[l] = 0;
      if (troppoLunga) errore(cfg, n); else cfgParseLine(cfg, riga, sezione, n);
      l = 0; troppoLunga = false;
      if (ch < 0) break;
    } else if (l < sizeof(riga) - 1) riga[l++] = (char)ch;
    else troppoLunga = true;
  }
  f.close();
  SD.end();
  cfgValida(cfg);
  cfg.sdStato = cfg.errori ? SD_OK_ERRORI : SD_OK;
  return cfg.sdStato;
}
#endif

// ---------------------------------------------------------------- modalita' colore
// Logica pura (verificata su PC) della "modalita' colore": potenziometro -> valore
// 0..255 con regolazione fine e "aggancio" (pickup) del valore gia' presente.

// Valore 0..255 dal potenziometro. Normale: tutta la corsa = 0..255.
// Fine: tutta la corsa = base-16 .. base+16 (centro manopola = base).
uint8_t cfgValoreDaPot(const PresepeConfig &c, int raw, uint8_t fine, uint8_t base) {
  float pos = (float)(raw - c.potMin) / (float)(c.potMax - c.potMin);
  if (pos < 0.0f) pos = 0.0f;
  if (pos > 1.0f) pos = 1.0f;
  if (c.potInvertito) pos = 1.0f - pos;     // stesso verso del potenziometro della durata
  long v = fine ? (long)base + (long)((pos - 0.5f) * 32.0f + (pos >= 0.5f ? 0.5f : -0.5f))
                : (long)(pos * 255.0f + 0.5f);
  if (v < 0) v = 0;
  if (v > 255) v = 255;
  return (uint8_t)v;
}

// Aggancio: dopo un cambio di canale la manopola non modifica nulla finche' il suo
// valore non arriva (o passa oltre) il valore attuale del canale.
void cfgAggancioReset(CfgAggancio &a) { a.agganciato = 0; a.lato = 0; }
// Ritorna 1 quando la manopola e' agganciata: da quel momento il canale segue 'daPot'.
uint8_t cfgAggancioAggiorna(CfgAggancio &a, uint8_t attuale, uint8_t daPot) {
  if (a.agganciato) return 1;
  int d = (int)daPot - (int)attuale;
  if (d >= -1 && d <= 1) { a.agganciato = 1; return 1; }            // sul valore (+/-1 per il rumore)
  int8_t lato = d < 0 ? -1 : 1;
  if (a.lato != 0 && lato != a.lato) { a.agganciato = 1; return 1; } // e' passata oltre: agganciata
  a.lato = lato;
  return 0;
}
// ---------------------------------------------------------------- collegamento WiFi
// Righe dall'ESP8266: "@COMANDO argomenti*HH". HH = somma dei byte prima di '*'
// (modulo 256) in esadecimale maiuscolo. Una riga senza somma corretta viene ignorata:
// l'ESP non riceve risposta e la ritrasmette.
uint8_t lnkSomma(const char *s, size_t n) {
  uint8_t x = 0;
  for (size_t i = 0; i < n; i++) x = (uint8_t)(x + (uint8_t)s[i]);
  return x;
}
static int8_t esa(char ch) {
  if (ch >= '0' && ch <= '9') return (int8_t)(ch - '0');
  if (ch >= 'A' && ch <= 'F') return (int8_t)(ch - 'A' + 10);
  return -1;
}
// Controlla e toglie "*HH" in coda. Ritorna false se manca o non corrisponde.
bool lnkVerifica(char *riga) {
  size_t l = strlen(riga);
  if (l < 4 || riga[0] != '@' || riga[l - 3] != '*') return false;
  int8_t h = esa(riga[l - 2]), b = esa(riga[l - 1]);
  if (h < 0 || b < 0) return false;
  if (lnkSomma(riga, l - 3) != (uint8_t)(h * 16 + b)) return false;
  riga[l - 3] = 0;
  return true;
}
// ==== CONFIG END ====

int potLimita(int raw) { return constrain(raw, (int)cfg.potMin, (int)cfg.potMax); }
unsigned long durataCicloStabile = 60000UL;
int potRawStabile = 0;

// Fasi in percentuale
#define P_TRAMONTO (cfg.pTramonto)   // [FASI] tramonto   (default 40)
#define P_CREPU    (cfg.pCrepuscolo) // [FASI] crepuscolo (default 50)
#define P_NOTTE    (cfg.pNotte)      // [FASI] notte      (default 55)
#define P_ALBA     (cfg.pAlba)       // [FASI] alba       (default 85)
// ALBA occupa l'ultimo 15% del ciclo e termina direttamente nel nuovo GIORNO.

const unsigned long DEBOUNCE_MS = 20;
#define DEBUG_INTERVAL_MS (cfg.debugMs)   // [SISTEMA] debug_ms (0 = nessun log periodico)
#define START_STOP_MS 2000UL              // START tenuto cosi' a lungo = STOP

// ============================================================
// STATO
// ============================================================

enum Fase {
  GIORNO,
  TRAMONTO,
  CREPUSCOLO,
  NOTTE,
  ALBA
};

// Prototipi espliciti: il file compila anche senza la generazione automatica
// dei prototipi dell'IDE Arduino (arduino-cli / ctags non necessari).
enum OledPopup : uint8_t;
void buzzerBeep(bool comando = true);
void buzzerTick();
void buzzerPotTick(int raw);
int8_t pwmChannelIndex(uint8_t pin);
void pwmWrite(uint8_t pin, uint8_t value);
uint8_t scalaLum(uint8_t v, uint8_t pct);
void setCielo(uint8_t r, uint8_t g, uint8_t b);
void setTramonto(uint8_t r, uint8_t g, uint8_t b);
void setAlba(uint8_t r, uint8_t g, uint8_t b);
void generaCieloStellato(uint8_t k);
void mostraStelle(uint8_t k, float livello);
void stelleFlush();
void aggiornaLedStato();
void setStelle(uint8_t k, uint8_t value);
void riempiCatena(uint8_t k, uint8_t r, uint8_t g, uint8_t b);
void tuttoSpento();
unsigned long durataDaRaw(int raw);
unsigned long durataCiclo();
void stampaDurataOled(unsigned long durata);
float percentualeCiclo(unsigned long durata);
float progresso(float p, float inizio, float fine);
uint8_t interpola8(uint8_t da, uint8_t a, float t);
Fase faseDaPercentuale(float p);
const char* nomeFase(Fase f);
float inizioFase(Fase f);
Fase faseSuccessiva(Fase f);
float fineFase(Fase f);
uint8_t indiceFase(Fase f);
void scriviRele(uint8_t indice, bool acceso);
void aggiornaReleSchedulati(float p);
float percentualeFase(float p, Fase f);
void oledCentro(const __FlashStringHelper *s, int y, uint8_t size = 1);
void mostraOledTest();
void mostraOledRgbPausa(float p);
void aggiornaOled(unsigned long durata, float p);
bool inizializzaOled();
void mostraStatoSD();
void saltaAPercentuale(float p);
void faseAvanti();
void aggiornaScena(float p);
bool pulsantePremuto(uint8_t pin, bool &lastRead, bool &stable, unsigned long &lastChange);
void toggleStartStop();
void spegniRele();
void accendiRele(uint8_t indice);
void applicaTestCorrente();
void testUscite();
void stampaStato(unsigned long durata, float p);
void stampaConfig();
void aggiornaMelodiaBoot(unsigned long elapsedTotale);
void mostraOledBoot(const __FlashStringHelper *fase, uint8_t step, unsigned long elapsedStep);
void attesaBoot(const __FlashStringHelper *fase, uint8_t step);
void eseguiSequenzaBoot();
bool lnkQuiet();
void lnkInizio();
void lnkTick();
bool lnkRecupera();
bool iniCreaPredefinito();
extern bool iniCreato;
void entraTest();
void entraTestWeb();
void fermaPresepe();
void avviaPresepe();
void mostraOledStop();
void riavviaSoftware();
void setup();


// ============================================================
// SCHEDULAZIONE RELÈ
// ============================================================
// La tabella eventi e' in cfg.eventi (da [RELE] evento = FASE, RELE', ON|OFF, %).
// Ogni evento e' persistente: il rele' mantiene lo stato fino al successivo
// evento che lo riguarda. Default (senza SD): Grp_01_03 ON al 30% del TRAMONTO,
// OFF al 50% della NOTTE. [RELE] forzaN = on|off|auto scavalca la tabella.
#define NUM_EVENTI_RELE (cfg.numEventi)

bool running = true;
bool fermo = false;          // STOP: tutto spento (rele', strisce, stelle) fino a PLAY
bool testInCorso = false;
bool testMostraIP = false;   // [WIFI] abilitato: passo del test con l'indirizzo IP (dopo il potenziometro)
bool testMostraPot = false;  // ultimo passo del test: lettura dal vivo del potenziometro
unsigned long testPotMs = 0; // ultimo aggiornamento del passo potenziometro
bool testWeb = false;        // test comandato dalla pagina web (strisce, pixel, rele' uno a uno)
uint16_t releStato = 0;      // bit i = rele' i+1 acceso (per la pagina web)
char wifiIp[16] = "none";    // indirizzo comunicato dall'ESP8266 ("none" = non collegato)
bool wifiAp = false;         // l'ESP8266 ha creato l'access point (abilitato = 2, o 3 senza rete di casa)
uint8_t testIndice = 0;
bool testEraInMarcia = false;
unsigned long testPausaMs = 0;

unsigned long cycleStartMs = 0;
unsigned long pauseStartedMs = 0;
unsigned long lastDebugMs = 0;

// Ultimi valori RGB realmente richiesti alle tre strisce.
// Servono anche per mostrarli sul display quando il ciclo viene messo in pausa.
uint8_t rgbCieloR = 0, rgbCieloG = 0, rgbCieloB = 0;
uint8_t rgbTramontoR = 0, rgbTramontoG = 0, rgbTramontoB = 0;
uint8_t rgbAlbaR = 0, rgbAlbaG = 0, rgbAlbaB = 0;

// debounce pulsanti
bool lastStartRead = HIGH, stableStart = HIGH;
bool lastNextRead  = HIGH, stableNext  = HIGH;
bool lastTestRead  = HIGH, stableTest  = HIGH;
unsigned long dbStartMs = 0, dbNextMs = 0, dbTestMs = 0;

// Feedback acustico semplice e non bloccante.
// Tutti i comandi (START/STOP, AVANTI, TEST e potenziometro) usano lo stesso bip.
#define BEEP_HZ (cfg.beepHz)   // [SISTEMA] beep_hz
#define BEEP_MS (cfg.beepMs)   // [SISTEMA] beep_ms
unsigned long buzzerFino = 0;
bool buzzerAttivo = false;
bool buzzerPrioritaComando = false;
int potBeepRiferimento = -1;
int potBeepUltimaLettura = -1;
unsigned long potUltimaVariazioneMs = 0;
bool potBeepInAttesa = false;
const int POT_BEEP_DELTA = 60;                 // circa 8% della corsa: ignora piccoli spostamenti/rumore
const int POT_BEEP_STABILITA_DELTA = 4;        // entro 4 punti ADC consideriamo il pot fermo
const unsigned long POT_BEEP_SETTLE_MS = 350UL; // bip solo 350 ms dopo l'ultima variazione

void buzzerBeep(bool comando) {
  if (!BUZZER_ENABLED) return;

  // I comandi fisici hanno priorita': il feedback del potenziometro
  // non puo' troncare o sostituire un bip START/STOP, AVANTI o TEST.
  if (!comando && buzzerAttivo && buzzerPrioritaComando) return;

  // Ripartenza esplicita: ogni comando riconosciuto ottiene un bip completo.
  noTone(PIN_BUZZER);
  tone(PIN_BUZZER, BEEP_HZ);
  buzzerFino = millis() + BEEP_MS;
  buzzerAttivo = true;
  buzzerPrioritaComando = comando;
}

void buzzerTick() {
  if (buzzerAttivo && (long)(millis() - buzzerFino) >= 0) {
    noTone(PIN_BUZZER);
    buzzerAttivo = false;
    buzzerPrioritaComando = false;
  }
}

void buzzerPotTick(int raw) {
  unsigned long now = millis();

  if (potBeepRiferimento < 0) {
    potBeepRiferimento = raw;
    potBeepUltimaLettura = raw;
    return;
  }

  // Segui il movimento reale del potenziometro, ignorando il normale rumore ADC.
  if (abs(raw - potBeepUltimaLettura) >= POT_BEEP_STABILITA_DELTA) {
    potBeepUltimaLettura = raw;
    potUltimaVariazioneMs = now;

    // Il bip viene armato solo dopo uno spostamento consistente.
    if (abs(raw - potBeepRiferimento) >= POT_BEEP_DELTA)
      potBeepInAttesa = true;
  }

  // Un solo bip quando la manopola e' rimasta ferma per qualche centinaio di ms.
  if (potBeepInAttesa && now - potUltimaVariazioneMs >= POT_BEEP_SETTLE_MS) {
    potBeepInAttesa = false;
    potBeepRiferimento = raw;
    potBeepUltimaLettura = raw;
    buzzerBeep(false);
  }
}

// ============================================================
// PWM
// ============================================================

// Correzione percettiva per le strisce RGB analogiche.
// La scenografia lavora 0..255 e analogWrite() resta PWM hardware a 8 bit.
// Applichiamo una curva gamma ~2.0 e arrotondiamo al gradino PWM piu' vicino.
// Nessun dithering temporale: evitiamo l'alternanza tra gradini alle basse luci.
#define PWM_GAMMA (cfg.gamma)   // [COLORI] gamma

int8_t pwmChannelIndex(uint8_t pin) {
  const uint8_t pins[9] = {
    PIN_CIELO_R, PIN_CIELO_G, PIN_CIELO_B,
    PIN_TRAMONTO_R, PIN_TRAMONTO_G, PIN_TRAMONTO_B,
    PIN_ALBA_R, PIN_ALBA_G, PIN_ALBA_B
  };
  for (uint8_t i = 0; i < 9; i++)
    if (pins[i] == pin) return i;
  return -1;
}

void pwmWrite(uint8_t pin, uint8_t value) {
  uint8_t out = value;

  if (PWM_GAMMA) {
    // Gamma 2.0 calcolata in fixed point; il risultato viene poi
    // arrotondato al gradino PWM hardware 8-bit piu' vicino.
    uint32_t squared = (uint32_t)value * (uint32_t)value;
    uint16_t pwm16 = (uint16_t)((squared * 4080UL + 32512UL) / 65025UL);
    uint8_t base = pwm16 >> 4;
    uint8_t frac = pwm16 & 0x0F;

    // Nessun dithering temporale: manteniamo la gamma e arrotondiamo
    // semplicemente al gradino PWM 8-bit piu' vicino.
    // Questo elimina l'alternanza tra gradini che sull'hardware reale
    // viene percepita come lampeggio alle bassissime luminosita'.
    if (frac >= 8 && base < 255) base++;
    out = base;
  }

  analogWrite(pin, PWM_INVERTED ? (255 - out) : out);
}

// Limite di luminosita' per striscia ([COLORI] lum_cielo/lum_tramonto/lum_alba, 0..100 %).
// Il valore richiesto dalla scena viene memorizzato (OLED in pausa) e scalato solo in uscita.
uint8_t scalaLum(uint8_t v, uint8_t pct) { return pct >= 100 ? v : (uint8_t)(((uint16_t)v * pct + 50) / 100); }

void setCielo(uint8_t r, uint8_t g, uint8_t b) {
  rgbCieloR = r; rgbCieloG = g; rgbCieloB = b;
  pwmWrite(PIN_CIELO_R, scalaLum(r, cfg.lumCielo));
  pwmWrite(PIN_CIELO_G, scalaLum(g, cfg.lumCielo));
  pwmWrite(PIN_CIELO_B, scalaLum(b, cfg.lumCielo));
}

void setTramonto(uint8_t r, uint8_t g, uint8_t b) {
  rgbTramontoR = r; rgbTramontoG = g; rgbTramontoB = b;
  pwmWrite(PIN_TRAMONTO_R, scalaLum(r, cfg.lumTramonto));
  pwmWrite(PIN_TRAMONTO_G, scalaLum(g, cfg.lumTramonto));
  pwmWrite(PIN_TRAMONTO_B, scalaLum(b, cfg.lumTramonto));
}

void setAlba(uint8_t r, uint8_t g, uint8_t b) {
  rgbAlbaR = r; rgbAlbaG = g; rgbAlbaB = b;
  pwmWrite(PIN_ALBA_R, scalaLum(r, cfg.lumAlba));
  pwmWrite(PIN_ALBA_G, scalaLum(g, cfg.lumAlba));
  pwmWrite(PIN_ALBA_B, scalaLum(b, cfg.lumAlba));
}

// ============================================================
// STELLE WS2811 - due catene identiche, STELLE_01 (D5) e STELLE_02 (D8)
// ============================================================
// Effetto naturale: ogni notte viene generato un cielo diverso, per ogni catena.
// Ogni notte vengono scelte casualmente "attive" stelle su "numero", con
// luminosita' massime differenti. Compaiono nel crepuscolo, restano accese di
// notte e scompaiono durante l'alba. Tutte le attive hanno variazioni asincrone.
// Parametri in [STELLE_01] e [STELLE_02] (cfg.stelle[0] e cfg.stelle[1]).

struct StatoStelle {
  uint8_t lum[CFG_MAX_STELLE];
  uint8_t ordine[CFG_MAX_STELLE];
  bool twinkle[CFG_MAX_STELLE];
  uint8_t liberi;                 // stelle fuori dalle costellazioni: le prime "liberi" di ordine
  bool inSospeso;                 // pixel cambiati ma non ancora inviati (vedi stelleFlush)
  unsigned long ultimoShowUs;
};
StatoStelle statoStelle[CFG_NUM_CATENE];
bool cieloGenerato = false;
Fase ultimaFaseStelle = GIORNO;

void generaCieloStellato(uint8_t k) {
  const CfgStelle &cs = cfg.stelle[k];
  StatoStelle &st = statoStelle[k];
  // Ogni notte scegliamo casualmente solo "attive" delle "numero" stelle fisiche.
  // Le altre restano completamente spente. Le stelle delle costellazioni non entrano
  // nella scelta: in ordine ci sono solo le stelle libere.
  st.liberi = 0;
  for (uint16_t i = 0; i < cs.numero; i++) {
    st.lum[i] = random(cs.lumMin, cs.lumMax + 1); // lum_min..lum_max (tenue)
    st.twinkle[i] = false;
    if (!cfgCost(cfg, k, i)) st.ordine[st.liberi++] = (uint8_t)i;
  }

  // Fisher-Yates sulle stelle libere: le prime "attive" saranno quelle accese.
  for (int i = st.liberi - 1; i > 0; i--) {
    int j = random(i + 1);
    uint8_t tmp = st.ordine[i];
    st.ordine[i] = st.ordine[j];
    st.ordine[j] = tmp;
  }

  // Tutte le stelle attive scintillano.
  for (uint8_t n = 0; n < cs.attive && n < st.liberi; n++) st.twinkle[st.ordine[n]] = true;
}

void generaTuttiICieli() {
  for (uint8_t k = 0; k < CFG_NUM_CATENE; k++) generaCieloStellato(k);
  cieloGenerato = true;
}

// Scintillio di una stella (0..100 %): livello pieno -> dissolvenza a zero -> pausa spenta ->
// riaccensione. Durata pseudo-casuale e stabile per ogni pixel, fra scintillio_min e
// scintillio_max (default 6400..12200 ms, 30 gradini); la seconda catena usa altri numeri
// (j = i + 100), cosi' non ripete la prima.
uint8_t fattoreScintillio(const CfgStelle &cs, uint8_t k, uint8_t i) {
  const unsigned long j = i + 100UL * k;
  const unsigned long passo = ((unsigned long)cs.scintillioMaxMs - cs.scintillioMinMs) / 29UL;
  const unsigned long periodo = cs.scintillioMinMs + ((j * 37UL) % 30UL) * passo;
  const unsigned long offset = ((j * 173UL) % 900UL);
  const unsigned long faseMs = (millis() + offset) % periodo;
  const unsigned long pTw = (faseMs * 100UL) / periodo;
  if (pTw < 45) return 100;                              // piena luminosita'
  if (pTw < 55) return (uint8_t)((55UL - pTw) * 10UL);   // 100 -> 0
  if (pTw < 80) return 0;                                // SPENTA per il 25% del ciclo
  if (pTw < 90) return (uint8_t)((pTw - 80UL) * 10UL);   // 0 -> 100
  return 100;
}

// Posizione del ciclo (0..100) mentre aggiornaScena() disegna le stelle; -1 fuori dal ciclo
// (test, avvio): allora le costellazioni seguono il livello delle stelle.
float posStelle = -1.0f;

static float morbida(float t) { return t * t * (3.0f - 2.0f * t); }
// Livello (0..1) di una costellazione nella posizione p del ciclo: sale da acc[0] ad acc[1],
// resta piena fino a sp[0], scende fino a sp[1] (curve morbide). Le distanze si contano da
// acc[0] nel giro del ciclo, cosi' un tratto puo' anche scavalcare la fine del ciclo.
float livelloCostellazione(const CfgCostellazione &x, float p) {
  float a1 = cfgPosizione(cfg, x.acc[0].fase, x.acc[0].pct);
  float d[4] = { p, cfgPosizione(cfg, x.acc[1].fase, x.acc[1].pct), cfgPosizione(cfg, x.sp[0].fase, x.sp[0].pct),
                 cfgPosizione(cfg, x.sp[1].fase, x.sp[1].pct) };
  for (uint8_t j = 0; j < 4; j++) { d[j] -= a1; while (d[j] < 0.0f) d[j] += 100.0f; while (d[j] >= 100.0f) d[j] -= 100.0f; }
  if (d[3] == 0.0f && d[2] == 0.0f && d[1] == 0.0f) return 0.0f;
  if (d[3] == 0.0f) d[3] = 100.0f;                      // finisce proprio dove comincia
  if (d[0] < d[1]) return morbida(d[0] / d[1]);
  if (d[0] < d[2]) return 1.0f;
  if (d[0] < d[3]) return 1.0f - morbida((d[0] - d[2]) / (d[3] - d[2]));
  return 0.0f;
}

void mostraStelle(uint8_t k, float livello) {
  const CfgStelle &cs = cfg.stelle[k];
  StatoStelle &st = statoStelle[k];
  Adafruit_NeoPixel &np = *catena[k];
  livello = constrain(livello, 0.0f, 1.0f);
  np.clear();

  // Durante il crepuscolo entrano progressivamente le stelle scelte;
  // durante l'alba scompaiono progressivamente. Mai piu' di "attive" accese
  // (meno se le costellazioni lasciano meno stelle libere).
  uint8_t attive = cs.attive < st.liberi ? cs.attive : st.liberi;
  uint8_t visibili = (uint8_t)(livello * attive + 0.5f);
  if (visibili > attive) visibili = attive;

  for (uint8_t pos = 0; pos < visibili; pos++) {
    uint8_t i = st.ordine[pos];
    float locale = livello * attive - pos;
    locale = constrain(locale, 0.0f, 1.0f);

    uint16_t v = (uint16_t)(st.lum[i] * locale);

    // Ogni stella attiva segue autonomamente un ciclo di luminosita':
    // livello pieno -> dissolvenza a zero -> pausa spenta -> riaccensione.
    // Durate e offset differenti evitano che le stelle si muovano insieme;
    // la seconda catena usa altri numeri (j = i + 100), cosi' non ripete la prima.
    if (st.twinkle[i] && v > 5) v = (v * fattoreScintillio(cs, k, i)) / 100U;   // 0 = nero

    // colore = tinta in % per canale (default 100,72,38 = bianco caldo).
    np.setPixelColor(i, np.Color(
      (uint8_t)((v * cs.colore.r) / 100U),
      (uint8_t)((v * cs.colore.g) / 100U),
      (uint8_t)((v * cs.colore.b) / 100U)
    ));
  }

  // Costellazioni, ognuna con i suoi tempi (accendi / spegni) e la sua luminosita'.
  // Fuori dal ciclo (posStelle < 0) seguono il livello delle stelle.
  //   insieme         tutte le stelle allo stesso livello
  //   una_alla_volta  salendo entrano una dopo l'altra (prima STELLE_01, poi STELLE_02, in
  //                   ordine di numero), scendendo escono al contrario
  //   scintilla       come insieme, ma ogni stella scintilla come quelle scelte a caso
  if (cfg.numCostellazioni) {
    float forma = cs.livelloNotte ? livello * 255.0f / cs.livelloNotte : 0.0f;
    if (forma > 1.0f) forma = 1.0f;
    float L[CFG_MAX_COSTELLAZIONI];
    uint8_t rango[CFG_MAX_COSTELLAZIONI];
    for (uint8_t q = 0; q < cfg.numCostellazioni; q++) {
      L[q] = posStelle >= 0.0f ? livelloCostellazione(cfg.cost[q], posStelle) : forma;
      rango[q] = k ? cfg.cost[q].n0 : 0;
    }
    for (uint8_t i = 0; i < cs.numero; i++) {
      uint8_t n = cfgCost(cfg, k, i);
      if (!n) continue;
      const CfgCostellazione &x = cfg.cost[n - 1];
      float l = L[n - 1];
      if (x.modo == COST_UNA_ALLA_VOLTA && x.n) l = constrain(l * x.n - rango[n - 1], 0.0f, 1.0f);
      rango[n - 1]++;
      uint16_t v = (uint16_t)(x.lum * l + 0.5f);
      if (x.modo == COST_SCINTILLA && v > 5) v = (v * fattoreScintillio(cs, k, i)) / 100U;
      const CfgRGB &col = x.haColore ? x.colore : cs.colore;
      np.setPixelColor(i, np.Color(
        (uint8_t)((v * col.r) / 100U),
        (uint8_t)((v * col.g) / 100U),
        (uint8_t)((v * col.b) / 100U)
      ));
    }
  }
  st.inSospeso = true;
  stelleFlush();
}

// NeoPixel disabilita gli interrupt durante la trasmissione.
// Limitiamo il refresh a 50 Hz per catena per non alterare millis()/Timer0.
// Mentre arrivano byte dall'ESP8266 (Serial3) niente show(): gli interrupt
// spenti dalla trasmissione WS2811 farebbero perdere caratteri. Un aggiornamento
// rimandato resta in sospeso e lo manda loop() appena possibile (serve quando la
// scena non viene piu' ricalcolata: STOP, test da web).
// Al massimo una catena per chiamata (a turno): fra le due trasmissioni (~3 ms
// l'una con 100 pixel) gli interrupt tornano attivi e lnkQuiet() viene ricontrollato,
// cosi' una riga dell'ESP annunciata nel frattempo ferma anche la seconda.
void stelleFlush() {
  static uint8_t turno = 0;
  for (uint8_t n = 0; n < CFG_NUM_CATENE; n++) {
    uint8_t k = (uint8_t)((turno + n) % CFG_NUM_CATENE);
    StatoStelle &st = statoStelle[k];
    unsigned long adessoUs = micros();
    if (st.inSospeso && (unsigned long)(adessoUs - st.ultimoShowUs) >= 20000UL && !lnkQuiet()) {
      catena[k]->show();
      st.ultimoShowUs = adessoUs;
      st.inSospeso = false;
      turno = (uint8_t)(k + 1);
      return;
    }
  }
}

void setStelle(uint8_t k, uint8_t value) {
  if (!cieloGenerato) generaTuttiICieli();
  mostraStelle(k, value / 255.0f);
}

// Tutti i pixel di una catena dello stesso colore (test, autotest).
void riempiCatena(uint8_t k, uint8_t r, uint8_t g, uint8_t b) {
  Adafruit_NeoPixel &np = *catena[k];
  np.clear();
  for (uint16_t i = 0; i < cfg.stelle[k].numero; i++) np.setPixelColor(i, np.Color(r, g, b));
  np.show();
}

void tuttoSpento() {
  setCielo(0, 0, 0);
  setTramonto(0, 0, 0);
  setAlba(0, 0, 0);
  setStelle(0, 0);
  setStelle(1, 0);
}

// ============================================================
// TEMPO / POTENZIOMETRO
// ============================================================

unsigned long durataDaRaw(int raw) {
  raw = potLimita(raw);

  // Tre intervalli uguali della corsa utile [pot_min..pot_max].
  // Con pot_invertito = 1 (cablaggio storico) raw alto = ciclo piu' breve.
  int corsa = cfg.potMax - cfg.potMin;
  int x = cfg.potInvertito ? (cfg.potMax - raw) : (raw - cfg.potMin);
  if (x < (corsa + 1) / 3) return MIN_CYCLE_MS;
  if (x < 2 * (corsa + 1) / 3) return MID_CYCLE_MS;
  return MAX_CYCLE_MS;
}

unsigned long durataCiclo() {
  // La durata usata dal ciclo NON segue il rumore istantaneo dell'ADC.
  return durataCicloStabile;
}

void stampaDurataOled(unsigned long durata) {
  unsigned long secondi = (durata + 500UL) / 1000UL;
  unsigned int mm = secondi / 60UL;
  unsigned int ss = secondi % 60UL;
  if (mm < 10) display.print('0');
  display.print(mm);
  display.print(':');
  if (ss < 10) display.print('0');
  display.print(ss);
}

float percentualeCiclo(unsigned long durata) {
  unsigned long riferimento = running ? millis() : pauseStartedMs;
  unsigned long elapsed = riferimento - cycleStartMs;
  elapsed %= durata;
  return (elapsed * 100.0f) / durata;
}

float progresso(float p, float inizio, float fine) {
  if (fine <= inizio) return 0.0f;
  return constrain((p - inizio) / (fine - inizio), 0.0f, 1.0f);
}

uint8_t interpola8(uint8_t da, uint8_t a, float t) {
  t = constrain(t, 0.0f, 1.0f);
  return (uint8_t)(da + ((float)a - da) * t);
}

// ============================================================
// FASI
// ============================================================

Fase faseDaPercentuale(float p) {
  if (p < P_TRAMONTO) return GIORNO;
  if (p < P_CREPU)    return TRAMONTO;
  if (p < P_NOTTE)    return CREPUSCOLO;
  if (p < P_ALBA)     return NOTTE;
  return ALBA;
}

const char* nomeFase(Fase f) {
  switch (f) {
    case GIORNO:        return "GIORNO";
    case TRAMONTO:      return "TRAMONTO";
    case CREPUSCOLO:    return "CREPUSCOLO";
    case NOTTE:         return "NOTTE";
    case ALBA:          return "ALBA";
  }
  return "?";
}

float inizioFase(Fase f) {
  switch (f) {
    case GIORNO:        return 0.0f;
    case TRAMONTO:      return P_TRAMONTO;
    case CREPUSCOLO:    return P_CREPU;
    case NOTTE:         return P_NOTTE;
    case ALBA:          return P_ALBA;
  }
  return 0.0f;
}

Fase faseSuccessiva(Fase f) {
  switch (f) {
    case GIORNO:        return TRAMONTO;
    case TRAMONTO:      return CREPUSCOLO;
    case CREPUSCOLO:    return NOTTE;
    case NOTTE:         return ALBA;
    case ALBA:          return GIORNO;
  }
  return GIORNO;
}

float fineFase(Fase f) {
  switch (f) {
    case GIORNO:     return P_TRAMONTO;
    case TRAMONTO:   return P_CREPU;
    case CREPUSCOLO: return P_NOTTE;
    case NOTTE:      return P_ALBA;
    case ALBA:       return 100.0f;
  }
  return 100.0f;
}

uint8_t indiceFase(Fase f) {
  return (uint8_t)f;
}

void scriviRele(uint8_t indice, bool acceso) {
  if (indice >= 16) return;
  if (acceso) releStato |= (uint16_t)(1U << indice); else releStato &= (uint16_t)~(1U << indice);
  digitalWrite(PIN_RELE[indice],
               acceso ? (RELE_ACTIVE_LOW ? LOW : HIGH)
                      : (RELE_ACTIVE_LOW ? HIGH : LOW));
}

// Ricostruisce lo stato dei 16 relè direttamente dalla posizione corrente
// del ciclo. Questo rende la schedulazione deterministica anche dopo AVANTI,
// pausa/ripresa o variazioni della durata del ciclo.
void aggiornaReleSchedulati(float p) {
  Fase faseAttuale = faseDaPercentuale(p);
  float inizio = inizioFase(faseAttuale);
  float fine = fineFase(faseAttuale);
  float pctFase = (fine > inizio)
                    ? constrain((p - inizio) * 100.0f / (fine - inizio), 0.0f, 100.0f)
                    : 0.0f;

  for (uint8_t r = 0; r < 16; r++) {
    bool stato = false;
    bool trovato = false;
    uint16_t posizioneMigliore = 0;

    if (cfg.forza[r] == FORZA_ON)  { scriviRele(r, true);  continue; }
    if (cfg.forza[r] == FORZA_OFF) { scriviRele(r, false); continue; }

    // Sceglie l'evento cronologicamente piu' recente gia' raggiunto,
    // indipendentemente dall'ordine delle righe nella tabella.
    for (uint8_t i = 0; i < NUM_EVENTI_RELE; i++) {
      const CfgEvento &ev = cfg.eventi[i];
      if (ev.rele != r) continue;

      bool fasePassata = ev.fase < indiceFase(faseAttuale);
      bool faseCorrenteRaggiunta =
        ev.fase == indiceFase(faseAttuale) && pctFase >= ev.pct;
      if (!fasePassata && !faseCorrenteRaggiunta) continue;

      uint16_t posizione = (uint16_t)ev.fase * 101U + ev.pct;
      if (!trovato || posizione >= posizioneMigliore) {
        trovato = true;
        posizioneMigliore = posizione;
        stato = ev.acceso;
      }
    }

    scriviRele(r, stato);
  }
}

// ============================================================
// OLED
// ============================================================

void oledMostraPopup(OledPopup tipo) {
  if (!oledPresente) return;
  oledPopup = tipo;
  oledPopupFino = millis() + OLED_POPUP_MS;
}

float percentualeFase(float p, Fase f) {
  float a = inizioFase(f), b = 100.0f;
  switch (f) {
    case GIORNO: b = P_TRAMONTO; break;
    case TRAMONTO: b = P_CREPU; break;
    case CREPUSCOLO: b = P_NOTTE; break;
    case NOTTE: b = P_ALBA; break;
    case ALBA: b = 100.0f; break;
  }
  return constrain((p-a)*100.0f/(b-a),0.0f,100.0f);
}

void oledCentro(const __FlashStringHelper *s, int y, uint8_t size) {
  display.setTextSize(size);
  int16_t x1,y1; uint16_t w,h;
  display.getTextBounds(s,0,y,&x1,&y1,&w,&h);
  display.setCursor((OLED_W-w)/2,y);
  display.print(s);
}

void mostraOledTest() {
  if (!oledPresente) return;
  display.clearDisplay();
  display.setTextColor(SSD1306_WHITE);
  display.setTextSize(1);
  display.setCursor(0,0); display.print(F("MODALITA' TEST"));
  if (testWeb) {                     // comandi dalla pagina web
    display.setCursor(0,18); display.print(F("TEST DA WEB"));
    display.setCursor(0,32); display.print(F("comandi dal telefono"));
    display.setCursor(0,48); display.print(F("TEST=passi START=esci"));
    display.display();
    return;
  }
  if (testMostraPot) {               // ultimo passo: il potenziometro letto dal vivo
    int raw = analogRead(PIN_POT), lim = potLimita(raw);
    int corsa = cfg.potMax - cfg.potMin;
    int pct = corsa > 0 ? (int)((long)(lim - cfg.potMin) * 100L / corsa) : 0;
    display.setCursor(0,14); display.print(F("POTENZIOMETRO"));
    display.setCursor(0,24); display.print(F("A0: ")); display.print(raw); display.print(F("  ")); display.print(pct); display.print('%');
    display.setCursor(0,34); display.print(F("corsa ")); display.print(cfg.potMin); display.print(F("..")); display.print(cfg.potMax);
    display.setCursor(0,44); display.print(F("ciclo ")); stampaDurataOled(durataDaRaw(raw));
    display.setCursor(0,54); display.print(F("TEST=avanti START=esci"));
    display.display();
    return;
  }
  if (testMostraIP) {                // [WIFI] abilitato: passo con l'indirizzo
    bool ap = cfg.wifiAbilitato == 2 || wifiAp;
    display.setCursor(0,14); display.print(ap ? F("WI-FI ACCESS POINT") : F("WI-FI"));
    if (ap) { display.setCursor(0,24); display.print(F("rete ")); display.print(cfg.apSsid); }
    display.setCursor(0, ap ? 34 : 28); display.print(F("IP: ")); display.print(wifiIp);
    display.setCursor(0, ap ? 43 : 38);
    if (strcmp(wifiIp, "none") != 0) { display.print(cfg.wifiNome); display.print(F(".local")); }
    else display.print(ap ? F("ESP non risponde") : cfg.wifiAbilitato == 3 ? F("cerco la rete...") : F("non collegato"));
    display.setCursor(0,52); display.print(F("TEST=avanti START=esci"));
    display.display();
    return;
  }
  display.setCursor(0,18); display.print(F("Test ")); display.print(testIndice + 1); display.print(F("/34"));
  display.setCursor(0,32);
  if (testIndice < 18) {
    switch (testIndice) {
      case 0: display.print(F("CIELO ROSSO")); break;
      case 1: display.print(F("CIELO VERDE")); break;
      case 2: display.print(F("CIELO BLU")); break;
      case 3: display.print(F("TRAMONTO ROSSO")); break;
      case 4: display.print(F("TRAMONTO VERDE")); break;
      case 5: display.print(F("TRAMONTO BLU")); break;
      case 6: display.print(F("ALBA ROSSO")); break;
      case 7: display.print(F("ALBA VERDE")); break;
      case 8: display.print(F("ALBA BLU")); break;
      case 9: display.print(F("STELLE_01 ROSSE")); break;
      case 10: display.print(F("STELLE_01 VERDI")); break;
      case 11: display.print(F("STELLE_01 BLU")); break;
      case 12: display.print(F("STELLE_01 TUTTE")); break;
      case 13: display.print(F("STELLE_02 ROSSE")); break;
      case 14: display.print(F("STELLE_02 VERDI")); break;
      case 15: display.print(F("STELLE_02 BLU")); break;
      case 16: display.print(F("STELLE_02 TUTTE")); break;
      case 17: display.print(F("TUTTO INSIEME")); break;
    }
  } else {
    uint8_t n = testIndice - 18;
    uint8_t gruppo = n / 4 + 1;
    uint8_t rele = n % 4 + 1;
    display.print(F("Grp_"));
    if (gruppo < 10) display.print('0');
    display.print(gruppo);
    display.print('_');
    if (rele < 10) display.print('0');
    display.print(rele);
    if (cfg.nome[n][0]) {            // [RELE] nomeN
      display.setCursor(0,40);
      display.print(cfg.nome[n]);
    }
  }
  display.setCursor(0,48); display.print(F("TEST=avanti START=esci"));
  display.display();
}

void mostraOledRgbPausa(float p) {
  if (!oledPresente) return;
  Fase f = faseDaPercentuale(p);
  int pf = (int)(percentualeFase(p, f) + 0.5f);

  display.clearDisplay();
  display.setTextColor(SSD1306_WHITE);
  display.setTextSize(1);
  display.setCursor(0,0);
  display.print(F("PAUSA"));
  display.setCursor(0,18);
  display.print(nomeFase(f));
  display.print(' ');
  display.print(pf);
  display.print('%');

  display.setCursor(0,30);
  display.print(F("C "));
  display.print(rgbCieloR); display.print(',');
  display.print(rgbCieloG); display.print(',');
  display.print(rgbCieloB);

  display.setCursor(0,41);
  display.print(F("T "));
  display.print(rgbTramontoR); display.print(',');
  display.print(rgbTramontoG); display.print(',');
  display.print(rgbTramontoB);

  display.setCursor(0,52);
  display.print(F("A "));
  display.print(rgbAlbaR); display.print(',');
  display.print(rgbAlbaG); display.print(',');
  display.print(rgbAlbaB);

  display.display();
}

void aggiornaOled(unsigned long durata, float p) {
  if (!oledPresente) return;
  static unsigned long ultimoRefresh=0;
  if (millis()-ultimoRefresh < 120) return;
  ultimoRefresh=millis();

  // In pausa i valori RGB restano visibili stabilmente, così possono essere
  // annotati e riutilizzati per tarare i colori della scenografia.
  if (!running && !testInCorso) {
    mostraOledRgbPausa(p);
    return;
  }

  if (oledPopup != OLED_NESSUNO && (long)(millis()-oledPopupFino)>=0) oledPopup=OLED_NESSUNO;
  display.clearDisplay();
  display.setTextColor(SSD1306_WHITE);

  if (oledPopup != OLED_NESSUNO) {
    display.setTextSize(2);
    display.setCursor(8,18);
    switch(oledPopup) {
      case OLED_PAUSA: display.print(F("PAUSA")); break;
      case OLED_RIPRESA: display.print(F("RIPRESA")); break;
      case OLED_PLAY: display.print(F("PLAY")); break;
      case OLED_AVANTI: display.print(F("AVANTI")); break;
      case OLED_TEST: display.print(F("TEST")); break;
      case OLED_VELOCITA: display.print(F("VELOCITA")); break;
      default: break;
    }
    display.setTextSize(1);
    display.setCursor(8,42);
    if (oledPopup==OLED_VELOCITA) {
      stampaDurataOled(durata);
      display.print(F(" (mm:ss)"));
    } else if (oledPopup==OLED_AVANTI) {
      display.print(F("Fase: ")); display.print(nomeFase(faseDaPercentuale(p)));
    } else if (oledPopup==OLED_TEST) {
      display.print(F("Test uscite in corso"));
    } else if (oledPopup==OLED_PLAY) {
      display.print(F("Ciclo dall'inizio"));
    } else {
      display.print(running ? F("Ciclo in esecuzione") : F("Ciclo fermo"));
    }
  } else {
    Fase f=faseDaPercentuale(p);
    int pf=(int)(percentualeFase(p,f)+0.5f);
    display.setTextSize(1);
    display.setCursor(0,0); display.print(F("PSN-PRESEPE"));
    display.setCursor(0,18); display.print(nomeFase(f));
    display.setCursor(94,18); display.print(pf); display.print('%');
    display.drawRect(0,31,128,11,SSD1306_WHITE);
    int fill=(pf*124)/100;
    if(fill>0) display.fillRect(2,33,fill,7,SSD1306_WHITE);
    display.setCursor(0,50);
    display.print(running ? F("RUN ") : F("PAUSA "));
    stampaDurataOled(durata);
    display.print(F(" (mm:ss)"));
  }
  display.display();
}

bool inizializzaOled() {
  Wire.begin();
#if defined(WIRE_HAS_TIMEOUT)
  Wire.setWireTimeout(25000UL, true);
#endif
  Wire.beginTransmission(OLED_ADDR);
  if (Wire.endTransmission()!=0) return false;
  if (!display.begin(SSD1306_SWITCHCAPVCC, OLED_ADDR)) return false;
  display.clearDisplay();
  display.setTextColor(SSD1306_WHITE);
  display.setTextSize(1);
  // Startup splash: PSN-Presepe! by Vanni
  display.setCursor(27,18); display.print(F("PSN-Presepe!"));
  display.setCursor(30,30); display.print(F("by Vanni 039"));
  display.setCursor(18,46);
  stampaDurataOled(durataCicloStabile);
  display.print(F(" (mm:ss)"));
  display.setCursor(12,56); display.print(F("TEST = modo colore"));
  display.display();
  return true;   // i 3 s dello splash li gestisce attesaSplash() in setup()

}

// Esito della lettura microSD, mostrato dopo lo splash per 2,5 s.
void mostraStatoSD() {
  if (!oledPresente) return;
  // [SISTEMA] fastboot = 1: la schermata compare solo se PRESEPE.INI contiene errori.
  if (cfg.fastboot && cfg.sdStato != SD_OK_ERRORI && !iniCreato) return;
  display.clearDisplay();
  if (iniCreato) {               // primo avvio con questa microSD: si vede sempre, anche con fastboot
    display.setTextColor(SSD1306_WHITE);
    display.setTextSize(1);
    display.setCursor(0, 0);  display.print(F("MICRO SD"));
    display.setCursor(0, 16); display.print(F("PRESEPE.INI CREATO"));
    display.setCursor(0, 28); display.print(F("valori predefiniti"));
    display.setCursor(0, 40); display.print(F("modificalo dal PC"));
    display.setCursor(0, 52); display.print(F("e riavvia"));
    display.display();
    delay(4000);
    return;
  }
  display.setTextColor(SSD1306_WHITE);
  display.setTextSize(1);
  display.setCursor(0, 0);  display.print(F("MICRO SD"));
  display.setCursor(0, 16);
  switch (cfg.sdStato) {
    case SD_OK:        display.print(cfgFileLetto); display.print(F(" OK")); break;
    case SD_OK_ERRORI: display.print(F("INI CON ERRORI")); break;
    case SD_NO_FILE:   display.print(F("MANCA PRESEPE.INI")); break;
    default:           display.print(F("SD ASSENTE")); break;
  }
  display.setCursor(0, 28);
  if (cfg.sdStato == SD_OK || cfg.sdStato == SD_OK_ERRORI) {
    display.print(F("Righe ")); display.print(cfg.righeLette);
    display.print(F(" eventi ")); display.print(cfg.numEventi);
  } else {
    display.print(F("Uso valori default"));
  }
  if (cfg.errori) {
    display.setCursor(0, 40);
    display.print(F("Errori ")); display.print(cfg.errori);
    display.setCursor(0, 52);
    if (cfg.primaRigaErrata == 0xFFFF) display.print(F("valori incoerenti"));
    else { display.print(F("prima riga ")); display.print(cfg.primaRigaErrata); }
  }
  display.display();
  delay(cfg.errori ? 5000 : 2500);
}

void stampaConfig() {
  if (iniCreato) Serial.println(F("microSD: PRESEPE.INI mancante -> creato con i valori predefiniti e le spiegazioni"));
  Serial.print(F("microSD: "));
  switch (cfg.sdStato) {
    case SD_OK:        Serial.print(cfgFileLetto); Serial.println(F(" letto senza errori")); break;
    case SD_OK_ERRORI: Serial.print(cfgFileLetto); Serial.print(F(" letto, righe ignorate: ")); Serial.print(cfg.errori);
                       Serial.print(F(" (prima: ")); Serial.print(cfg.primaRigaErrata); Serial.println(F(")")); break;
    case SD_NO_FILE:   Serial.println(F("scheda presente ma PRESEPE.INI / PRESEPE.TXT mancante -> default")); break;
    default:           Serial.println(F("assente o non leggibile -> default")); break;
  }
  Serial.print(F("Scheda inserita (D49): ")); Serial.println(digitalRead(PIN_SD_CD) == LOW ? F("si") : F("no/contatto assente"));
  Serial.print(F("Durate (s): ")); Serial.print(cfg.durataMs[0] / 1000UL); Serial.print('/');
  Serial.print(cfg.durataMs[1] / 1000UL); Serial.print('/'); Serial.println(cfg.durataMs[2] / 1000UL);
  Serial.print(F("Fasi %: ")); Serial.print(cfg.pTramonto); Serial.print(' '); Serial.print(cfg.pCrepuscolo);
  Serial.print(' '); Serial.print(cfg.pNotte); Serial.print(' '); Serial.println(cfg.pAlba);
  {
    static const char *const NOMI_STRISCE[CFG_NUM_STRISCE] = { "CIELO", "TRAMONTO", "ALBA" };
    for (uint8_t s = 0; s < CFG_NUM_STRISCE; s++) {
      Serial.print(F("Tappe ")); Serial.print(NOMI_STRISCE[s]); Serial.print(F(": "));
      Serial.print(cfg.numTappe[s]); Serial.println(cfg.tappeDaFile[s] ? F(" (in parte o tutte dal file)") : F(" (predefinite)"));
      for (uint8_t i = 0; i < cfg.numTappe[s]; i++) {
        const CfgTappa &t = cfg.tappe[s][i];
        Serial.print(F("  ")); Serial.print(cfgNomeFase(t.fase)); Serial.print(' '); Serial.print(t.pct);
        Serial.print(F("% -> ")); Serial.print(t.col.r); Serial.print(','); Serial.print(t.col.g); Serial.print(',');
        Serial.print(t.col.b); Serial.println(t.curva == CURVA_LINEARE ? F(" lineare") : F(" morbida"));
      }
    }
  }
  Serial.print(F("Eventi rele': ")); Serial.println(cfg.numEventi);
  for (uint8_t i = 0; i < cfg.numEventi; i++) {
    Serial.print(F("  ")); Serial.print(cfgNomeFase(cfg.eventi[i].fase)); Serial.print(F(" "));
    Serial.print(cfg.eventi[i].pct); Serial.print(F("% rele' ")); Serial.print(cfg.eventi[i].rele + 1);
    if (cfg.nome[cfg.eventi[i].rele][0]) { Serial.print(F(" (")); Serial.print(cfg.nome[cfg.eventi[i].rele]); Serial.print(')'); }
    Serial.println(cfg.eventi[i].acceso ? F(" ON") : F(" OFF"));
  }
  for (uint8_t k = 0; k < CFG_NUM_CATENE; k++) {
    Serial.print(F("STELLE_0")); Serial.print(k + 1); Serial.print(F(": ")); Serial.print(cfg.stelle[k].numero);
    Serial.print(F(" pixel, attive ")); Serial.println(cfg.stelle[k].attive);
  }
  if (cfg.wifiAbilitato == 3) {
    Serial.print(F("WiFi: automatico, rete di casa \"")); Serial.print(cfg.wifiSsid);
    Serial.print(F("\"; se non si collega entro ")); Serial.print(cfg.apAttesa); Serial.println(F(" s apre l'access point"));
  }
  if (cfg.wifiAbilitato >= 2) {
    Serial.print(F("WiFi: access point, rete \"")); Serial.print(cfg.apSsid);
    Serial.print(F("\"")); if (cfg.apNascosta) Serial.print(F(" (nascosta)"));
    Serial.print(F(", canale ")); Serial.print(cfg.apCanale);
    Serial.print(F(", pagina http://")); for (uint8_t i = 0; i < 4; i++) { if (i) Serial.print('.'); Serial.print(cfg.apIp[i]); }
    Serial.print(F("/ o http://")); Serial.print(cfg.wifiNome); Serial.print(F(".local utente "));
    Serial.println(cfg.webUtente);
    if (!strcmp(cfg.apPassword, "presepe2026")) Serial.println(F("WiFi: ATTENZIONE password dell'access point ancora quella di default"));
    if (!strcmp(cfg.webPassword, "presepe2026")) Serial.println(F("WiFi: ATTENZIONE password della pagina ancora quella di default"));
  } else if (cfg.wifiAbilitato) {
    Serial.print(F("WiFi: abilitato, rete \"")); Serial.print(cfg.wifiSsid);
    Serial.print(F("\", pagina http://")); Serial.print(cfg.wifiNome); Serial.print(F(".local utente "));
    Serial.println(cfg.webUtente);
    if (!strcmp(cfg.webPassword, "presepe2026")) Serial.println(F("WiFi: ATTENZIONE password della pagina ancora quella di default"));
  } else {
    Serial.println(F("WiFi: spento ([WIFI] abilitato = 0)"));
  }
}

void saltaAPercentuale(float p) {
  unsigned long durata = durataCiclo();
  // Arrotonda al millisecondo piu' vicino e entra 1 ms dentro la fase:
  // evita che il troncamento float lasci AVANTI appena prima del confine.
  unsigned long offset = (unsigned long)((durata * (p / 100.0f)) + 0.5f);
  if (p > 0.0f && offset < durata - 1UL) offset++;

  unsigned long riferimento = running ? millis() : pauseStartedMs;
  cycleStartMs = riferimento - offset;
}

void faseAvanti() {
  unsigned long durata = durataCiclo();
  float p = percentualeCiclo(durata);
  Fase nuova = faseSuccessiva(faseDaPercentuale(p));

  saltaAPercentuale(inizioFase(nuova));

  buzzerBeep();
  Serial.print(F("AVANTI -> "));
  Serial.println(nomeFase(nuova));
  oledMostraPopup(OLED_AVANTI);
}

// ============================================================
// SCENA
// ============================================================

// Le stelle (scelte a caso e costellazioni) come nella posizione p del ciclo: le usa il ciclo
// (aggiornaScena) e il test da web ("S 3", l'editor che scorre la linea del tempo).
void stelleAPosizione(float p) {
  Fase fase = faseDaPercentuale(p);

  // Genera una nuova disposizione a ogni ingresso nel crepuscolo.
  if (fase == CREPUSCOLO && ultimaFaseStelle != CREPUSCOLO) {
    generaTuttiICieli();
  }
  ultimaFaseStelle = fase;

  // Stelle (le due catene allo stesso modo, ognuna col suo livello_notte):
  // compaiono nel CREPUSCOLO (lineare), piene di NOTTE, si dissolvono durante
  // tutta l'ALBA (curva morbida).
  uint8_t livelloStelle[CFG_NUM_CATENE];
  for (uint8_t k = 0; k < CFG_NUM_CATENE; k++) {
    uint8_t notte = cfg.stelle[k].livelloNotte;
    switch (fase) {
      case CREPUSCOLO:
        livelloStelle[k] = interpola8(0, notte, progresso(p, P_CREPU, P_NOTTE));
        break;
      case NOTTE:
        livelloStelle[k] = notte;
        break;
      case ALBA: {
        float t = progresso(p, P_ALBA, 100.0f);
        float tStelle = t * t * (3.0f - 2.0f * t);
        livelloStelle[k] = interpola8(notte, 0, tStelle);
        break;
      }
      default:
        livelloStelle[k] = 0;
        break;
    }
  }

  posStelle = p;                     // le costellazioni usano la posizione nel ciclo
  for (uint8_t k = 0; k < CFG_NUM_CATENE; k++) setStelle(k, livelloStelle[k]);
  posStelle = -1.0f;
}

void aggiornaScena(float p) {
  // Strisce RGB: colore calcolato dalle tappe di [CIELO], [TRAMONTO], [ALBA]
  // (vedi cfgColoreTappe nel blocco CONFIG). Le tappe di default riproducono
  // le curve storiche: le laterali restano a PWM esattamente zero quando inattive.
  CfgRGB cielo = cfgColoreTappe(cfg, CFG_S_CIELO, p);
  CfgRGB tram  = cfgColoreTappe(cfg, CFG_S_TRAMONTO, p);
  CfgRGB alba  = cfgColoreTappe(cfg, CFG_S_ALBA, p);
  setCielo(cielo.r, cielo.g, cielo.b);
  setTramonto(tram.r, tram.g, tram.b);
  setAlba(alba.r, alba.g, alba.b);
  stelleAPosizione(p);
}

// ============================================================
// PULSANTI
// ============================================================

bool pulsantePremuto(uint8_t pin,
                     bool &lastRead,
                     bool &stable,
                     unsigned long &lastChange) {

  bool lettura = digitalRead(pin);
  unsigned long now = millis();

  if (lettura != lastRead) {
    lastRead = lettura;
    lastChange = now;
  }

  if ((now - lastChange) >= DEBOUNCE_MS && lettura != stable) {
    stable = lettura;

    if (stable == LOW)
      return true;
  }

  return false;
}

void toggleStartStop() {
  if (testInCorso) {
    tuttoSpento();
    spegniRele();
    testInCorso = false;
    testIndice = 0;
    testWeb = false;
    testMostraIP = false;
    testMostraPot = false;

    // Il tempo passato in TEST non deve far avanzare il ciclo.
    if (testEraInMarcia) {
      cycleStartMs += millis() - testPausaMs;
      running = true;
    } else {
      pauseStartedMs = millis();
      running = false;
    }

    Serial.println(F("USCITA MODALITA' TEST"));
    buzzerBeep();
    oledPopup = OLED_NESSUNO;
    float p = percentualeCiclo(durataCiclo());
    aggiornaScena(p);
    aggiornaReleSchedulati(p);
    aggiornaOled(durataCiclo(), p);
    return;
  }

  if (running) {
    pauseStartedMs = millis();
    running = false;
    Serial.println(F("PAUSA"));
    buzzerBeep();
    oledPopup = OLED_NESSUNO;
  } else {
    unsigned long durataPausa = millis() - pauseStartedMs;

    // Sposta l'origine del ciclo per riprendere esattamente
    // dal punto in cui era stato fermato.
    cycleStartMs += durataPausa;

    running = true;
    Serial.println(F("RIPRESA"));
    buzzerBeep();
    oledMostraPopup(OLED_RIPRESA);
  }
}

// ============================================================
// TEST
// ============================================================

// LED di stato:
//   ciclo in marcia   lampo breve ogni 2 s (doppio lampo se PRESEPE.INI ha errori o manca la microSD)
//   pausa             1 s acceso, 1 s spento
//   TEST / colore     lampeggio veloce (4 al secondo)
//   STOP              spento
//   avvio             acceso fisso
extern bool modalitaColore;
void aggiornaLedStato() {
  unsigned long t = millis();
  bool on;
  if (fermo) on = false;
  else if (testInCorso || modalitaColore) on = (t / 125) & 1;
  else if (!running) on = (t / 1000) & 1;
  else {
    unsigned long f = t % 2000;
    bool avviso = cfg.sdStato != SD_OK;          // errori nel file, file mancante o microSD assente
    on = f < 80 || (avviso && f >= 240 && f < 320);
  }
  digitalWrite(LED_STATO, on ? HIGH : LOW);
}

void spegniRele() {
  for (uint8_t i = 0; i < 16; i++)
    scriviRele(i, false);
}

// STOP (START tenuto 2 s, o pulsante Stop della pagina web): spegne tutto, anche i
// rele' forzati con forzaN = on, e resta cosi' finche' non arriva PLAY.
void fermaPresepe() {
  if (fermo) return;
  if (testInCorso) { testInCorso = false; testWeb = false; testMostraIP = false; testMostraPot = false; testIndice = 0; }
  fermo = true;
  running = false;
  pauseStartedMs = millis();
  oledPopup = OLED_NESSUNO;
  tuttoSpento();
  spegniRele();
  buzzerBeep();
  Serial.println(F("STOP: tutto spento (START breve = PLAY)"));
  mostraOledStop();
}

// PLAY: riparte dall'inizio del GIORNO, in marcia.
void avviaPresepe() {
  if (!fermo) return;
  fermo = false;
  running = true;
  cycleStartMs = millis();
  cieloGenerato = false; ultimaFaseStelle = GIORNO;
  buzzerBeep();
  Serial.println(F("PLAY: ciclo dall'inizio del GIORNO"));
  oledMostraPopup(OLED_PLAY);
}

void mostraOledStop() {
  if (!oledPresente) return;
  display.clearDisplay();
  display.setTextColor(SSD1306_WHITE);
  display.setTextSize(3);
  display.setCursor(28, 8); display.print(F("STOP"));
  display.setTextSize(1);
  display.setCursor(0, 40); display.print(F("tutto spento"));
  display.setCursor(0, 54); display.print(F("START = PLAY"));
  display.display();
}

void accendiRele(uint8_t indice) {
  spegniRele();
  if (indice < 16)
    scriviRele(indice, true);
}

void applicaTestCorrente() {
  tuttoSpento();
  spegniRele();

  if (testMostraPot) {
    Serial.print(F("TEST - POTENZIOMETRO A0: "));
    Serial.println(analogRead(PIN_POT));
    mostraOledTest();
    return;
  }
  if (testMostraIP) {
    Serial.print(F("TEST - WIFI IP: "));
    Serial.println(wifiIp);
    mostraOledTest();
    return;
  }

  if (testIndice >= 18) {
    uint8_t n = testIndice - 18;
    accendiRele(n);
    uint8_t gruppo = n / 4 + 1;
    uint8_t rele = n % 4 + 1;
    Serial.print(F("TEST "));
    Serial.print(testIndice + 1);
    Serial.print(F("/34 - Grp_0"));
    Serial.print(gruppo);
    Serial.print(F("_0"));
    Serial.print(rele);
    if (cfg.nome[n][0]) { Serial.print(F(" - ")); Serial.print(cfg.nome[n]); }
    Serial.println();
    mostraOledTest();
    return;
  }

  switch (testIndice) {
    case 0:
      setCielo(255, 0, 0);
      Serial.println(F("TEST 1/34 - CIELO ROSSO"));
      break;
    case 1:
      setCielo(0, 255, 0);
      Serial.println(F("TEST 2/34 - CIELO VERDE"));
      break;
    case 2:
      setCielo(0, 0, 255);
      Serial.println(F("TEST 3/34 - CIELO BLU"));
      break;
    case 3:
      setTramonto(255, 0, 0);
      Serial.println(F("TEST 4/34 - TRAMONTO ROSSO"));
      break;
    case 4:
      setTramonto(0, 255, 0);
      Serial.println(F("TEST 5/34 - TRAMONTO VERDE"));
      break;
    case 5:
      setTramonto(0, 0, 255);
      Serial.println(F("TEST 6/34 - TRAMONTO BLU"));
      break;
    case 6:
      setAlba(255, 0, 0);
      Serial.println(F("TEST 7/34 - ALBA ROSSO"));
      break;
    case 7:
      setAlba(0, 255, 0);
      Serial.println(F("TEST 8/34 - ALBA VERDE"));
      break;
    case 8:
      setAlba(0, 0, 255);
      Serial.println(F("TEST 9/34 - ALBA BLU"));
      break;
    case 9:  riempiCatena(0, 70, 0, 0);   Serial.println(F("TEST 10/34 - STELLE_01 ROSSE")); break;
    case 10: riempiCatena(0, 0, 70, 0);   Serial.println(F("TEST 11/34 - STELLE_01 VERDI")); break;
    case 11: riempiCatena(0, 0, 0, 70);   Serial.println(F("TEST 12/34 - STELLE_01 BLU")); break;
    case 12: riempiCatena(0, 70, 50, 27); Serial.println(F("TEST 13/34 - STELLE_01 TUTTE")); break;
    case 13: riempiCatena(1, 70, 0, 0);   Serial.println(F("TEST 14/34 - STELLE_02 ROSSE")); break;
    case 14: riempiCatena(1, 0, 70, 0);   Serial.println(F("TEST 15/34 - STELLE_02 VERDI")); break;
    case 15: riempiCatena(1, 0, 0, 70);   Serial.println(F("TEST 16/34 - STELLE_02 BLU")); break;
    case 16: riempiCatena(1, 70, 50, 27); Serial.println(F("TEST 17/34 - STELLE_02 TUTTE")); break;
    case 17:
      setCielo(120, 90, 70);
      setTramonto(180, 50, 8);
      setAlba(180, 95, 30);
      riempiCatena(0, 45, 32, 17);
      riempiCatena(1, 45, 32, 17);
      Serial.println(F("TEST 18/34 - TUTTO INSIEME"));
      break;
  }

  mostraOledTest();
}

// Entra nella modalita' test (stato comune a TEST fisico e pagina web).
void entraTest() {
  testInCorso = true;
  testIndice = 0;
  testWeb = false;
  testMostraPot = false;                   // il potenziometro e' l'ultimo passo
  testMostraIP = cfg.wifiAbilitato != 0;   // con il WiFi il primo passo e' l'indirizzo IP
  testEraInMarcia = running;
  testPausaMs = millis();
  running = false;
  oledPopup = OLED_NESSUNO;

  Serial.println();
  Serial.println(F("=== MODALITA' TEST ==="));
  Serial.println(F("TEST = test successivo, START = esci"));
}

void testUscite() {
  if (!testInCorso) {
    entraTest();
  } else if (testWeb) {              // TEST durante il test da web: torna ai passi
    testWeb = false;
    testMostraIP = false;
    testMostraPot = false;
    testIndice = 0;
  } else if (testMostraPot) {        // dopo il potenziometro (ultimo): da capo, dall'IP se c'e' il WiFi
    testMostraPot = false;
    testIndice = 0;
    testMostraIP = cfg.wifiAbilitato != 0;
  } else if (testMostraIP) {
    testMostraIP = false;
    testIndice = 0;
  } else if (testIndice >= 33) {     // dopo l'ultimo rele': il potenziometro
    testMostraPot = true;
  } else {
    testIndice++;
  }
  buzzerBeep();
  applicaTestCorrente();
}

// Test comandato dalla pagina web: uscite tutte spente, poi i comandi del telefono.
void entraTestWeb() {
  if (!testInCorso) entraTest();
  testWeb = true;
  testMostraIP = false;
  testMostraPot = false;
  tuttoSpento();
  spegniRele();
  Serial.println(F("TEST DA WEB"));
  mostraOledTest();
}

// ============================================================
// DEBUG
// ============================================================

void stampaStato(unsigned long durata, float p) {
  Serial.print(F("Fase: "));
  Serial.print(nomeFase(faseDaPercentuale(p)));

  Serial.print(F(" | "));
  Serial.print(p, 1);
  Serial.print(F("%"));

  Serial.print(F(" | ciclo: "));
  Serial.print(durata / 60000UL);
  Serial.print(F(" min"));

  Serial.print(F(" | A0: "));
  Serial.print(analogRead(PIN_POT));

  Serial.print(F(" | "));
  Serial.println(fermo ? F("STOP") : running ? F("RUN") : F("PAUSA"));
}

// ============================================================
// SEQUENZA DI BOOT / AUTOTEST VISIVO
// ============================================================

const uint8_t BOOT_STEP_COUNT = 5;

// "Astro del ciel" sul buzzer passivo opzionale, fino a "mite agnello Redentor".
// Tempo volutamente più sostenuto rispetto alla rev.014.
// Autotest visivo, progress bar e melodia terminano insieme.
const uint16_t BOOT_MELODY_FREQ[] = {
  392, 440, 392, 330, 392, 440, 392, 330,
  587, 587, 494, 523, 523, 392,
  440, 440, 523, 494, 440, 392, 440, 392, 330,
  440, 440, 523, 494, 440, 392, 440, 392, 330
};
const uint16_t BOOT_MELODY_MS[] = {
  420, 420, 560, 900, 420, 420, 560, 900,
  560, 420, 560, 560, 420, 900,
  420, 420, 560, 420, 420, 560, 420, 420, 900,
  420, 420, 560, 420, 420, 560, 420, 420, 1100
};
const uint8_t BOOT_MELODY_COUNT = sizeof(BOOT_MELODY_FREQ) / sizeof(BOOT_MELODY_FREQ[0]);
const unsigned long BOOT_MELODY_BASE_MS = 17300UL; // somma originale di BOOT_MELODY_MS[]
const unsigned long BOOT_TOTAL_MS = 21625UL; // +25%: 5 scene alla stessa durata visiva di prima
const unsigned long BOOT_STEP_MS = BOOT_TOTAL_MS / BOOT_STEP_COUNT; // 4,325 s per scena
int8_t bootNotaCorrente = -1;

void aggiornaMelodiaBoot(unsigned long elapsedTotale) {
  if (!cfg.melodiaAvvio || !cfg.buzzer) return;   // [SISTEMA] melodia_avvio / buzzer
  unsigned long limite = 0;
  uint8_t nota = BOOT_MELODY_COUNT;
  for (uint8_t i = 0; i < BOOT_MELODY_COUNT; i++) {
    limite += ((unsigned long)BOOT_MELODY_MS[i] * BOOT_TOTAL_MS) / BOOT_MELODY_BASE_MS;
    if (elapsedTotale < limite) {
      nota = i;
      break;
    }
  }

  if (nota >= BOOT_MELODY_COUNT) {
    if (bootNotaCorrente != -1) {
      noTone(PIN_BUZZER);
      bootNotaCorrente = -1;
    }
    return;
  }

  if (bootNotaCorrente != (int8_t)nota) {
    tone(PIN_BUZZER, BOOT_MELODY_FREQ[nota]);
    bootNotaCorrente = nota;
  }
}

void mostraOledBoot(const __FlashStringHelper *fase, uint8_t step, unsigned long elapsedStep) {
  if (!oledPresente) return;

  // Avanzamento complessivo sui 5 passi, sincronizzato alla durata della melodia.
  unsigned long fatto = (unsigned long)step * BOOT_STEP_MS + elapsedStep;
  unsigned long totale = (unsigned long)BOOT_STEP_COUNT * BOOT_STEP_MS;
  uint8_t pct = (uint8_t)min(100UL, (fatto * 100UL) / totale);

  display.clearDisplay();
  display.setTextColor(SSD1306_WHITE);
  display.setTextSize(1);
  display.setCursor(0, 0);
  display.print(F("PSN-PRESEPE"));
  display.setCursor(0, 18);
  display.print(F("Inizializzazione"));
  display.setCursor(0, 30);
  display.print(fase);
  display.setCursor(102, 30);
  display.print(pct);
  display.print('%');

  display.drawRect(0, 45, 128, 11, SSD1306_WHITE);
  int fill = (pct * 124) / 100;
  if (fill > 0) display.fillRect(2, 47, fill, 7, SSD1306_WHITE);
  display.display();
}

void attesaBoot(const __FlashStringHelper *fase, uint8_t step) {
  unsigned long start = millis();
  unsigned long elapsed = 0;
  do {
    elapsed = millis() - start;
    if (elapsed > BOOT_STEP_MS) elapsed = BOOT_STEP_MS;
    mostraOledBoot(fase, step, elapsed);
    aggiornaMelodiaBoot((unsigned long)step * BOOT_STEP_MS + elapsed);
    delay(40);
  } while (millis() - start < BOOT_STEP_MS);
}

void eseguiSequenzaBoot() {
  Serial.println(F("BOOT: autotest visivo uscite + melodia buzzer opzionale"));

  tuttoSpento();
  spegniRele();

  // 1/5 - ALBA: primo quarto della melodia.
  setAlba(255, 255, 255);
  attesaBoot(F("ALBA"), 0);
  setAlba(0, 0, 0);

  // 2/5 - CIELO principale: secondo quarto della melodia.
  setCielo(255, 255, 255);
  attesaBoot(F("CIELO"), 1);
  setCielo(0, 0, 0);

  // 3/5 - TRAMONTO: terzo quarto della melodia.
  setTramonto(255, 255, 255);
  attesaBoot(F("TRAMONTO"), 2);
  setTramonto(0, 0, 0);

  // 4/5 - catena STELLE_01 (D5) tutta accesa.
  riempiCatena(0, 255, 255, 255);
  attesaBoot(F("STELLE_01"), 3);
  riempiCatena(0, 0, 0, 0);

  // 5/5 - catena STELLE_02 (D8) tutta accesa.
  riempiCatena(1, 255, 255, 255);
  attesaBoot(F("STELLE_02"), 4);
  riempiCatena(1, 0, 0, 0);

  // I cinque passi coprono l'intera melodia: luce, progress bar e musica
  // terminano insieme prima di PRONTO.
  aggiornaMelodiaBoot(BOOT_TOTAL_MS);
  noTone(PIN_BUZZER);
  bootNotaCorrente = -1;

  // Fine autotest: tutto spento prima dell'avvio del normale ciclo GIORNO.
  tuttoSpento();
  spegniRele();
  mostraOledBoot(F("PRONTO"), BOOT_STEP_COUNT, 0);
  delay(900);

  Serial.println(F("BOOT: completato"));
}

// ============================================================
// SETUP
// ============================================================

// ============================================================
// MODALITA' COLORE (ricerca dei valori RGB per le tappe)
// ============================================================
// Si entra tenendo premuto TEST all'accensione.
//   Scelta striscia: AVANTI = ALBA -> CIELO -> TRAMONTO, la striscia proposta e' bianca;
//                    START = conferma; TEST tenuto 2 s = esce.
//   Regolazione:     START / AVANTI / TEST brevi = canale R / G / B;
//                    due clic entro 1 s sullo stesso tasto = regolazione fine (+/-16);
//                    START tenuto 2 s = torna alla scelta; TEST tenuto 2 s = esce.
// La striscia riceve il colore con gamma e lum_* come nella scena: il valore
// trovato e' esattamente quello da scrivere nella tappa.

const unsigned long COLORE_LUNGO_MS = 2000UL;
const unsigned long COLORE_DOPPIO_MS = 1000UL;


bool modalitaColore = false;
uint8_t coloreStato = 0;                 // 0 = scelta striscia, 1 = regolazione
uint8_t coloreStriscia = 0;              // indice in ORDINE_STRISCE_COLORE
uint8_t coloreCanale = 0;                // 0 R, 1 G, 2 B
uint8_t coloreFine = 0, coloreBaseFine = 0;
uint8_t coloreValori[CFG_NUM_STRISCE][3];
CfgAggancio coloreAggancio;
unsigned long coloreUltimoClicMs = 0;
int8_t coloreUltimoClicCanale = -1;
unsigned long coloreOledMs = 0, coloreSerialeMs = 0;
uint8_t coloreUltimoPot = 0;            // ultimo valore letto dalla manopola (per "gira verso")
bool coloreDaStampare = false;
TastoColore tastiColore[3];
const uint8_t ORDINE_STRISCE_COLORE[CFG_NUM_STRISCE] = { CFG_S_ALBA, CFG_S_CIELO, CFG_S_TRAMONTO };

const __FlashStringHelper *nomeStrisciaColore(uint8_t s) {
  if (s == CFG_S_CIELO) return F("CIELO");
  if (s == CFG_S_TRAMONTO) return F("TRAMONTO");
  return F("ALBA");
}

void tastoColoreInit(TastoColore &t, uint8_t pin) {
  t.pin = pin;
  bool l = digitalRead(pin);
  t.stabile = l; t.ultimaLettura = l;
  t.lungoFatto = (l == LOW);             // gia' premuto (es. TEST dell'ingresso): ignora fino al rilascio
  t.cambioMs = millis(); t.premutoMs = millis();
}

EventoTasto tastoColoreLeggi(TastoColore &t) {
  bool l = digitalRead(t.pin);
  unsigned long ora = millis();
  if (l != t.ultimaLettura) { t.ultimaLettura = l; t.cambioMs = ora; }
  if ((ora - t.cambioMs) >= DEBOUNCE_MS && l != t.stabile) {
    t.stabile = l;
    if (l == LOW) { t.premutoMs = ora; t.lungoFatto = false; }
    else { bool era = t.lungoFatto; t.lungoFatto = false; if (!era) return TASTO_BREVE; }
  }
  if (t.stabile == LOW && !t.lungoFatto && (ora - t.premutoMs) >= COLORE_LUNGO_MS) {
    t.lungoFatto = true;
    return TASTO_LUNGO;
  }
  return TASTO_NULLA;
}

int letturaPotMedia() {
  long somma = 0;
  for (uint8_t i = 0; i < 4; i++) somma += analogRead(PIN_POT);
  return (int)(somma / 4);
}

void coloreUscite() {
  uint8_t s = ORDINE_STRISCE_COLORE[coloreStriscia];
  uint8_t r = 255, g = 255, b = 255;     // in scelta: bianco
  if (coloreStato == 1) { r = coloreValori[s][0]; g = coloreValori[s][1]; b = coloreValori[s][2]; }
  setCielo(s == CFG_S_CIELO ? r : 0, s == CFG_S_CIELO ? g : 0, s == CFG_S_CIELO ? b : 0);
  setTramonto(s == CFG_S_TRAMONTO ? r : 0, s == CFG_S_TRAMONTO ? g : 0, s == CFG_S_TRAMONTO ? b : 0);
  setAlba(s == CFG_S_ALBA ? r : 0, s == CFG_S_ALBA ? g : 0, s == CFG_S_ALBA ? b : 0);
}

void coloreOled() {
  if (!oledPresente) return;
  uint8_t s = ORDINE_STRISCE_COLORE[coloreStriscia];
  display.clearDisplay();
  display.setTextColor(SSD1306_WHITE);
  display.setTextSize(1);
  display.setCursor(0, 0);
  if (coloreStato == 0) {
    display.print(F("MODALITA' COLORE"));
    display.setTextSize(2);
    display.setCursor(0, 16); display.print(nomeStrisciaColore(s));
    display.setTextSize(1);
    display.setCursor(0, 40); display.print(F("AVANTI = cambia"));
    display.setCursor(0, 52); display.print(F("START = regola"));
  } else {
    const char canali[3] = { 'R', 'G', 'B' };
    display.print(nomeStrisciaColore(s));
    display.setCursor(80, 0); display.print('['); display.print(canali[coloreCanale]);
    if (coloreFine) display.print(F(" FINE"));
    display.print(']');
    display.setCursor(0, 14);
    for (uint8_t c = 0; c < 3; c++) {
      display.print(c == coloreCanale ? '>' : ' ');
      display.print(canali[c]); display.print(coloreValori[s][c]); display.print(' ');
    }
    display.setCursor(0, 28);
    if (coloreAggancio.agganciato) display.print(F("agganciato"));
    else {
      uint8_t obiettivo = coloreValori[s][coloreCanale];
      display.print(coloreUltimoPot < obiettivo ? F("gira + verso ") : F("gira - verso "));
      display.print(coloreFine ? F("centro") : F(""));
      if (!coloreFine) display.print(obiettivo);
    }
    display.setCursor(0, 40);
    display.print(F("tappa: ")); display.print(coloreValori[s][0]); display.print(F(", "));
    display.print(coloreValori[s][1]); display.print(F(", ")); display.print(coloreValori[s][2]);
    display.setCursor(0, 54); display.print(F("S2s=strisce T2s=esci"));
  }
  display.display();
}

void coloreSeriale() {
  uint8_t s = ORDINE_STRISCE_COLORE[coloreStriscia];
  Serial.print(F("COLORE ")); Serial.print(nomeStrisciaColore(s)); Serial.print(F(": tappa = FASE, %, "));
  Serial.print(coloreValori[s][0]); Serial.print(F(", ")); Serial.print(coloreValori[s][1]);
  Serial.print(F(", ")); Serial.println(coloreValori[s][2]);
}

void coloreScegliCanale(uint8_t canale) {
  unsigned long ora = millis();
  uint8_t s = ORDINE_STRISCE_COLORE[coloreStriscia];
  if (canale == coloreCanale && coloreUltimoClicCanale == (int8_t)canale &&
      (ora - coloreUltimoClicMs) <= COLORE_DOPPIO_MS) {
    coloreFine = !coloreFine;            // secondo clic entro 1 s: regolazione fine on/off
    coloreBaseFine = coloreValori[s][canale];
    coloreUltimoClicCanale = -1;         // un terzo clic ricomincia il conteggio
  } else {
    if (canale != coloreCanale) coloreFine = 0;
    coloreCanale = canale;
    coloreUltimoClicCanale = canale;
    coloreUltimoClicMs = ora;
  }
  cfgAggancioReset(coloreAggancio);
  buzzerBeep();
}

void entraModalitaColore() {
  modalitaColore = true;
  coloreStato = 0; coloreStriscia = 0; coloreCanale = 0; coloreFine = 0;
  for (uint8_t s = 0; s < CFG_NUM_STRISCE; s++) {
    CfgRGB c0 = cfg.numTappe[s] ? cfg.tappe[s][0].col : CfgRGB{ 0, 0, 0 };
    if (c0.r == 0 && c0.g == 0 && c0.b == 0 && cfg.numTappe[s] > 1) c0 = cfg.tappe[s][1].col;  // salta lo "spento" iniziale
    coloreValori[s][0] = c0.r; coloreValori[s][1] = c0.g; coloreValori[s][2] = c0.b;
  }
  tastoColoreInit(tastiColore[0], PIN_START);
  tastoColoreInit(tastiColore[1], PIN_NEXT);
  tastoColoreInit(tastiColore[2], PIN_TEST);
  cfgAggancioReset(coloreAggancio);
  tuttoSpento();
  spegniRele();
  coloreUscite();
  coloreOled();
  Serial.println(F("=== MODALITA' COLORE ==="));
  Serial.println(F("Scelta striscia: AVANTI = cambia, START = regola, TEST 2 s = esci"));
}

void esciModalitaColore() {
  modalitaColore = false;
  tuttoSpento();
  // I tasti possono essere ancora premuti: il ciclo normale non deve vederli come pressioni.
  lastStartRead = stableStart = digitalRead(PIN_START);
  lastNextRead  = stableNext  = digitalRead(PIN_NEXT);
  lastTestRead  = stableTest  = digitalRead(PIN_TEST);
  cycleStartMs = millis();
  running = !cfg.partenzaInPausa;
  if (!running) pauseStartedMs = cycleStartMs;
  Serial.println(F("USCITA MODALITA' COLORE: parte il ciclo"));
  buzzerBeep();
}

void loopModalitaColore() {
  EventoTasto e0 = tastoColoreLeggi(tastiColore[0]);
  EventoTasto e1 = tastoColoreLeggi(tastiColore[1]);
  EventoTasto e2 = tastoColoreLeggi(tastiColore[2]);
  bool cambiato = false;

  if (e2 == TASTO_LUNGO) { esciModalitaColore(); return; }

  if (coloreStato == 0) {
    if (e1 == TASTO_BREVE) { coloreStriscia = (coloreStriscia + 1) % CFG_NUM_STRISCE; buzzerBeep(); cambiato = true; }
    if (e0 == TASTO_BREVE) {
      coloreStato = 1; coloreCanale = 0; coloreFine = 0; coloreUltimoClicCanale = -1;
      cfgAggancioReset(coloreAggancio);
      buzzerBeep(); cambiato = true; coloreDaStampare = true;
    }
  } else {
    if (e0 == TASTO_LUNGO) { coloreStato = 0; coloreFine = 0; buzzerBeep(); cambiato = true; }
    else {
      if (e0 == TASTO_BREVE) { coloreScegliCanale(0); cambiato = true; }
      if (e1 == TASTO_BREVE) { coloreScegliCanale(1); cambiato = true; }
      if (e2 == TASTO_BREVE) { coloreScegliCanale(2); cambiato = true; }
      uint8_t s = ORDINE_STRISCE_COLORE[coloreStriscia];
      uint8_t &v = coloreValori[s][coloreCanale];
      uint8_t daPot = cfgValoreDaPot(cfg, letturaPotMedia(), coloreFine, coloreBaseFine);
      if ((daPot < v) != (coloreUltimoPot < v)) cambiato = true;   // cambia il verso da indicare
      coloreUltimoPot = daPot;
      uint8_t eraAgganciato = coloreAggancio.agganciato;
      if (cfgAggancioAggiorna(coloreAggancio, v, daPot)) {
        if (daPot != v) { v = daPot; cambiato = true; coloreDaStampare = true; }
      }
      if (eraAgganciato != coloreAggancio.agganciato) cambiato = true;
    }
  }

  if (cambiato) coloreUscite();
  unsigned long ora = millis();
  if (cambiato && (ora - coloreOledMs) >= 80UL) { coloreOled(); coloreOledMs = ora; }
  else if ((ora - coloreOledMs) >= 500UL) { coloreOled(); coloreOledMs = ora; }   // aggiorna anche lo stato "gira verso"
  if (coloreDaStampare && coloreStato == 1 && (ora - coloreSerialeMs) >= 250UL) {
    coloreSeriale(); coloreSerialeMs = ora; coloreDaStampare = false;
  }
}
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
void loop() {

  buzzerTick();

  lnkTick();                                   // [WIFI]: comandi della pagina web
  if (lnkRiavvio) { riavviaSoftware(); return; }
  stelleFlush();                               // stelle rimaste da inviare (STOP, test da web)
  aggiornaLedStato();

  if (modalitaColore) { loopModalitaColore(); return; }

  // ----- comandi fisici -----

  // START: breve (al rilascio) = pausa/ripresa, o uscita dal TEST; tenuto 2 s = STOP
  // (tutto spento); in STOP una pressione breve = PLAY.
  static bool startGiu = false, startLungo = false;
  static unsigned long startGiuMs = 0;
  if (pulsantePremuto(PIN_START,
                      lastStartRead, stableStart, dbStartMs)) {
    startGiu = true; startLungo = false; startGiuMs = millis();
  }
  if (startGiu) {
    if (stableStart == HIGH) {                         // rilasciato
      startGiu = false;
      if (!startLungo) { if (fermo) avviaPresepe(); else toggleStartStop(); }
    } else if (!startLungo && !fermo && !testInCorso && millis() - startGiuMs >= START_STOP_MS) {
      startLungo = true;                               // il rilascio non fa altro
      fermaPresepe();
    }
  }

  if (pulsantePremuto(PIN_NEXT,
                      lastNextRead, stableNext, dbNextMs)) {
    if (!testInCorso && !fermo) faseAvanti();
  }

  if (pulsantePremuto(PIN_TEST,
                      lastTestRead, stableTest, dbTestMs)) {
    if (!fermo) testUscite();
  }

  // ----- STOP: tutto resta spento -----
  if (fermo) {
    static unsigned long stopOledMs = 0;
    if (millis() - stopOledMs >= 2000) { stopOledMs = millis(); mostraOledStop(); }
    if (DEBUG_INTERVAL_MS && millis() - lastDebugMs >= DEBUG_INTERVAL_MS) {
      lastDebugMs = millis();
      Serial.println(F("STOP (START breve = PLAY)"));
    }
    return;
  }

  // ----- test da web con le stelle a una posizione del ciclo ("S 3"): continuano a scintillare -----
  if (testInCorso && testWeb && webStellePos >= 0.0f && millis() - webStelleMs >= 40UL) {
    webStelleMs = millis();
    stelleAPosizione(webStellePos);
  }

  // ----- passo "potenziometro" del test: il display segue la manopola -----
  if (testInCorso && testMostraPot && !testWeb && millis() - testPotMs >= 150UL) {
    testPotMs = millis();
    mostraOledTest();
  }

  // ----- ciclo scenografico -----

  if (!testInCorso) {
    unsigned long durata = durataCiclo();
    float p = percentualeCiclo(durata);

    int potNow = analogRead(PIN_POT);
    int potNowLimitato = potLimita(potNow);

    // Attendi la stabilizzazione prima di cambiare scaglione.
    // Anche uno spostamento minimo oltre una soglia deve essere rilevato.
    if (ultimoPotOled < 0) {
      ultimoPotOled = potRawStabile;
      potPopupUltimaLettura = potNowLimitato;
    }
    if (abs(potNowLimitato - potPopupUltimaLettura) >= POT_BEEP_STABILITA_DELTA) {
      potPopupUltimaLettura = potNowLimitato;
      potPopupUltimaVariazioneMs = millis();
    }
    // Non usare una soglia RAW fissa: impedirebbe di riconoscere
    // il passaggio tra due scaglioni vicino al loro confine.
    potPopupInAttesa = (durataDaRaw(potNowLimitato) != durataCicloStabile);

    if (potPopupInAttesa &&
        millis() - potPopupUltimaVariazioneMs >= POT_POPUP_SETTLE_MS) {
      potPopupInAttesa = false;
      // Mantieni la stessa posizione percentuale della scena quando cambia
      // la durata totale: cambiare velocita' non deve far saltare fase.
      unsigned long vecchiaDurata = durataCicloStabile;
      unsigned long riferimento = running ? millis() : pauseStartedMs;
      unsigned long elapsedVecchio = (riferimento - cycleStartMs) % vecchiaDurata;
      float posizione = (float)elapsedVecchio / (float)vecchiaDurata;

      potRawStabile = potNowLimitato;
      durataCicloStabile = durataDaRaw(potRawStabile);
      unsigned long nuovoElapsed = (unsigned long)(posizione * durataCicloStabile + 0.5f);
      cycleStartMs = riferimento - nuovoElapsed;
      ultimoPotOled = potRawStabile;
      potRawOled = potRawStabile;
      oledMostraPopup(OLED_VELOCITA);
    }

    buzzerPotTick(potNowLimitato);

    // Se lo scaglione e' cambiato, usa subito la durata e la
    // posizione ricalcolate anche per scena, rele' e display.
    durata = durataCiclo();
    p = percentualeCiclo(durata);
    aggiornaScena(p);
    aggiornaReleSchedulati(p);
    aggiornaOled(durata, p);

    // ----- diagnostica -----
    if (DEBUG_INTERVAL_MS && millis() - lastDebugMs >= DEBUG_INTERVAL_MS) {
      lastDebugMs = millis();
      stampaStato(durata, p);
    }
  }
}
