zanac/PSN-Presepe-2026/firmware/PSN-Presepe-WiFi/PSN-Presepe-WiFi.ino

/*
  PSN-Presepe WiFi - firmware per l'ESP8266 della scheda "Mega + WiFi R3"
  (ATmega2560 + ESP8266 sulla stessa basetta, es. WeMos/RobotDyn).

  L'ESP8266 fa solo da ponte verso la rete: tutta la logica del presepe resta
  nel Mega (firmware/PSN-Presepe/PSN-Presepe.ino). I due chip parlano sulla
  seriale interna (ESP UART0 <-> Mega Serial3, 115200 baud) quando i DIP switch
  1 e 2 sono su ON e il selettore e' su RXD3/TXD3.

  - SSID, password WiFi, nome in rete, utente e password della pagina arrivano
    dal Mega, che li legge dalle sezioni [WIFI], [ACCESS_POINT] e [AUTENTICAZIONE]
    di PRESEPE.INI. [WIFI] abilitato = 1: si collega alla rete di casa; = 2: crea
    una sua rete (access point, http://192.168.4.1/), con portale facoltativo.
  - Pagina "/"        : pannello con stato del ciclo, comandi e test da telefono.
  - Pagina "/config"  : file PRESEPE.INI con anteprima del ciclo; salva e riavvia.
  - http://<nome>.local (mDNS) e aggiornamento del firmware ESP via WiFi (ArduinoOTA,
    password = quella della pagina).

  Protocollo con il Mega: vedi il blocco "LINK WIFI" di PSN-Presepe.ino.
  Comandi ESP -> Mega: "@COMANDO argomenti*HH" (HH = somma dei byte, esadecimale),
  risposta "@OK ..." / "@ERR ...". Senza risposta il comando viene ritrasmesso.

  Compilazione: IDE Arduino con il pacchetto "esp8266" (scheda "Generic ESP8266
  Module", Flash Size "4MB (FS:1MB OTA:~1019KB)", lwIP Variant "v2 Higher Bandwidth"). Caricamento: DIP 5, 6, 7 su ON
  (vedi README). Le pagine web sono in pagine_web.h, generato da
  firmware/tools/build_web.py.
*/
#include <ESP8266WiFi.h>
#include <ESP8266WebServer.h>
#include <ESP8266mDNS.h>
#include <ArduinoOTA.h>
#include <DNSServer.h>
#include <StreamDev.h>
#include "pagine_web.h"
#include "comprimi.h"
#include "ws_mini.h"

#define VERSIONE "039"

ESP8266WebServer server(80);
wsm::Server ws(81);             // stato e comandi del pannello su una connessione che resta aperta (ws_mini.h)
String wsChiave;                // chiave della connessione, nuova a ogni avvio (la da' /api/stato)
bool statoNuovo = false;        // arrivato un @ST da spingere alle pagine collegate
unsigned long wsStatoMs = 0;
DNSServer dns;                  // [ACCESS_POINT] portale = 1: ogni nome porta alla centralina

// ------------------------------------------------------------------ configurazione dal Mega
String cfgSsid, cfgWpwd, cfgUtente, cfgApwd, cfgHost = "presepe";   // in uso
String nSsid, nWpwd, nUtente, nApwd, nHost;                          // in arrivo (applicati a @GO)
// [WIFI] abilitato (1 rete di casa, 2 access point) e sezione [ACCESS_POINT]
String cfgModo = "1", cfgApSsid, cfgApPwd, cfgApOpt, cfgApIp;       // in uso
String nModo, nApSsid, nApPwd, nApOpt, nApIp;                        // in arrivo
bool modoAp = false, portale = false;
unsigned long staInizioMs = 0;  // abilitato = 3: inizio dei tentativi sulla rete di casa
bool staRiuscita = false;       // abilitato = 3: collegato almeno una volta (niente piu' access point)
String nomiRele[16];
bool configOk = false;          // ricevuto almeno un @GO completo
uint16_t cfgCampi = 0;          // campi ricevuti dall'ultimo @SSID (bit 0..9: SSID WPWD USER APWD HOST MODE APSSID APPWD APOPT APIP)
#define CAMPI_TUTTI 0x3FF
uint16_t idComando = 1;         // numero dei comandi non ripetibili (RUN, NEXT, COMMIT, RESTORE)
bool reteAvviata = false;       // WiFi.begin() eseguito
bool servizi = false;           // mDNS e OTA avviati (dopo la prima connessione)
unsigned long helloMs = 0;

// ------------------------------------------------------------------ stato dal Mega
long stato[22];                 // campi di "@ST" (vedi lnkInviaStato del Mega)
bool statoValido = false;
unsigned long statoMs = 0;

// ------------------------------------------------------------------ collegamento seriale
String rx;
String risposta;                // ultima riga @OK / @ERR (o @END per GET)
bool rispostaPronta = false;
bool inGet = false;
String getTesto, getNome;
String ipInviato = "";          // ultimo IP confermato dal Mega
unsigned long ipMs = 0;
bool ackVisto = false;          // "@ACK" (o "@FILE" per GET): il Mega ha ricevuto il comando e lavora

uint8_t somma(const String &s) {
  uint8_t x = 0;
  for (size_t i = 0; i < s.length(); i++) x = (uint8_t)(x + (uint8_t)s[i]);
  return x;
}

void scriviRiga(const String &l) {          // "@..." + "*HH\n"
  char h[4];
  snprintf(h, sizeof(h), "%02X", somma(l));
  Serial.print(l); Serial.print('*'); Serial.print(h); Serial.print('\n');
}

// "6 0 4 1 60" -> canale, nascosta, max client, portale, attesa (s, solo abilitato = 3)
void opzioniAp(int &canale, int &nascosta, int &maxClient, int &port, int &attesa) {
  int v[5] = { 6, 0, 4, 0, 60 }, n = 0, p = 0;
  while (n < 5 && p < (int)cfgApOpt.length()) {
    int q = cfgApOpt.indexOf(' ', p); if (q < 0) q = cfgApOpt.length();
    v[n++] = cfgApOpt.substring(p, q).toInt(); p = q + 1;
  }
  canale = (v[0] >= 1 && v[0] <= 13) ? v[0] : 6; nascosta = v[1] ? 1 : 0;
  maxClient = (v[2] >= 1 && v[2] <= 8) ? v[2] : 4; port = v[3] ? 1 : 0;
  attesa = (v[4] >= 10 && v[4] <= 600) ? v[4] : 60;
}

// Crea la rete [ACCESS_POINT] (abilitato = 2, oppure 3 quando la rete di casa non risponde).
void avviaAccessPoint() {
  IPAddress ip;
  if (!ip.fromString(cfgApIp)) ip = IPAddress(192, 168, 4, 1);
  int canale, nascosta, maxClient, port, attesa;
  opzioniAp(canale, nascosta, maxClient, port, attesa);
  WiFi.persistent(false);
  WiFi.setAutoReconnect(false);
  WiFi.disconnect();
  WiFi.mode(WIFI_AP);
  WiFi.setSleepMode(WIFI_NONE_SLEEP);
  WiFi.hostname(cfgHost);
  WiFi.softAPConfig(ip, ip, IPAddress(255, 255, 255, 0));
  WiFi.softAP(cfgApSsid.c_str(), cfgApPwd.length() ? cfgApPwd.c_str() : nullptr, canale, nascosta, maxClient);
  modoAp = true;
  if (port) { dns.setErrorReplyCode(DNSReplyCode::NoError); dns.start(53, "*", ip); portale = true; }
  servizi = false;              // mDNS e OTA ripartono sulla nuova rete
  reteAvviata = true;
}

void applicaConfig() {
  bool rete = nSsid != cfgSsid || nWpwd != cfgWpwd || nHost != cfgHost || nApwd != cfgApwd ||
              nModo != cfgModo || nApSsid != cfgApSsid || nApPwd != cfgApPwd || nApOpt != cfgApOpt || nApIp != cfgApIp;
  if (rete && reteAvviata) { delay(50); ESP.restart(); }   // cambio di rete/nome/password: ripartenza pulita
  cfgSsid = nSsid; cfgWpwd = nWpwd; cfgUtente = nUtente; cfgApwd = nApwd; cfgHost = nHost.length() ? nHost : "presepe";
  cfgModo = nModo; cfgApSsid = nApSsid; cfgApPwd = nApPwd; cfgApOpt = nApOpt; cfgApIp = nApIp;
  configOk = true;
  ipInviato = "";                                          // il Mega puo' essere ripartito: rimanda l'IP
  // 2 = access point; 3 senza SSID della rete di casa = subito access point
  if (!reteAvviata && (cfgModo == "2" || (cfgModo == "3" && !cfgSsid.length()))) avviaAccessPoint();
  if (!reteAvviata && cfgSsid.length()) {                  // 1 e 3: rete di casa
    staInizioMs = millis();
    WiFi.persistent(false);
    WiFi.mode(WIFI_STA);
    WiFi.setSleepMode(WIFI_NONE_SLEEP);   // niente risparmio energetico: risposte subito, non al beacon successivo
    WiFi.hostname(cfgHost);
    WiFi.setAutoReconnect(true);
    WiFi.begin(cfgSsid.c_str(), cfgWpwd.length() ? cfgWpwd.c_str() : nullptr);
    reteAvviata = true;
  }
}

void rigaDalMega(String l) {
  if (!l.startsWith("@")) return;                          // rumore all'avvio del Mega
  if (l.startsWith("@ST ")) {
    int n = 0, p = 4;
    while (n < 22 && p <= (int)l.length()) {
      int q = l.indexOf(' ', p); if (q < 0) q = l.length();
      stato[n++] = l.substring(p, q).toInt(); p = q + 1;
    }
    statoValido = n == 22; statoMs = millis(); statoNuovo = true;
    return;
  }
  // La configurazione arriva sempre in quest'ordine: @SSID apre un nuovo invio, @GO lo applica
  // solo se sono arrivati tutti i campi (altrimenti l'ESP continua a mandare @HELLO).
  if (l.startsWith("@SSID ") || l == "@SSID") { nSsid = l.substring(6); cfgCampi = 1; return; }
  if (l.startsWith("@WPWD ") || l == "@WPWD") { nWpwd = l.substring(6); cfgCampi |= 2; return; }
  if (l.startsWith("@USER ")) { nUtente = l.substring(6); cfgCampi |= 4; return; }
  if (l.startsWith("@APWD ")) { nApwd = l.substring(6); cfgCampi |= 8; return; }
  if (l.startsWith("@HOST ")) { nHost = l.substring(6); cfgCampi |= 16; return; }
  if (l.startsWith("@MODE ")) { nModo = l.substring(6); cfgCampi |= 32; return; }
  if (l.startsWith("@APSSID ")) { nApSsid = l.substring(8); cfgCampi |= 64; return; }
  if (l.startsWith("@APPWD ") || l == "@APPWD") { nApPwd = l.substring(7); cfgCampi |= 128; return; }
  if (l.startsWith("@APOPT ")) { nApOpt = l.substring(7); cfgCampi |= 256; return; }
  if (l.startsWith("@APIP ")) { nApIp = l.substring(6); cfgCampi |= 512; return; }
  if (l.startsWith("@NREL ")) {
    int sp = l.indexOf(' ', 6);
    int i = (sp < 0 ? l.substring(6) : l.substring(6, sp)).toInt();
    if (i >= 1 && i <= 16) nomiRele[i - 1] = sp < 0 ? "" : l.substring(sp + 1);
    return;
  }
  if (l == "@GO") {
    if (cfgCampi == CAMPI_TUTTI && nUtente.length() && nApwd.length() && ((nModo != "2" && nModo != "3") || nApSsid.length())) applicaConfig();
    cfgCampi = 0; return;
  }
  if (l == "@ACK") { ackVisto = true; return; }
  if (l.startsWith("@FILE ")) { getNome = l.substring(6); getTesto = ""; ackVisto = true; return; }
  if (l.startsWith("@L ") || l == "@L") { if (inGet) { getTesto += l.substring(3); getTesto += '\n'; } return; }
  if (l.startsWith("@C ")) { if (inGet) getTesto += l.substring(3); return; }
  if (l.startsWith("@END")) { if (inGet) { risposta = l; rispostaPronta = true; } return; }
  if (l.startsWith("@OK") || l.startsWith("@ERR")) { risposta = l; rispostaPronta = true; return; }
}

void leggiSeriale() {
  while (Serial.available()) {
    char ch = (char)Serial.read();
    if (ch == '\r') continue;
    if (ch == '\n') { String l = rx; rx = ""; rigaDalMega(l); continue; }
    if (rx.length() < 300) rx += ch;
  }
}

// Invia un comando e aspetta la risposta. Ritrasmette se la riga non arriva al Mega
// (puo' perdere caratteri mentre aggiorna le WS2811). Ritorna "" se nessuna risposta.
// lavoroMs: dopo "@ACK" (comando ricevuto, lavoro sulla SD in corso) aspetta fino a
// lavoroMs la risposta finale senza ritrasmettere.
String comando(const String &c, unsigned long attesaMs = 600, uint8_t tentativi = 4, unsigned long lavoroMs = 0) {
  for (uint8_t t = 0; t < tentativi; t++) {
    leggiSeriale();
    rispostaPronta = false; risposta = ""; ackVisto = false;
    // Un '\n' da solo prima della riga: il Mega lo tiene nel registro della UART anche se sta
    // aggiornando le WS2811 a interrupt spenti, e appena lo legge smette di aggiornarle
    // per 150 ms (lnkQuiet), cosi' la riga vera arriva intera.
    Serial.print('\n');
    delay(8);
    scriviRiga("@" + c);
    unsigned long t0 = millis();
    bool lavoro = false;
    while (millis() - t0 < (lavoro ? lavoroMs : attesaMs)) {
      leggiSeriale();
      if (rispostaPronta) return risposta;
      // Anche mentre aspetta il Mega (fino a ~20 s per un salvataggio) l'ESP risponde all'invito
      // dell'IDE per l'aggiornamento via WiFi: senza, l'IDE dice "No response from device".
      if (servizi) ArduinoOTA.handle();
      if (ackVisto && lavoroMs && !lavoro) { lavoro = true; t0 = millis(); }
      delay(1);
    }
    if (lavoro) return "";        // il Mega ha ricevuto ma non ha finito: non ripetere
  }
  return "";
}
String nuovoId() { if (++idComando == 0) idComando = 1; return String(idComando); }

// Indirizzo della centralina: quello dell'access point, o quello avuto dalla rete di casa.
// Solo un indirizzo vero (a.b.c.d) o "none": IPAddress::toString() di un indirizzo non ancora
// assegnato da' "(IP unset)", che il Mega mostrerebbe sul display come "IP: (IP".
String ipValido(const String &s) {
  IPAddress a;
  return (a.fromString(s) && s != "0.0.0.0") ? s : String("none");
}
String indirizzo() {
  if (modoAp) return ipValido(WiFi.softAPIP().toString());
  return WiFi.status() == WL_CONNECTED ? ipValido(WiFi.localIP().toString()) : String("none");
}

// ------------------------------------------------------------------ pagine
bool autorizzato() {
  if (!configOk || !cfgApwd.length()) {
    server.send(503, "text/plain; charset=utf-8",
                "Il presepe non ha ancora inviato la configurazione: [WIFI] abilitato = 1, 2 o 3 nel PRESEPE.INI, "
                "DIP 1 e 2 su ON, selettore su RXD3/TXD3.");
    return false;
  }
  if (!server.authenticate(cfgUtente.c_str(), cfgApwd.c_str())) {
    server.requestAuthentication(BASIC_AUTH, "Presepe");
    return false;
  }
  return true;
}

// Corpo lungo (pagine, file INI). Il server del core 3.1.2 invia il corpo con Stream::sendSize,
// che si ferma se per getTimeout() del flusso sorgente non riesce a scrivere niente: per
// StreamConstPtr sono 1000 ms. Basta un pacchetto perso (TCP lo ritrasmette dopo ~1 s, poi
// 2 s...) e la risposta resta a meta': il browser riceve meno byte di Content-Length
// (ERR_CONTENT_LENGTH_MISMATCH) e lo script della pagina non parte. Con piu' di ~8 kB
// (/config, il file INI) succede quasi sempre su una rete appena disturbata. Qui la sorgente
// ha 20 s: l'invio aspetta le ritrasmissioni invece di chiudere.
// Poi aspetta che il browser abbia confermato di aver ricevuto tutto (ACK TCP) prima di
// tornare al server: se nel frattempo arriva un'altra richiesta (la pagina chiede lo stato
// ogni secondo) il server chiude subito questa connessione, e una chiusura con dati ancora
// da confermare puo' finire in un reset (tcp_abort): risposta tagliata, stesso errore
// ERR_CONTENT_LENGTH_MISMATCH. Visto su /api/ini (il file INI, ~16 kB).
void inviaCorpo(int codice, const char *tipo, const char *dati, size_t len) {
  StreamConstPtr sorgente(dati, len);
  sorgente.setTimeout(20000);
  server.send(codice, tipo, &sorgente, len);
  server.client().flush(10000);           // fino a 10 s per gli ACK
}

// Pagine (gzip in flash). Ogni pagina ha un ETag legato alla compilazione: il browser
// rivalida (no-cache) e, se ha gia' la pagina di questo firmware, riceve solo un 304 senza corpo.
void inviaPagina(const uint8_t *dati, size_t len) {
  char etag[48];
  snprintf(etag, sizeof(etag), "\"%s %s %u\"", __DATE__, __TIME__, (unsigned)len);
  server.sendHeader("Cache-Control", "no-cache");
  server.sendHeader("ETag", etag);
  if (server.header("If-None-Match") == String(etag)) { server.send(304, "text/plain", ""); return; }
  server.sendHeader("Content-Encoding", "gzip");
  inviaCorpo(200, "text/html; charset=utf-8", (const char *)dati, len);
}

String jsonTesto(const String &s) {
  String o = "\"";
  for (size_t i = 0; i < s.length(); i++) {
    char ch = s[i];
    if (ch == '"' || ch == '\\') { o += '\\'; o += ch; }
    else if ((uint8_t)ch < 32) { char b[8]; snprintf(b, sizeof(b), "\\u%04x", (uint8_t)ch); o += b; }
    else o += ch;
  }
  return o + "\"";
}

void rispostaJson(bool ok, const String &campo, const String &valore, int codice = 200) {
  String j = String("{\"ok\":") + (ok ? "true" : "false") + ",\"" + campo + "\":" + jsonTesto(valore) + "}";
  server.send(codice, "application/json", j);
}

// "@ERR motivo" -> testo per la pagina
String motivo(const String &r) {
  if (!r.length()) return "il presepe non risponde";
  if (r.startsWith("@ERR ")) {
    String m = r.substring(5);
    if (m == "sd") return "microSD assente o non scrivibile";
    if (m == "modo colore") return "sulla scheda e' attiva la modalita' colore";
    if (m == "test") return "comando non disponibile durante il test";
    if (m == "stop") return "presepe in STOP: premi Play";
    if (m == "lunghezza") return "trasferimento incompleto, riprova";
    if (m == "nessun backup") return "non c'e' una copia precedente (PRESEPE.BAK)";
    if (m == "vuoto") return "file vuoto, non salvato";
    if (m == "copia") return "scrittura sulla microSD non riuscita (rimesso il file precedente)";
    if (m == "backup") return "copia di sicurezza PRESEPE.BAK non riuscita, file non salvato";
    if (m == "put") return "salvataggio interrotto, riprova";
    return m;
  }
  return r;
}

// Stato in JSON per /api/stato e per le pagine collegate con il WebSocket (senza i nomi dei
// rele', che non cambiano: la pagina li ha gia' dal primo /api/stato).
String statoJson(bool completo) {
  bool mega = statoValido && millis() - statoMs < 3000;
  String j = "{";
  j += "\"versione\":\"" VERSIONE "\"";
  j += ",\"build\":\"" __DATE__ " " __TIME__ "\"";   // quando e' stato compilato il firmware ESP caricato
  j += ",\"ip\":" + jsonTesto(indirizzo());
  j += ",\"ssid\":" + jsonTesto(modoAp ? cfgApSsid : cfgSsid);
  j += ",\"ap\":" + String(modoAp ? "true" : "false");
  j += ",\"clienti\":" + String(modoAp ? WiFi.softAPgetStationNum() : 0);
  j += ",\"host\":" + jsonTesto(cfgHost);
  j += ",\"rssi\":" + String(WiFi.RSSI());
  j += ",\"mega\":" + String(mega ? "true" : "false");
  j += ",\"eta\":" + String(statoValido ? millis() - statoMs : 999999UL);
  const long *s = stato;
  j += ",\"modo\":" + String(s[0]) + ",\"run\":" + String(s[1]) + ",\"fase\":" + String(s[2]);
  j += ",\"pctFase\":" + String(s[3]) + ",\"pct\":" + String(s[4] / 10.0, 1) + ",\"durata\":" + String(s[5]);
  j += ",\"sd\":" + String(s[6]) + ",\"err\":" + String(s[7]) + ",\"riga\":" + String(s[8]);
  j += ",\"ns1\":" + String(s[9]) + ",\"ns2\":" + String(s[10]) + ",\"rele\":" + String(s[11]);   // pixel di STELLE_01 e STELLE_02
  j += ",\"cielo\":[" + String(s[12]) + "," + String(s[13]) + "," + String(s[14]) + "]";
  j += ",\"tramonto\":[" + String(s[15]) + "," + String(s[16]) + "," + String(s[17]) + "]";
  j += ",\"alba\":[" + String(s[18]) + "," + String(s[19]) + "," + String(s[20]) + "]";
  j += ",\"passo\":" + String(s[21]);
  // diagnostica dell'ESP: memoria libera, blocco piu' grande, secondi dall'avvio, motivo dell'ultimo riavvio
  j += ",\"esp\":{\"heap\":" + String(ESP.getFreeHeap()) + ",\"blocco\":" + String(ESP.getMaxFreeBlockSize()) +
       ",\"avvio\":" + String(millis() / 1000) + ",\"reset\":" + jsonTesto(ESP.getResetReason()) + "}";
  if (completo) {
    j += ",\"ws\":{\"porta\":81,\"chiave\":\"" + wsChiave + "\"}";
    j += ",\"nomi\":[";
    for (int i = 0; i < 16; i++) { if (i) j += ","; j += jsonTesto(nomiRele[i]); }
    j += "]";
  }
  return j + "}";
}

void apiStato() {
  if (!autorizzato()) return;
  server.sendHeader("Cache-Control", "no-store");
  server.send(200, "application/json", statoJson(true));
}

// Comandi ammessi dalla pagina (il Mega controlla comunque gli argomenti).
bool comandoAmmesso(const String &c) {
  if (c.length() == 0 || c.length() > 40) return false;
  for (size_t i = 0; i < c.length(); i++) {
    char ch = c[i];
    if (!((ch >= 'A' && ch <= 'Z') || (ch >= '0' && ch <= '9') || ch == ' ')) return false;
  }
  int sp = c.indexOf(' ');
  String cmd = sp < 0 ? c : c.substring(0, sp);
  const char *ok[] = { "T", "X", "S", "P", "PA", "PC", "R", "B", "RUN", "NEXT", "STOP", "PLAY" };
  for (const char *k : ok) if (cmd == k) return true;
  return false;
}

// Le richieste che cambiano qualcosa devono avere l'intestazione X-Presepe (la mettono le
// pagine del presepe): un'altra pagina aperta nello stesso browser non puo' aggiungerla senza
// un permesso CORS che l'ESP non da', quindi non puo' usare le credenziali salvate.
bool daPagina() {
  if (server.header("X-Presepe") == "1") return true;
  server.send(403, "text/plain; charset=utf-8", "richiesta non valida");
  return false;
}

// Comando della pagina (POST /api/cmd o WebSocket): "" se eseguito, altrimenti il motivo.
String eseguiComando(String c) {
  c.trim();
  if (!comandoAmmesso(c)) return "comando non valido";
  if (c == "RUN" || c == "NEXT" || c == "STOP" || c == "PLAY") c += " " + nuovoId();   // numerati
  String r = comando(c);
  return r.startsWith("@OK") ? String("") : motivo(r);
}

void apiComando() {
  if (!autorizzato() || !daPagina()) return;
  String m = eseguiComando(server.arg("plain"));
  rispostaJson(!m.length(), "msg", m, m == "comando non valido" ? 400 : 200);
}

// Messaggi delle pagine collegate con il WebSocket (formato in ws_mini.h)
void daWebSocket(wsm::Cliente &x, const String &t) {
  if (t.startsWith("p ")) { ws.invia(x, "q " + t.substring(2)); return; }
  if (t.startsWith("c ")) {
    int sp = t.indexOf(' ', 2);
    if (sp < 0) return;
    String id = t.substring(2, sp), m = eseguiComando(t.substring(sp + 1));
    ws.invia(x, "r " + id + (m.length() ? " 0 " + m : String(" 1")));
  }
}

// Firma del file sulla microSD: "nome:crc:byte" (il Mega la calcola con @SUM e la manda alla
// fine di @GET). La pagina tiene una copia del file e manda la sua firma in X-Firma: se il file
// non e' cambiato risponde X-Invariato senza corpo, e i ~16 kB non passano di nuovo dal WiFi
// (con un segnale debole sono quasi 5 s). Con un Mega di prima (senza @SUM) si legge sempre tutto.
String firmaMega() {             // "" se il Mega non sa rispondere
  String r = comando("SUM", 1500, 3);
  if (!r.startsWith("@OK SUM ")) return "";
  r = r.substring(8);
  int a = r.indexOf(' '), b = r.lastIndexOf(' ');
  if (a <= 0 || b <= a) return "";
  return r.substring(0, a) + ":" + r.substring(a + 1, b) + ":" + r.substring(b + 1);
}

void apiLeggiFile() {
  if (!autorizzato()) return;
  String nota = server.header("X-Firma");
  if (nota.length()) {
    unsigned long t0 = millis();
    String firma = firmaMega();
    if (firma.length() && firma == nota) {
      server.sendHeader("X-Invariato", "1");
      server.sendHeader("X-Firma", firma);
      server.sendHeader("X-File", firma.substring(0, firma.indexOf(':')));
      server.sendHeader("X-Tempo", String(millis() - t0));
      server.sendHeader("Cache-Control", "no-store");
      server.send(200, "text/plain; charset=utf-8", "");
      return;
    }
  }
  inGet = true; getTesto = ""; getNome = "";
  getTesto.reserve(17000);                  // il file di esempio e' ~16.5 kB: una sola allocazione
  unsigned long t0 = millis();
  String r = comando("GET", 1500, 4, 15000);
  unsigned long tempo = millis() - t0;      // lettura dalla microSD del Mega + seriale
  inGet = false;
  if (!r.startsWith("@END")) {
    server.send(503, "text/plain; charset=utf-8", motivo(r));
    getTesto = ""; return;
  }
  server.sendHeader("X-File", getNome);
  {                                          // "@END righe crc byte" -> firma (Mega di prima: niente)
    int a = r.indexOf(' ', 5), b = r.lastIndexOf(' ');
    if (a > 0 && b > a) server.sendHeader("X-Firma", getNome + ":" + r.substring(a + 1, b) + ":" + r.substring(b + 1));
  }
  server.sendHeader("X-Tempo", String(tempo));   // la pagina mostra quanto e' scheda e quanto e' rete
  server.sendHeader("Access-Control-Expose-Headers", "X-File");
  server.sendHeader("Cache-Control", "no-store");
  // Compresso (gzip) se il browser lo accetta: 16 kB diventano ~6 kB e sul WiFi conta. Il browser
  // lo decomprime da solo. Con l'INI in memoria all'ESP restano ~15 kB: il compressore ne usa al
  // massimo ~9 e il risultato esce a pezzi direttamente sulla rete, senza tenerlo tutto in RAM.
  // Se manca memoria parte com'e', e X-Compresso: memoria lo dice alla pagina.
  size_t n = getTesto.length();
  if (n > 512 && server.header("Accept-Encoding").indexOf("gzip") >= 0) {
    Gzip z;
    if (ESP.getFreeHeap() > 13000 && z.prepara((const uint8_t *)getTesto.c_str(), n)) {
      size_t zn = z.dimensione();
      server.sendHeader("Content-Encoding", "gzip");
      server.sendHeader("X-Byte", String(n));   // la pagina mostra quanto ha viaggiato sulla rete
      server.sendHeader("X-Compresso", String(zn));
      server.setContentLength(zn);
      server.send(200, "text/plain; charset=utf-8", "");
      // ogni pezzo come inviaCorpo: sorgente con 20 s di pazienza (sendContent(p, n) del core ne
      // da' 1 e con un segnale debole tronca la risposta)
      z.scrivi([](void *, const uint8_t *p, size_t k) -> bool {
        StreamConstPtr pezzo((const char *)p, k); pezzo.setTimeout(20000);
        server.sendContent(&pezzo, k);
        return server.client().connected();
      }, nullptr);
      server.client().flush(10000);             // come inviaCorpo: aspetta le conferme prima di chiudere
      getTesto = "";
      return;
    }
    server.sendHeader("X-Compresso", "memoria");
  }
  inviaCorpo(200, "text/plain; charset=utf-8", getTesto.c_str(), getTesto.length());
  getTesto = "";
}

// Salva il testo sulla microSD: PUT, righe a pezzi da 100 caratteri, COMMIT.
// La pagina manda il file in parti di righe intere (~2 kB, intestazione X-Parte "k/n"): il
// server dell'ESP tiene in memoria tutto il corpo di una richiesta, e un file intero (16 kB,
// piu' la sua copia nell'argomento "plain") non trova piu' spazio: il testo arrivava vuoto
// ("file vuoto, non salvato"). Senza X-Parte il corpo e' il file intero, come prima.
// PUT alla prima parte, COMMIT dopo l'ultima; parti fuori ordine o in ritardo annullano tutto
// (ABORT) e sulla microSD resta il file di prima.
bool salvIn = false;            // salvataggio a parti in corso
uint16_t salvSeq = 0, salvParte = 0, salvParti = 0;
uint32_t salvByte = 0;
unsigned long salvMs = 0;
void salvAnnulla() { if (salvIn) comando("ABORT", 3000, 2); salvIn = false; }

void apiScriviFile() {
  if (!autorizzato() || !daPagina()) return;
  const String &t = server.arg("plain");      // nessuna copia: la parte puo' essere lunga
  int k = 1, n = 1;
  String xp = server.header("X-Parte");
  if (xp.length()) {
    int s = xp.indexOf('/');
    k = s > 0 ? xp.substring(0, s).toInt() : 0; n = s > 0 ? xp.substring(s + 1).toInt() : 0;
    if (k < 1 || n < 1 || k > n || n > 64) { rispostaJson(false, "msg", "richiesta non valida", 400); return; }
  }
  // X-Len = byte inviati dalla pagina: se la memoria e' finita il testo arriva vuoto o tagliato
  if ((!t.length() && n == 1) || String(t.length()) != server.header("X-Len")) {
    salvAnnulla();
    rispostaJson(false, "msg", t.length() || n > 1 ? "file arrivato incompleto, riprova" : "file vuoto, non salvato", 400); return;
  }
  if (t.length() > 24000) { salvAnnulla(); rispostaJson(false, "msg", "file troppo lungo (massimo 24000 caratteri)", 413); return; }
  String r;
  if (k == 1) {
    salvAnnulla();                           // un salvataggio lasciato a meta' non si mescola a questo
    r = comando("PUT", 3000, 3);
    if (!r.startsWith("@OK")) { rispostaJson(false, "msg", motivo(r), 503); return; }
    salvIn = true; salvSeq = 0; salvByte = 0; salvParti = n;
  } else if (!salvIn || k != salvParte + 1 || n != salvParti || millis() - salvMs > 20000UL) {
    salvAnnulla(); rispostaJson(false, "msg", "salvataggio interrotto, riprova", 409); return;
  }
  salvParte = k; salvMs = millis();
  size_t i = 0, lun = t.length();
  while (i < lun) {
    int fine = t.indexOf('\n', i);
    size_t fineRiga = fine < 0 ? lun : (size_t)fine;
    // pezzi da 100: tutti "C" tranne l'ultimo della riga, che e' "W" (aggiunge il ritorno a capo)
    size_t p = i;
    do {
      size_t q = fineRiga - p > 100 ? p + 100 : fineRiga;
      bool ultimo = q == fineRiga;
      String pezzo = t.substring(p, q);
      pezzo.replace("\r", "");
      String cmd = String(ultimo ? "W " : "C ") + String(salvSeq) + " " + pezzo;
      r = comando(cmd, 1500, 4);
      if (!r.startsWith("@OK")) { salvAnnulla(); rispostaJson(false, "msg", motivo(r), 503); return; }
      salvSeq++; salvByte += pezzo.length() + (ultimo ? 1 : 0);
      p = q;
    } while (p < fineRiga);
    i = fineRiga + 1;
    if (fine < 0) break;
  }
  salvMs = millis();
  if (k < n) { rispostaJson(true, "parte", String(k)); return; }
  salvIn = false;
  r = comando("COMMIT " + String(salvByte) + " " + nuovoId(), 1500, 4, 20000);
  if (!r.startsWith("@OK")) { rispostaJson(false, "msg", motivo(r), 503); return; }
  String nome = r.length() > 4 ? r.substring(4) : String("PRESEPE.INI");
  // firma del file appena scritto: la pagina aggiorna la sua copia e la prossima apertura
  // non lo riscarica ("" con un Mega di prima)
  server.send(200, "application/json", "{\"ok\":true,\"file\":" + jsonTesto(nome) + ",\"firma\":" + jsonTesto(firmaMega()) + "}");
}

void apiRiavvia() {
  if (!autorizzato() || !daPagina()) return;
  String r = comando("REBOOT", 800, 4);
  bool ok = r.startsWith("@OK");
  if (ok) statoValido = false;
  rispostaJson(ok, "msg", ok ? String("") : motivo(r));
}

void apiRipristina() {
  if (!autorizzato() || !daPagina()) return;
  String r = comando("RESTORE " + nuovoId(), 1500, 4, 20000);
  if (!r.startsWith("@OK")) { rispostaJson(false, "msg", motivo(r), 503); return; }
  rispostaJson(true, "file", r.length() > 4 ? r.substring(4) : String("PRESEPE.INI"));
}

void setup() {
  Serial.setRxBufferSize(2048);
  Serial.begin(115200);
  Serial.setDebugOutput(false);
  WiFi.persistent(false);
  WiFi.mode(WIFI_STA);
  WiFi.disconnect();            // nessuna rete ricordata: si collega solo con i dati del Mega
  idComando = (uint16_t)(ESP.random() | 1);   // diverso a ogni avvio dell'ESP
  char k[17]; snprintf(k, sizeof(k), "%08lx%08lx", (unsigned long)ESP.random(), (unsigned long)ESP.random());
  wsChiave = k; ws.chiave(wsChiave);
  server.collectHeaders("X-Presepe", "X-Len", "X-Parte", "If-None-Match", "X-Firma", "Accept-Encoding");   // lette da daPagina(), apiScriviFile(), inviaPagina()

  server.on("/", HTTP_GET, []() { if (autorizzato()) inviaPagina(PAGINA_PANNELLO, PAGINA_PANNELLO_LEN); });
  server.on("/config", HTTP_GET, []() { if (autorizzato()) inviaPagina(PAGINA_CONFIG, PAGINA_CONFIG_LEN); });
  server.on("/favicon.ico", HTTP_GET, []() { server.send(204, "image/x-icon", ""); });   // le pagine hanno l'icona inline
  server.on("/api/stato", HTTP_GET, apiStato);
  server.on("/api/cmd", HTTP_POST, apiComando);
  server.on("/api/ini", HTTP_GET, apiLeggiFile);
  server.on("/api/ini", HTTP_POST, apiScriviFile);
  server.on("/api/riavvia", HTTP_POST, apiRiavvia);
  server.on("/api/ripristina", HTTP_POST, apiRipristina);
  server.onNotFound([]() {
    // portale: le pagine di prova dei telefoni (e ogni altro indirizzo) portano al pannello
    if (portale) { server.sendHeader("Location", "http://" + indirizzo() + "/"); server.send(302, "text/plain", ""); return; }
    server.send(404, "text/plain", "non trovato");
  });
  server.begin();
  ws.begin();
}

void loop() {
  leggiSeriale();

  // Finche' il Mega non manda la configurazione, chiedila ogni 2 s.
  if (!configOk && millis() - helloMs >= 2000) { helloMs = millis(); scriviRiga("@HELLO"); }

  bool collegato = modoAp || WiFi.status() == WL_CONNECTED;
  // abilitato = 3: se la rete di casa non si collega entro "attesa" secondi, access point
  // (fino al prossimo riavvio). Una volta collegata, resta sulla rete di casa.
  if (cfgModo == "3" && !modoAp && reteAvviata) {
    if (collegato) staRiuscita = true;
    int c, h, m, po, attesa; opzioniAp(c, h, m, po, attesa);
    if (!staRiuscita && millis() - staInizioMs > (unsigned long)attesa * 1000UL) { avviaAccessPoint(); collegato = true; }
  }
  if (portale) dns.processNextRequest();
  if (collegato && !servizi) {
    MDNS.begin(cfgHost.c_str());
    MDNS.addService("http", "tcp", 80);
    ArduinoOTA.setHostname(cfgHost.c_str());
    ArduinoOTA.setPassword(cfgApwd.c_str());
    ArduinoOTA.begin();
    servizi = true;
  }
  if (servizi) { MDNS.update(); ArduinoOTA.handle(); }

  // Indirizzo al Mega: a ogni cambio, e comunque ogni 5 minuti (il Mega che riparte rimanda la
  // configurazione e l'IP riparte da capo, vedi applicaConfig). Ogni invio blocca l'ESP finche' il
  // Mega non risponde: non serve ripeterlo spesso.
  if (configOk) {
    String ip = indirizzo();
    if (modoAp) ip += " AP";                              // il Mega mostra "access point" sul display
    if ((ip != ipInviato && millis() - ipMs > 3000) || millis() - ipMs > 300000UL) {
      ipMs = millis();
      if (comando("IP " + ip, 600, 2).startsWith("@OK")) ipInviato = ip;
    }
  }

  server.handleClient();

  // pagine collegate con il WebSocket: messaggi, e lo stato appena arriva dal Mega (o ogni 1,5 s
  // se il Mega tace, cosi' la pagina vede "il presepe non risponde")
  ws.loop(daWebSocket);
  if (ws.clienti() && (statoNuovo || millis() - wsStatoMs > 1500)) {
    statoNuovo = false; wsStatoMs = millis();
    ws.inviaTutti("s " + statoJson(false));
  }
}
