zanac/PSN-Presepe-2026/firmware/tools/test_config.cpp

// Host-side tests for the PRESEPE.INI reader (no Arduino needed).
// Run with firmware/tools/run_tests.sh: it extracts the CONFIG BEGIN/END block of
// PSN-Presepe.ino into a temporary PresepeConfig.h and compiles this file with it.
#include "PresepeConfig.h"
#include <cstdio>
#include <cstring>
#include <cmath>
#include <string>
#include <fstream>
#include <sstream>

static int fails = 0, checks = 0;
#define CHECK(c) do { checks++; if (!(c)) { fails++; std::printf("FAIL %s:%d  %s\n", __FILE__, __LINE__, #c); } } while (0)

static bool sameScenography(const PresepeConfig &a, const PresepeConfig &b) {
  PresepeConfig x = a, y = b;   // ignore read-status bookkeeping
  x.sdStato = y.sdStato = 0; x.righeLette = y.righeLette = 0; x.errori = y.errori = 0;
  x.primaRigaErrata = y.primaRigaErrata = 0; x.eventiDaFile = y.eventiDaFile = 0;
  // WiFi on and constellations live only in the file (the shipped one has abilitato = 3 with
  // its network and the Cometa; the defaults keep WiFi off and have no constellation)
  x.wifiAbilitato = y.wifiAbilitato = 0;
  std::memset(x.wifiSsid, 0, sizeof(x.wifiSsid)); std::memset(y.wifiSsid, 0, sizeof(y.wifiSsid));
  std::memset(x.wifiPassword, 0, sizeof(x.wifiPassword)); std::memset(y.wifiPassword, 0, sizeof(y.wifiPassword));
  // constellations live only in the file (the shipped one has the Cometa; the defaults have none)
  x.numCostellazioni = y.numCostellazioni = 0;
  std::memset(x.cost, 0, sizeof(x.cost)); std::memset(y.cost, 0, sizeof(y.cost));
  std::memset(x.costStella, 0, sizeof(x.costStella)); std::memset(y.costStella, 0, sizeof(y.costStella));
  for (int s = 0; s < CFG_NUM_STRISCE; s++) x.tappeDaFile[s] = y.tappeDaFile[s] = 0;
  return std::memcmp(&x, &y, sizeof(x)) == 0;
}

int main(int argc, char **argv) {
  PresepeConfig d; cfgDefault(d);

  // 1. empty text -> defaults, no errors
  { PresepeConfig c; cfgDefault(c); cfgParseBuffer(c, ""); CHECK(c.errori == 0); CHECK(sameScenography(c, d)); }

  // 2. the shipped example file equals the defaults with zero errors
  if (argc > 1) {
    std::ifstream f(argv[1]); std::stringstream ss; ss << f.rdbuf();
    PresepeConfig c; cfgDefault(c); cfgParseBuffer(c, ss.str().c_str());
    std::printf("example file: %u lines, %u errors (first %u)\n", c.righeLette, c.errori, c.primaRigaErrata);
    CHECK(c.errori == 0); CHECK(sameScenography(c, d)); CHECK(c.eventiDaFile == 1); CHECK(c.numEventi == 2);
    // bit = phase: CIELO in GIORNO, TRAMONTO, ALBA; tramonto strip in TRAMONTO; alba strip in ALBA
    CHECK(c.tappeDaFile[CFG_S_CIELO] == ((1 << CFG_GIORNO) | (1 << CFG_TRAMONTO) | (1 << CFG_ALBA)));
    CHECK(c.tappeDaFile[CFG_S_TRAMONTO] == (1 << CFG_TRAMONTO) && c.tappeDaFile[CFG_S_ALBA] == (1 << CFG_ALBA));
    // the two commented-out constellation examples are valid once uncommented
    std::string t = ss.str(), u; std::istringstream in(t); std::string l; bool dentro = false;
    while (std::getline(in, l)) {
      if (l.rfind("; [COSTELLAZIONE]", 0) == 0) dentro = true;
      else if (!l.empty() && l[0] == '[') dentro = false;
      u += (dentro && l.rfind("; ", 0) == 0 && (l[2] == '[' || l.find('=') != std::string::npos) ? l.substr(2) : l) + "\n";
    }
    PresepeConfig e; cfgDefault(e); cfgParseBuffer(e, u.c_str());
    CHECK(e.errori == 0 && e.numCostellazioni == 2 && e.cost[0].n == 7 && e.cost[0].modo == COST_UNA_ALLA_VOLTA &&
          e.cost[1].n == 11 && e.cost[1].haColore && e.cost[1].modo == COST_SCINTILLA);
    // as shipped: the Cometa is active (11 stars of STELLE_01), up from 30 % of the dusk to the night
    CHECK(c.wifiAbilitato == 3 && std::strcmp(c.wifiSsid, "wifi_presepe") == 0 && std::strcmp(c.wifiPassword, "presepe2026") == 0);
    CHECK(c.numCostellazioni == 1 && c.cost[0].n == 11 && c.cost[0].n0 == 11 && cfgCost(c, 0, 36) == 1 && cfgCost(c, 0, 37) == 0 &&
          cfgCost(c, 0, 49) == 1 && c.cost[0].acc[0].fase == CFG_CREPUSCOLO && c.cost[0].acc[0].pct == 30 && c.cost[0].acc[1].fase == CFG_NOTTE &&
          c.cost[0].sp[0].fase == CFG_ALBA && c.cost[0].sp[1].pct == 100);
  }

  // 3. custom values, CRLF, case, names, Grp_ syntax, forcing, both star chains
  {
    const char *t =
      "[ciclo]\r\nDURATA1 = 30\r\ndurata2=120 ; two minutes\r\ndurata3 = 600\r\npot_min=10\r\npot_max = 680\r\n"
      "pot_invertito = no\r\npartenza = PAUSA\r\n"
      "[FASI]\ntramonto = 35.5\ncrepuscolo=48\nnotte=60\nalba=90\n"
      "[RELE]\nlogica = bassa\nnome1 = Mulino\nnome16 = Fontana\nforza2 = on\nforza3 = off\n"
      "[giorno]\nrele = Mulino, on, 10\n[NOTTE]\nrele = Grp_04_04, ON, 0\n[Alba]\nRELE = 16, spento, 100\n"
      "[COLORI]\nlum_alba = 50\ngamma = off\n"
      "[TRAMONTO]\ntramonto = 10, 200, 80, 20\nTRAMONTO = 60.5, 0, 0, 255, LINEARE\n"
      "[STELLE_01]\nnumero = 80\nattive = 30\ncolore = 100,100,100\n"
      "[stelle_02]\nnumero = 12\nattive = 5\nlum_min = 10\nlum_max = 40\nlivello_notte = 100\nscintillio_min = 1000\nscintillio_max = 2000\ncolore = 50,60,70\n"
      "[SISTEMA]\nbuzzer = 0\ndebug_ms = 0\nfastboot = no\n";
    PresepeConfig c; cfgDefault(c); cfgParseBuffer(c, t);
    CHECK(c.errori == 0);
    CHECK(c.durataMs[0] == 30000UL && c.durataMs[1] == 120000UL && c.durataMs[2] == 600000UL);
    CHECK(c.potMin == 10 && c.potMax == 680 && c.potInvertito == 0 && c.partenzaInPausa == 1);
    CHECK(std::fabs(c.pTramonto - 35.5f) < 1e-4 && c.pAlba == 90.0f);
    CHECK(c.releAttivoBasso == 1 && std::strcmp(c.nome[0], "Mulino") == 0 && std::strcmp(c.nome[15], "Fontana") == 0);
    CHECK(c.forza[1] == FORZA_ON && c.forza[2] == FORZA_OFF && c.forza[0] == FORZA_AUTO);
    CHECK(c.numEventi == 3 && c.eventiDaFile == 1);
    CHECK(c.eventi[0].fase == CFG_GIORNO && c.eventi[0].rele == 0 && c.eventi[0].acceso == 1 && c.eventi[0].pct == 10);
    CHECK(c.eventi[1].fase == CFG_NOTTE && c.eventi[1].rele == 15 && c.eventi[1].acceso == 1);
    CHECK(c.eventi[2].fase == CFG_ALBA && c.eventi[2].rele == 15 && c.eventi[2].acceso == 0 && c.eventi[2].pct == 100);
    CHECK(c.lumAlba == 50 && c.gamma == 0);
    CHECK(c.numTappe[CFG_S_TRAMONTO] == 2 && c.tappeDaFile[CFG_S_TRAMONTO] == (1 << CFG_TRAMONTO));
    CHECK(c.tappe[CFG_S_TRAMONTO][0].col.r == 200 && c.tappe[CFG_S_TRAMONTO][0].curva == CURVA_MORBIDA);
    CHECK(std::fabs(c.tappe[CFG_S_TRAMONTO][1].pct - 60.5f) < 1e-4 && c.tappe[CFG_S_TRAMONTO][1].curva == CURVA_LINEARE);
    CHECK(c.numTappe[CFG_S_CIELO] == d.numTappe[CFG_S_CIELO] && c.tappeDaFile[CFG_S_CIELO] == 0);   // untouched strips keep defaults
    CHECK(c.stelle[0].numero == 80 && c.stelle[0].attive == 30 && c.stelle[0].colore.g == 100 && c.stelle[0].lumMin == d.stelle[0].lumMin);
    CHECK(c.stelle[1].numero == 12 && c.stelle[1].attive == 5 && c.stelle[1].lumMin == 10 && c.stelle[1].lumMax == 40 && c.stelle[1].livelloNotte == 100);
    CHECK(c.stelle[1].scintillioMinMs == 1000 && c.stelle[1].scintillioMaxMs == 2000 && c.stelle[1].colore.r == 50 && c.stelle[1].colore.b == 70);
    CHECK(c.stelle[0].livelloNotte == d.stelle[0].livelloNotte && c.stelle[0].scintillioMinMs == d.stelle[0].scintillioMinMs);   // chains are independent
    CHECK(c.buzzer == 0 && c.debugMs == 0 && c.fastboot == 0 && d.fastboot == 1);
    CHECK(c.lumCielo == 100);   // untouched keys keep defaults
  }

  // 4. errors are counted, first bad line reported, good lines still applied
  {
    const char *t =
      "durata1 = 30\n"            // 1: key outside any section
      "[CICLO]\n"                 // 2
      "durata1 = 5\n"             // 3: below minimum (10)
      "durata2 = abc\n"           // 4: not a number
      "durata3 = 400\n"           // 5: ok
      "[NONESISTE]\n"             // 6: unknown section
      "foo = 1\n"                 // 7: no valid section active
      "[NOTTE]\n"                 // 8
      "rele = 17, ON, 5\n"         // 9: relay out of range
      "rele = Grp_05_01, ON, 5\n"  // 10: bad group
      "evento = NOTTE, 1, ON, 5\n" // 11: old key (events now are "rele" lines in the phase sections)
      "rele = 1, FORSE, 5\n"       // 12: bad state
      "rele = 1, ON\n"             // 13: missing field
      "[RELE]\n"                   // 14
      "nome1 = NomeTroppoLungo\n"  // 15: > 12 chars
      "evento = NOTTE, 1, ON, 5\n" // 16: old key, removed from [RELE]
      "[COLORI]\n"                 // 17
      "giorno_caldo = 1,2,3\n"     // 18: old key, removed (now cielo tappe in the phase sections)
      "senza uguale\n";            // 19
    PresepeConfig c; cfgDefault(c); cfgParseBuffer(c, t);
    std::printf("error case: %u errors, first line %u\n", c.errori, c.primaRigaErrata);
    CHECK(c.errori == 14); CHECK(c.primaRigaErrata == 1);
    CHECK(c.durataMs[0] == d.durataMs[0] && c.durataMs[1] == d.durataMs[1] && c.durataMs[2] == 400000UL);
    CHECK(c.numEventi == 2 && c.eventiDaFile == 0);   // no valid event -> default table kept
    CHECK(c.nome[0][0] == 0);
  }

  // 5. non-increasing phases revert all four; inconsistent ranges revert
  {
    PresepeConfig c; cfgDefault(c);
    cfgParseBuffer(c, "[FASI]\ntramonto=60\ncrepuscolo=50\n[CICLO]\npot_min=500\npot_max=510\n[STELLE_02]\nnumero=10\nattive=40\nlum_min=90\nlum_max=20\n");
    CHECK(c.pTramonto == d.pTramonto && c.pCrepuscolo == d.pCrepuscolo);
    CHECK(c.potMin == d.potMin && c.potMax == d.potMax);
    CHECK(c.stelle[1].attive == 10);                   // clamped to the pixel count
    CHECK(c.stelle[1].lumMin == d.stelle[1].lumMin && c.stelle[1].lumMax == d.stelle[1].lumMax);
    CHECK(c.stelle[0].attive == d.stelle[0].attive);   // the other chain is untouched
    CHECK(c.errori == 3 && c.primaRigaErrata == 0xFFFF);
  }

  // 5b. the old sections [STELLE] and [CASETTE] no longer exist: header and keys are errors
  {
    PresepeConfig c; cfgDefault(c);
    cfgParseBuffer(c, "[STELLE]\nnumero = 10\n[CASETTE]\nnumero = 5\nfuoco = 20\n[STELLE_01]\nnumero = 30\n");
    CHECK(c.errori == 5 && c.primaRigaErrata == 1);
    CHECK(c.stelle[0].numero == 30 && c.stelle[1].numero == d.stelle[1].numero);
  }

  // 5c. [COSTELLAZIONE] sections: stars of both chains, ranges, all-or-nothing "stelle" lines,
  //     times, colour, mode; up to 8 sections
  {
    PresepeConfig c; cfgDefault(c);
    CHECK(c.numCostellazioni == 0);
    cfgParseBuffer(c,
      "[COSTELLAZIONE]\n"                                                      // line 1
      "nome = Orsa maggiore\n"
      "stelle = 01:3, 01:7, 01:12-14, 02:5\n"
      "luminosita = 70\n"
      "accendi = CREPUSCOLO 30 - NOTTE 0\n"                                    // 5
      "spegni = ALBA, 10 - ALBA, 60\n"
      "colore = 100,90,60\n"
      "modo = una_alla_volta\n"
      "[COSTELLAZIONE]\n"
      "stelle = 2:20 - 24\n"                                                   // 10
      "stelle = 01:7, 01:30\n"                                                 // 11: 01:7 is in the first one -> line out
      "luminosita = 300\n"                                                     // 12: out of range
      "stelle = 03:1\n"                                                        // 13: no chain 03
      "stelle = 01:0\n"                                                        // 14: stars count from 1
      "stelle = 01:9-8\n"                                                      // 15: reversed range
      "stelle = \n"                                                            // 16: no stars
      "accendi = CREPUSCOLO 30\n"                                              // 17: needs from - to
      "spegni = MEZZANOTTE 1 - ALBA 2\n"                                       // 18: unknown phase
      "modo = lampeggia\n"                                                     // 19: unknown mode
      "colore = 120,0,0\n"                                                     // 20: tint over 100
      "chiave = 1\n"                                                           // 21: unknown key
      "modo = scintilla\n"
      "[COSTELLAZIONE]\n"
      "stelle = 02:50, 01:60\n"                                                // 24: 01:60 beyond numero=50
      "accendi = NOTTE 50 - NOTTE 60\n"
      "spegni = NOTTE 55 - NOTTE 58\n"                                         // goes down before it is fully up -> star times
    );
    CHECK(c.numCostellazioni == 3);
    const CfgCostellazione &a = c.cost[0], &b = c.cost[1], &d = c.cost[2];
    CHECK(a.lum == 70 && a.modo == COST_UNA_ALLA_VOLTA && a.haColore && a.colore.r == 100 && a.colore.g == 90 && a.colore.b == 60);
    CHECK(a.acc[0].fase == CFG_CREPUSCOLO && a.acc[0].pct == 30 && a.acc[1].fase == CFG_NOTTE && a.acc[1].pct == 0);
    CHECK(a.sp[0].fase == CFG_ALBA && a.sp[0].pct == 10 && a.sp[1].fase == CFG_ALBA && a.sp[1].pct == 60);
    CHECK(a.n0 == 5 && a.n == 6);
    CHECK(cfgCost(c, 0, 2) == 1 && cfgCost(c, 0, 6) == 1 && cfgCost(c, 0, 11) == 1 && cfgCost(c, 0, 13) == 1 && cfgCost(c, 1, 4) == 1);
    CHECK(cfgCost(c, 0, 14) == 0 && cfgCost(c, 0, 29) == 0 && cfgCost(c, 0, 3) == 0);
    CHECK(b.lum == 80 && b.modo == COST_SCINTILLA && !b.haColore && b.n0 == 0 && b.n == 5);
    CHECK(b.acc[0].fase == CFG_CREPUSCOLO && b.acc[0].pct == 0 && b.acc[1].fase == CFG_NOTTE && b.sp[0].fase == CFG_ALBA && b.sp[1].pct == 100);
    CHECK(cfgCost(c, 1, 19) == 2 && cfgCost(c, 1, 23) == 2 && cfgCost(c, 1, 24) == 0);
    CHECK(cfgCost(c, 1, 49) == 3 && cfgCost(c, 0, 59) == 0 && d.n == 1);    // 01:60 dropped by the final check
    CHECK(d.acc[0].fase == CFG_CREPUSCOLO && d.acc[1].fase == CFG_NOTTE && d.acc[1].pct == 0 && d.sp[0].fase == CFG_ALBA);
    CHECK(c.errori == 13 && c.primaRigaErrata == 11);           // lines 11..21, plus 01:60, plus the order of times
    // capacity: 8 sections; the 9th header and its lines are errors
    PresepeConfig e; cfgDefault(e);
    std::string t;
    for (int i = 1; i <= 9; i++) t += "[COSTELLAZIONE]\nstelle = 01:" + std::to_string(i) + "\n";
    cfgParseBuffer(e, t.c_str());
    CHECK(e.numCostellazioni == 8 && e.errori == 2 && cfgCost(e, 0, 8) == 0 && cfgCost(e, 0, 7) == 8);
    // the old one-line section is not read any more
    PresepeConfig o; cfgDefault(o);
    cfgParseBuffer(o, "[COSTELLAZIONI]\ncostellazione = 70 | 01:3\n");
    CHECK(o.numCostellazioni == 0 && o.errori == 2);
  }

  // 6. event table capacity (64) and over-long line
  {
    std::string t = "[NOTTE]\n";
    for (int i = 0; i < 70; i++) t += "rele = 1, ON, 1\n";
    t += std::string(200, 'x') + "\n";
    PresepeConfig c; cfgDefault(c); cfgParseBuffer(c, t.c_str());
    CHECK(c.numEventi == CFG_MAX_EVENTI); CHECK(c.errori == 7);
  }

  // 7. colour tappe in the phase sections: interpolation, step, wrap-around, linear curve,
  //    per-phase replacement of the defaults, any order, errors
  {
    PresepeConfig c; cfgDefault(c);
    cfgParseBuffer(c,
      "[ALBA]\n"
      "cielo = 100, 0, 0, 0\n"                  // replaces the default ALBA tappe of the sky
      "alba = 50, 100, 0, 0\n"                  // only alba tappa: fixed colour all cycle
      "[TRAMONTO]\n"                             // sections in any order
      "cielo = 0, 200, 100, 0\n"
      "cielo = 0, 10, 10, 10\n"                 // same point: step, file order kept
      "cielo = 100, 1, 1, 1, veloce\n"          // ERROR: unknown curve
      "cielo = 120, 1, 1, 1\n"                  // ERROR: % > 100
      "cielo = 50, 1, 1\n"                      // ERROR: missing blue
      "cielo = 50, 1, 1, 1, lineare, x\n"       // ERROR: too many fields
      "colore = 1, 2, 3\n"                      // ERROR: unknown key
      "tappa = TRAMONTO, 0, 1, 1, 1\n"          // ERROR: old syntax
      "[GIORNO]\n"
      "cielo = 50, 200, 100, 0, lineare\n"      // written before the 0 % tappa: sorted anyway
      "cielo = 0, 0, 0, 0\n");
    CHECK(c.errori == 6); CHECK(c.numTappe[CFG_S_CIELO] == 5); CHECK(c.numTappe[CFG_S_ALBA] == 1);
    CHECK(c.tappe[CFG_S_CIELO][0].fase == CFG_GIORNO && c.tappe[CFG_S_CIELO][0].pct == 0.0f);
    CHECK(c.tappe[CFG_S_CIELO][1].pct == 50.0f && c.tappe[CFG_S_CIELO][4].fase == CFG_ALBA);
    CHECK(c.tappe[CFG_S_CIELO][2].col.r == 200 && c.tappe[CFG_S_CIELO][3].col.r == 10);
    // GIORNO = 0..40 % of the cycle: at 10 % (= 25 % of GIORNO, half way to the 50 % tappa) linear gives 100
    CfgRGB a = cfgColoreTappe(c, CFG_S_CIELO, 10.0f);
    CHECK(a.r == 100 && a.g == 50 && a.b == 0);
    CfgRGB b = cfgColoreTappe(c, CFG_S_CIELO, 30.0f);             // between 50 % GIORNO and TRAMONTO 0: constant
    CHECK(b.r == 200 && b.g == 100);
    CfgRGB s1 = cfgColoreTappe(c, CFG_S_CIELO, 40.0f);            // exactly at the step: the later tappa wins
    CHECK(s1.r == 10 && s1.g == 10 && s1.b == 10);
    CfgRGB w = cfgColoreTappe(c, CFG_S_CIELO, 70.0f);             // TRAMONTO 0 (40 %) -> ALBA 100 (100 %): x = 0.5
    CHECK(w.r == 5 && w.g == 5 && w.b == 5);
    CfgRGB z = cfgColoreTappe(c, CFG_S_CIELO, 0.0f);
    CHECK(z.r == 0 && z.g == 0 && z.b == 0);
    CfgRGB f1 = cfgColoreTappe(c, CFG_S_ALBA, 3.0f), f2 = cfgColoreTappe(c, CFG_S_ALBA, 95.0f);
    CHECK(f1.r == 100 && f2.r == 100 && f1.g == 0);
    CfgRGB t0 = cfgColoreTappe(c, CFG_S_TRAMONTO, 45.0f), td = cfgColoreTappe(d, CFG_S_TRAMONTO, 45.0f);
    CHECK(t0.r == td.r && t0.g == td.g && t0.b == td.b);           // tramonto strip not in the file: defaults
    // only one phase rewritten: the other phases keep their default tappe
    PresepeConfig e; cfgDefault(e);
    cfgParseBuffer(e, "[TRAMONTO]\ncielo = 0, 1, 2, 3\n");
    CHECK(e.errori == 0 && e.numTappe[CFG_S_CIELO] == d.numTappe[CFG_S_CIELO] - 4 + 1);
    CfgRGB noon = cfgColoreTappe(e, CFG_S_CIELO, 20.0f);           // GIORNO 50 %: default white plateau
    CHECK(noon.r == 255 && noon.g == 255 && noon.b == 255);
    // too many tappe: the 21st is an error
    std::string t = "[TRAMONTO]\n";
    for (int i = 0; i <= CFG_MAX_TAPPE; i++) t += "tramonto = " + std::to_string(i) + ", 1, 2, 3\n";
    PresepeConfig g; cfgDefault(g); cfgParseBuffer(g, t.c_str());
    CHECK(g.numTappe[CFG_S_TRAMONTO] == CFG_MAX_TAPPE && g.errori == 1);
  }
  // 8. default tappe: the historical key colours are where they used to be
  {
    CfgRGB g = cfgColoreTappe(d, CFG_S_CIELO, 0.0f), wh = cfgColoreTappe(d, CFG_S_CIELO, 40.0f * 0.50f);
    CHECK(g.r == 210 && g.g == 82 && g.b == 18); CHECK(wh.r == 255 && wh.g == 255 && wh.b == 255);   // noon plateau 45..55 %
    CfgRGB q = cfgColoreTappe(d, CFG_S_CIELO, cfgPosizione(d, CFG_GIORNO, 30.0f));
    CHECK(q.r == 246 && q.g == 220 && q.b == 208);
    CfgRGB pk = cfgColoreTappe(d, CFG_S_TRAMONTO, cfgPosizione(d, CFG_TRAMONTO, 10.0f));
    CHECK(pk.r == 155 && pk.g == 92 && pk.b == 16);
    CfgRGB off = cfgColoreTappe(d, CFG_S_ALBA, 20.0f), on = cfgColoreTappe(d, CFG_S_ALBA, cfgPosizione(d, CFG_ALBA, 1.0f));
    CHECK(off.r == 0 && off.g == 0 && off.b == 0); CHECK(on.r == 18 && on.g == 12 && on.b == 5);   // rapid 1 % switch-on
    CfgRGB a0 = cfgColoreTappe(d, CFG_S_ALBA, 85.0f);              // ALBA 0 %: still off
    CHECK(a0.r == 0 && a0.g == 0 && a0.b == 0);
    CfgRGB eod = cfgColoreTappe(d, CFG_S_CIELO, cfgPosizione(d, CFG_GIORNO, 100.0f));   // end of GIORNO: warm
    CHECK(eod.r == 210 && eod.g == 82 && eod.b == 18);
  }

  // 9. colour mode: potentiometer -> value (normal / fine) and pick-up
  {
    PresepeConfig c; cfgDefault(c);              // pot 0..1023, pot_invertito = 1
    CHECK(cfgValoreDaPot(c, 0, 0, 0) == 255 && cfgValoreDaPot(c, 1023, 0, 0) == 0);
    c.potInvertito = 0;
    CHECK(cfgValoreDaPot(c, 0, 0, 0) == 0 && cfgValoreDaPot(c, 1023, 0, 0) == 255);
    CHECK(cfgValoreDaPot(c, 512, 0, 0) == 128);
    CHECK(cfgValoreDaPot(c, -50, 0, 0) == 0 && cfgValoreDaPot(c, 2000, 0, 0) == 255);   // clamped
    // fine: whole travel = base -16 .. base +16, centre = base
    CHECK(cfgValoreDaPot(c, 0, 1, 100) == 84 && cfgValoreDaPot(c, 1023, 1, 100) == 116);
    CHECK(cfgValoreDaPot(c, 512, 1, 100) == 100);
    CHECK(cfgValoreDaPot(c, 0, 1, 5) == 0 && cfgValoreDaPot(c, 1023, 1, 250) == 255);    // clamped at 0 / 255
    CfgAggancio a; cfgAggancioReset(a);
    CHECK(cfgAggancioAggiorna(a, 100, 50) == 0 && cfgAggancioAggiorna(a, 100, 80) == 0);  // below, approaching
    CHECK(cfgAggancioAggiorna(a, 100, 99) == 1);                                           // reached (+/-1)
    CHECK(cfgAggancioAggiorna(a, 100, 10) == 1);                                           // stays engaged
    cfgAggancioReset(a);
    CHECK(cfgAggancioAggiorna(a, 100, 200) == 0 && cfgAggancioAggiorna(a, 100, 150) == 0); // above
    CHECK(cfgAggancioAggiorna(a, 100, 90) == 1);                                           // jumped past: engaged
    cfgAggancioReset(a);
    CHECK(cfgAggancioAggiorna(a, 100, 100) == 1);                                          // already on the value
  }

  // 10. [WIFI] and [AUTENTICAZIONE]: defaults, quoted values with ; # = and spaces, limits
  {
    CHECK(d.wifiAbilitato == 0 && d.wifiSsid[0] == 0 && d.wifiPassword[0] == 0);
    CHECK(std::strcmp(d.wifiNome, "presepe") == 0);
    CHECK(std::strcmp(d.webUtente, "admin") == 0 && std::strcmp(d.webPassword, "presepe2026") == 0);
    PresepeConfig c; cfgDefault(c);
    cfgParseBuffer(c,
      "[WIFI]\nabilitato = 1\nssid = Casa Rossi 2.4 ; comment\npassword = \"ab;c#d=e f\" # comment\nnome = Presepe-Sala\n"
      "[AUTENTICAZIONE]\nutente = vanni\npassword = \"x;y\"\n");
    CHECK(c.errori == 0);
    CHECK(c.wifiAbilitato == 1 && std::strcmp(c.wifiSsid, "Casa Rossi 2.4") == 0);
    CHECK(std::strcmp(c.wifiPassword, "ab;c#d=e f") == 0);
    CHECK(std::strcmp(c.wifiNome, "presepe-sala") == 0);                      // lower case for mDNS
    CHECK(std::strcmp(c.webUtente, "vanni") == 0 && std::strcmp(c.webPassword, "x;y") == 0);
    PresepeConfig e; cfgDefault(e);
    cfgParseBuffer(e,
      "[WIFI]\npassword = corta\n"                                             // 1: WPA needs 8..63
      "password = \"senza fine\n"                                              // 2: unterminated quote
      "password = \"a\"b\"\n"                                                  // 3: inner quote
      "nome = sala presepe\n"                                                  // 4: space not allowed
      "nome = -presepe\n"                                                      // 5: leading '-'
      "nome = \n"                                                              // 6: empty
      "ssid = 123456789012345678901234567890123\n"                             // 7: 33 chars
      "[AUTENTICAZIONE]\nutente = \npassword = \"\"\n"                           // 8, 9: empty
      "colore = 1\n");                                                         // 10: unknown key
    CHECK(e.errori == 10 && e.primaRigaErrata == 2);
    CHECK(e.wifiPassword[0] == 0 && std::strcmp(e.wifiNome, "presepe") == 0 && e.wifiSsid[0] == 0);
    CHECK(std::strcmp(e.webUtente, "admin") == 0 && std::strcmp(e.webPassword, "presepe2026") == 0);
    PresepeConfig g; cfgDefault(g);
    cfgParseBuffer(g, "[WIFI]\nssid = \npassword = \nssid = 12345678901234567890123456789012\n"
                      "password = 12345678\n");
    CHECK(g.errori == 0 && std::strlen(g.wifiSsid) == 32 && std::strcmp(g.wifiPassword, "12345678") == 0);
    // [ACCESS_POINT]: defaults ready to use, every key, limits; abilitato = 2 / ap
    PresepeConfig ap; cfgDefault(ap);
    CHECK(std::strcmp(ap.apSsid, "Presepe") == 0 && std::strcmp(ap.apPassword, "presepe2026") == 0);
    CHECK(ap.apCanale == 6 && ap.apNascosta == 0 && ap.apMaxClient == 4 && ap.apPortale == 0);
    CHECK(ap.apIp[0] == 192 && ap.apIp[1] == 168 && ap.apIp[2] == 4 && ap.apIp[3] == 1);
    cfgParseBuffer(ap, "[WIFI]\nabilitato = 2\n[ACCESS_POINT]\nssid = \"Presepe; sala\"\npassword =\ncanale = 13\n"
                       "nascosta = si\nmax_client = 8\nip = 10.1.2.55\nportale = 1\n");
    CHECK(ap.errori == 0 && ap.wifiAbilitato == 2 && std::strcmp(ap.apSsid, "Presepe; sala") == 0 && ap.apPassword[0] == 0);
    CHECK(ap.apCanale == 13 && ap.apNascosta == 1 && ap.apMaxClient == 8 && ap.apPortale == 1);
    CHECK(ap.apIp[0] == 10 && ap.apIp[1] == 1 && ap.apIp[2] == 2 && ap.apIp[3] == 55);
    cfgParseBuffer(ap, "[WIFI]\nabilitato = AP\n"); CHECK(ap.wifiAbilitato == 2);
    CHECK(ap.apAttesa == 60);
    cfgParseBuffer(ap, "[WIFI]\nabilitato = 3\n[ACCESS_POINT]\nattesa = 10\n"); CHECK(ap.wifiAbilitato == 3 && ap.apAttesa == 10);
    cfgParseBuffer(ap, "[WIFI]\nabilitato = auto\n[ACCESS_POINT]\nattesa = 600\n"); CHECK(ap.wifiAbilitato == 3 && ap.apAttesa == 600 && ap.errori == 0);
    cfgParseBuffer(ap, "[ACCESS_POINT]\nattesa = 9\nattesa = 601\n"); CHECK(ap.errori == 2 && ap.apAttesa == 600);
    cfgParseBuffer(ap, "[WIFI]\nabilitato = 1\n"); CHECK(ap.wifiAbilitato == 1);
    PresepeConfig bad; cfgDefault(bad);
    cfgParseBuffer(bad, "[WIFI]\nabilitato = 4\n[ACCESS_POINT]\nssid =\npassword = corta\ncanale = 0\ncanale = 14\n"
                        "max_client = 9\nnascosta = forse\nip = 192.168.4\nip = 192.168.4.0\nip = 192.168.4.56\n"
                        "ip = 300.1.1.1\nip = 127.0.0.1\nip = 192.168.4.1x\nip = +1.2.3.4\nip = 1.2.3.0004\nfoo = 1\n");
    CHECK(bad.errori == 16 && bad.wifiAbilitato == 0 && std::strcmp(bad.apSsid, "Presepe") == 0 && bad.apCanale == 6 && bad.apIp[3] == 1);

    // a " inside an ordinary value does not swallow the comment
    PresepeConfig h; cfgDefault(h);
    cfgParseBuffer(h, "[RELE]\nnome1 = TV 12\" ; televisore\n[WIFI]\nssid = \"a ; b\" ; rete\n");
    CHECK(h.errori == 0 && std::strcmp(h.nome[0], "TV 12\"") == 0 && std::strcmp(h.wifiSsid, "a ; b") == 0);
  }

  // 11. link line check: "@CMD args*HH", HH = byte sum mod 256
  {
    char ok[32] = "@T*";  std::snprintf(ok + 3, 3, "%02X", lnkSomma("@T", 2)); CHECK(lnkVerifica(ok) && std::strcmp(ok, "@T") == 0);
    char r[48]; std::snprintf(r, sizeof r, "@R 3 1*%02X", lnkSomma("@R 3 1", 6));
    CHECK(lnkVerifica(r) && std::strcmp(r, "@R 3 1") == 0);
    char bad[48]; std::snprintf(bad, sizeof bad, "@R 3 0*%02X", lnkSomma("@R 3 1", 6)); CHECK(!lnkVerifica(bad));
    char low[16] = "@T*5d"; CHECK(!lnkVerifica(low));                         // lower-case hex refused
    char nostar[16] = "@T"; CHECK(!lnkVerifica(nostar));
    char noat[16]; std::snprintf(noat, sizeof noat, "T*%02X", lnkSomma("T", 1)); CHECK(!lnkVerifica(noat));
    CHECK(lnkSomma("@HELLO", 6) == (uint8_t)('@' + 'H' + 'E' + 'L' + 'L' + 'O'));
  }

  std::printf("%d checks, %d failures\n", checks, fails);
  return fails ? 1 : 0;
}
