zanac/PSN-Presepe-2026/(commit log)

2026-10-04 Add firmware CI workflow, .gitignore and executable bits
    - .github/workflows/firmware.yml: on changes under firmware/, run the
    PRESEPE.INI reader/tappe tests and compile the sketch for the Arduino
    Mega 2560; the HEX is published as a build artifact.
    - .gitignore: build outputs, KiCad local state, Wokwi bundle, arduino-cli
    files created by flash-windows.bat.
    - Mark the build/test shell and Python scripts executable (the web upload
    had dropped the bit; the workflow and build.sh call them directly).
    Claude-Session: https://claude.ai/code/session_01S57jeHAWREhchCq9pZcfbq
2026-10-04 CIELO day curve: near-white at 30 %, white plateau 45-55 %, warm by sunset
    New default tappe for the sky strip during GIORNO (also in PRESEPE.INI):
    0 % 210,82,18 warm
    30 % 246,220,208 80 % of the way from warm to white
    45 % 255,255,255 full white ...
    55 % 255,255,255 ... held until here
    70 % 246,220,208 back to 80 %
    TRAMONTO 0 % 210,82,18 warm, then the sunset fade as before
    Previously: white peak at 33.33 %, warm again at 66.67 %.
    Tests updated (55 checks), HEX rebuilt, READMEs describe the new curve.
    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
2026-10-04 Add [SISTEMA] fastboot (default 1): start the scene immediately
    fastboot = 1 skips the 3 s splash wait, the microSD status screen (still
    shown when PRESEPE.INI has errors), the 22 s light self-test and the boot
    melody; the cycle starts at the beginning of GIORNO (running or paused as
    set by partenza). fastboot = 0 restores the full start-up, where
    autotest_avvio and melodia_avvio keep their meaning.
    Documented in PRESEPE.INI (Italian comments), README.md, README.it.md and
    simulation/README.md; parser test extended; HEX rebuilt.
    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
    [PRESEPE.INI, PSN-Presepe.ino, test_config.cpp]
2026-10-04 Add colour mode: find the R,G,B values for the tappe with buttons and knob
    Hold TEST while powering on to enter it instead of the normal cycle:
    - strip choice: the proposed strip lights white, NEXT cycles
    ALBA -> CIELO -> TRAMONTO, START confirms;
    - adjustment: short START/NEXT/TEST = channel R/G/B, the potentiometer
    sets it 0..255 with pick-up (no change until the knob reaches the
    current value; the OLED shows which way to turn); two clicks within
    1 s on the same button toggle fine adjustment (+/-16 around the value);
    - OLED and serial show a ready-to-copy "tappa: R, G, B" line; the strip is
    driven through the same gamma / lum_* path as the scene;
    - START held 2 s = back to strip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
    [PRESEPE.INI, PSN-Presepe.ino, test_colore.cpp, test_config.cpp]
2026-10-04 Splash "by Vanni" always 3 s; TEST pressed during it enters colour mode
    The TEST button was sampled once for ~30 ms right after the microSD was
    read, which made the colour mode hard to reach (especially in Wokwi).
    Now the splash lasts 3 s on every start (also with fastboot = 1), shows
    "TEST = modo colore", and a TEST press at any moment of those 3 s (or held
    from power-on) enters the colour mode. fastboot still skips the SD screen
    (unless errors), the self-test and the melody. Docs updated.
    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
    [PRESEPE.INI, PSN-Presepe.ino]
2026-10-04 Tests: mock delay() and check the 3 s splash window for TEST
    Fixes the CI failure of the previous commit: test_colore.cpp did not
    provide delay(), now used by attesaSplash(). New checks: no press = full
    3 s, press at 2.5 s is detected, TEST held from power-on enters at once.
    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
    [test_colore.cpp]
2026-10-05 PRESEPE.INI organised by phase: strip colours and relay events per phase
    New format: the sections [GIORNO] [TRAMONTO] [CREPUSCOLO] [NOTTE] [ALBA]
    hold everything that happens in that phase:
    cielo | tramonto | alba = %, R, G, B [, morbida|lineare] (colour tappe)
    rele = RELAY, ON|OFF, % (relay events)
    The % is relative to the section's phase.
    - Tappe of each strip are sorted by time on load: lines and sections may
    come in any order (same point keeps file order = instant change).
    - A strip's lines in a phase replace the default tappe of that strip in
    that phase only; other phases keep their defaults (tappeDaFile is now a
    per-phase bitmask).
    - Rela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
    [PRESEPE.INI, PSN-Presepe.ino, test_config.cpp]
2026-10-05 Add browser simulator of the PRESEPE.INI light cycle (simulation_web/)
    Single HTML page that parses PRESEPE.INI with the firmware's rules and
    plays the cycle: CIELO/TRAMONTO/ALBA panels, tappe timeline with
    scrubbing, stars, casette and the 16 relays. index.html is generated
    from simulator.template.html and the repo PRESEPE.INI by
    build_simulator.py. READMEs link to it.
    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
2026-10-21 README: BZ1 footprint is 7.6 mm but CEM-1203(42) is 6.5 mm (fix in Rev E)
    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
2026-10-22 README: C1 footprint has no polarity marking (fix in Rev E)
    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
2026-10-27 WiFi: optional web panel and config editor on a Mega + WiFi R3 board
    - New [WIFI] and [AUTENTICAZIONE] sections in PRESEPE.INI (quoted values
    allowed); with abilitato = 0 the firmware behaves as before.
    - Mega: link with the ESP8266 on Serial3 (checksummed commands with
    retransmission, quiet window around NeoPixel show()), IP shown as the
    first TEST step, web test mode, SD file read/write with PRESEPE.BAK,
    software restart that re-reads the card.
    - ESP8266 firmware (PSN-Presepe-WiFi): control panel at /, INI editor with
    live preview at /config (the web simulator in device mode), Basic auth,
    mDNS presepe.local, ArduinoOTA.
    - Tests: WiFi/auth parsing, link unit test, ESP <-> Mega e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
2026-10-27 WiFi: fixes from the review (safe saves, numbered commands, CSRF)
    - Never write an empty or truncated PRESEPE.INI: the page sends X-Len, the
    ESP checks it without copying the body, the Mega refuses COMMIT 0.
    - Power loss during the copy .NEW -> file: a mark file (PRESEPE.CMT) makes
    the next boot finish the copy; a failed copy puts .BAK back. RESTORE now
    goes through the same path.
    - RUN, NEXT, COMMIT and RESTORE carry a number: a retransmission gets the
    first reply and is not executed twice (no double NEXT, no undone RESTORE,
    no lost COMMIT error turned into success).
    - COMMIT/RESTORE/GET answer @ACK/@FILE at once: short retransmit timeout,
    long wait only for the SD work. A lone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
2026-10-27 Write the example PRESEPE.INI to a card that has none
    At power-on, when the microSD has neither PRESEPE.INI nor PRESEPE.TXT, the
    firmware writes the complete example file (defaults plus the Italian
    explanation of every key, CR LF line ends, a short header saying the board
    created it) and uses it. The OLED shows "PRESEPE.INI CREATO" for 4 s, also
    with fastboot. A failed write leaves no partial file.
    - The text is embedded in the sketch as INI_PREDEFINITO (PROGMEM, 13.2 kB),
    generated from PRESEPE.INI by firmware/tools/embed_ini.py; run_tests.sh
    (and so CI) checks it is up to date.
    - New host test test_ini.cpp: content, CR LF, parse with 0 errors, existing
    file untouched, no card, write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
2026-10-27 Add demo/: the WiFi web pages with a simulated board
    demo/index.html (control panel) and demo/config.html (PRESEPE.INI editor)
    run in any browser, also from GitHub through raw.githack, without hardware.
    firmware/web/demo_mock.js answers /api/* in the browser: it runs the cycle
    from the repo's PRESEPE.INI with the simulator's parser and light engine,
    handles the test commands, and keeps a simulated microSD (save, .BAK,
    restore, restart) in localStorage.
    The pages are generated by build_web.py from the same sources as the
    firmware pages, and build_web.py --check (CI) fails when they are out of
    date, so the demo cannot drift. run_tests.sh also syntax-checks them.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
2026-10-27 WiFi access point mode: [WIFI] abilitato = 2 and [ACCESS_POINT]
    With abilitato = 2 (or "ap") the ESP8266 creates its own network instead of
    joining one, for places without WiFi. New [ACCESS_POINT] section, ready to
    use as shipped and documented in PRESEPE.INI:
    ssid = Presepe, password = presepe2026 (empty = open), canale = 6 (1-13),
    nascosta = 0, max_client = 4 (1-8), ip = 192.168.4.1 (/24),
    portale = 0 (1 = captive portal: DNS answers every name with the board,
    other URLs redirect to the panel).
    - Mega: parser (same rules in the simulator), config push (@MODE @APSSID
    @APPWD @APOPT @APIP), TEST screen shows network name and address, serial
    summary and default-password warnings.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
2026-10-27 Align the documentation with the firmware (audit), small fixes
    Documentation (README EN/IT, PRESEPE.INI, simulator and Wokwi READMEs):
    - relays restart off at every cycle start; how to keep one on across it
    - TEST WiFi screen texts per mode (non collegato / cerco la rete... /
    ESP non risponde) and a link check using abilitato = 2
    - boot: interrupted-save recovery, splash "by Vanni 039", colour mode skips
    the self-test, CREATO shown with fastboot, melody only with the self-test
    - quoted values only in [WIFI]/[ACCESS_POINT]/[AUTENTICAZIONE]; 126-char
    lines; key limits ([FASI] 1-99, nome, utente/password, relay names)
    - final value checks (pot range, lum, twinkle) and "valori incoerenti"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
2026-10-27 STOP / PLAY for ceremonies
    - START held 2 s = STOP: everything off (relays incl. forced ones, RGB
    strips, stars, houses), OLED "STOP", NEXT and TEST ignored. A short START
    in STOP = PLAY: the cycle restarts from the beginning of GIORNO. The short
    START press (pause/resume, exit TEST) now acts on release.
    - Web: STOP and PLAY commands (numbered), status modo 4; panel gets
    "Stop: spegni tutto" and, while stopped, a card with a big Play button;
    test and cycle commands are refused with "presepe in STOP".
    - Fix: a star refresh skipped while the ESP was sending (quiet window) is
    now kept pending and sent from loop(), so stars really switch off on a
    web STOP or when the web test start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
2026-10-28 Move the Rev D PCB into hardware/rev-d
    build/, kicad/, manufacturing/, previews/ and reports/ move unchanged into
    hardware/rev-d/, with its own build.sh (PCB only). The root build.sh now
    rebuilds every hardware/rev-* folder plus the firmware. Rebuilding Rev D
    from the new place still gives Gerbers identical to the PCBWay order.
    README (EN/IT) paths updated.
    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
2026-10-28 Rev E: generator, checks and firmware status LED (work in progress)
    hardware/rev-e starts from the Rev D scripts with:
    - BZ1 on a local 6.5 mm footprint (Same Sky CEM-1203(42)), C1 on
    CP_Radial (square + pad, "+" mark)
    - 0.22 mm minimum clearance in rules, A* completer and both independent
    checkers, plus an explicit >= 8 mil check
    - status LED D1 + RLED on D13, test points TP1-TP4 (+12V/+5V/+3V3/GND)
    - no-via rule area over the Mega USB socket; seam filler for same-net
    tangent tracks (copper sliver); Freerouting timeout
    - BOM/CPL/assembly notes for the new parts
    Firmware: LED_STATO = 13 with run/pause/test/STOP/warning patterns
    (only the Mega's L LED on Rev D; Rev D checks still pass)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
2026-10-28 Rev E: routed board, manufacturing files and reports
    New Freerouting session stored in hardware/rev-e/build/data/routing.ses;
    replaying it rebuilds identical Gerbers. KiCad DRC: 0 violations, 0
    unconnected; independent board and Gerber checks pass, minimum copper
    spacing 0.222 mm (>= 8 mil); BZ1 6.5 mm, C1 polarised, LED on D13 and
    test points verified. kicad/, manufacturing/, previews/, reports/
    generated by hardware/rev-e/build.sh (UPDATE_REPO=1).
    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
2026-10-28 Rev E: fixes from the independent review
    - Test points now TP1-TP5 in the order 12V, GND, 5V, GND, 3V3: a slipping
    probe can only short a rail to GND (never 12 V onto the Mega's 5 V or
    5 V onto the 3.3 V of the microSD); verify.py checks the order.
    - USB no-via rule area is now also in the routed board, so KiCad DRC keeps
    enforcing it after any later edit.
    - Copper sliver fix in cleanup.py (only when DRC reports one): fill the
    seam of same-net tangent tracks and bridge track ends that just touch a
    same-net track; deterministic output, net-class widths respected.
    - Assembly PDF counts SMD parts from the board (12); TP symbols not in the
    schematic BOM; Gerber checker uses 0.25 mm f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
2026-10-28 README: two board releases (Rev D, Rev E) and step-by-step Arduino IDE flashing guide
    Board revisions table near the status note; Arduino IDE guide for a plain
    Mega and for the Mega + WiFi R3 (libraries, ESP8266 core, DIP switches,
    @HELLO check, first access-point test, later USB/OTA updates). Demo links
    now point to main.
    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
2026-10-28 Config editor: graphic view of the phases (mockup)
    New "Grafico" view in /config, the demo and the simulator: per-phase
    lanes for Tramonto, Cielo, Alba and relays, colour stops as draggable
    dots over the resulting gradient, editor with RGB sliders, colour
    wheel, presets, position, curve and comment, add / duplicate / delete,
    undo. Each change rewrites only the lines of that key in that phase
    section and keeps the comments. On the board, "Dal vivo" drives the
    real strips and relays with the test commands S / R and leaves test
    with X; "Prova la fase" plays the phase in 10 s / 30 s / 1 min / real
    time. No firmware change.
    Claude-Session: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
2026-10-28 Config editor: phase test always at real speed
    Drop the 10 s / 30 s / 1 min choice. The test lasts as long as the phase
    does with the cycle duration selected on the board (potentiometer, read
    from /api/stato), or the one chosen under the stage in the simulator;
    the button shows it.
    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
2026-11-04 ESP: pages survive a weak WiFi link, and are not resent when unchanged
    On a weak link (far repeater) TCP retransmissions exceeded the web
    server's 5 s send timeout: the 21.8 kB /config page arrived cut short
    (ERR_CONTENT_LENGTH_MISMATCH) and its script never ran. The pages now
    wait up to 20 s, and carry an ETag tied to the build so the browser gets
    a 304 without body when it already has the page of this firmware.
    e2e: timeout, ETag and 304 checked.
    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
2026-11-04 ESP: long bodies no longer cut short (real cause of the blank /config)
    In core 3.1.2 the web server sends a body with Stream::sendSize, which
    gives up when nothing can be written for getTimeout() of the source
    stream: 1000 ms for the StreamConstPtr that send_P and send(String)
    build. One lost packet (TCP retransmits after about 1 s) and the reply
    stopped halfway: ERR_CONTENT_LENGTH_MISMATCH on /config (21.8 kB), the
    panel (7.9 kB) usually made it. The client timeout set in the previous
    commit is not the one used. inviaCorpo() sends pages and the INI file
    from a StreamConstPtr with a 20 s timeout.
    Checked: syntax against the real core 3.1.2 headers (xtensa g++
    -fsyntax-only), e2e with the so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
2026-11-05 Two identical star chains STELLE_01 / STELLE_02 (casette removed), WiFi responsiveness
    Firmware (Mega): the CASETTE chain on D8 becomes STELLE_02, a second star
    chain with the same behaviour and settings as STELLE_01 (D5): appears at
    dusk, twinkles at night, fades at dawn. Config sections [STELLE_01] and
    [STELLE_02] with the same keys and defaults; [STELLE] and [CASETTE] are no
    longer read (errors), no compatibility on purpose. Chain refresh takes turns
    so interrupts are off for one WS2811 transmission at a time. Test steps,
    autotest, serial log and OLED renamed. RAM +71 bytes (avr-gcc build).
    Firmware (ESP8266): radio power saving off (WIFI_NONE_SLEEP) in station
    and access-point mode; the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
2026-11-05 Review fixes; Wokwi STELLE_02 as 50 stars; prebuilt HEX and BIN rebuilt
    - Wokwi: STELLE_02 (D8) is now 50 wokwi-neopixel parts (s2_1..s2_50,
    mirrored layout of STELLE_01) below the RGB bars instead of a led strip,
    in both diagrams.
    - Panel: no 'risposta undefined ms' before the first poll.
    - demo/README: no more houses.
    - PSN-Presepe.ino.hex and PSN-Presepe-WiFi.ino.bin rebuilt from this source
    with arduino-cli (arduino:avr 1.8.6, esp8266 3.1.2); README sizes updated
    (Mega 88.2 kB flash, 4.9 kB RAM).
    - stelleFlush comment says what the turn-taking actually does.
    Claude-Session: https://claude.ai/code/session_01S57jeHAWREhchCq9p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
2026-11-05 Wokwi: STELLE_01 and STELLE_02 side by side, OLED left of ALBA, microSD below the relays
    Controls, potentiometer, buzzer and relays moved right to make room for the
    second star field; both diagrams.
    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
2026-11-05 Wokwi: link to the new online project (two star chains)
    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
2026-11-05 Pages: inline icon (no /favicon.ico 404), canvas hint for getImageData
    The panel and the editor carry their icon as an inline SVG, so the browser
    no longer asks the board for /favicon.ico; the ESP also answers that path
    with 204. The canvases read back with getImageData get
    willReadFrequently, as Chrome suggests. Prebuilt BIN rebuilt.
    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
2026-11-05 ESP: wait for the ACKs of a long body before closing; ESP diagnostics
    /api/ini (the ~16 kB INI file) still arrived cut short
    (ERR_CONTENT_LENGTH_MISMATCH). The web server drops the current connection
    at once when another one is waiting (the page polls /api/stato every
    second); closing with data not yet acknowledged can end in tcp_abort, a
    reset that cuts the reply. inviaCorpo() now waits up to 10 s for the ACKs
    (WiFiClient::flush) before returning. The file buffer is reserved at 17 kB
    in one allocation. /api/stato carries esp {heap, blocco, avvio, reset}; the
    panel shows it as a tooltip on the network line (an uptime that restarts
    from zero means the ESP rebooted). e2e: 48 checks.
    Co-Author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
2026-11-05 ESP: answer the OTA invitation also while waiting for the Mega
    comando() can wait up to ~20 s for the Mega (file read and save); the IDE's
    OTA invitation (UDP 8266) arrived meanwhile went unanswered and the upload
    failed with 'No response from device'. ArduinoOTA.handle() now runs in that
    wait loop too. Prebuilt BIN rebuilt.
    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
2026-11-05 Panel shows the ESP firmware build date (version + compiled on)
    /api/stato carries build (__DATE__ __TIME__ of the ESP sketch); the panel
    prints 'Firmware ESP 039, compilato il ...' at the bottom, so after an OTA
    upload it is clear whether the new firmware is running. README EN/IT.
    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
2026-11-05 Editor on the board: always live, no on-screen stage; INI read timing
    On the board (/config served by the ESP) the 'Dal vivo sulle strisce'
    switch is gone: the editor always drives the real strips and relays. At
    the first action the board enters TEST; 'Torna al ciclo' (or leaving the
    page, keepalive fetch on pagehide) sends X. The Palco card is hidden there
    (the timeline canvas skips drawing at zero size); the demo keeps it as
    'Palco (scheda simulata)', the GitHub simulator is unchanged.
    /api/ini reports X-Tempo (ms the ESP waited for the Mega: microSD +
    serial); the page says how long the read took and how much was board and
    how much network. README EN/IT. Prebuilt BIN rebuilt.
    Co-Authore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
2026-11-05 WiFi: disable Nagle on page and INI responses
    Nagle on the ESP plus delayed ACK on the browser side stalls each partial
    segment up to ~200 ms: the 16 kB INI took ~4.8 s to download.
    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
2026-11-05 INI cache by signature: an unchanged file is not sent again
    Mega: new @SUM command (CRC-32 + size of the file on the microSD, without
    sending it); @END now carries the same signature (@END lines crc bytes).
    ESP: GET /api/ini with X-Firma answers X-Invariato and no body when the
    signature still matches; responses carry X-Firma; the save returns the
    signature of the file just written. Older Mega firmware: always a full read.
    Page: keeps the card's file and signature in the browser and opens the copy
    when the board says it is unchanged. Demo mock, tests and READMEs updated;
    HEX and BIN rebuilt.
    Claude-Session: https://claude.ai/code/sessi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
2026-11-05 Panel: relay buttons switch at once, revert if the board does not confirm in 5 s
    The button no longer flips back while an old status is still on its way;
    a refused or failed command reverts it right away.
    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
2026-11-05 ESP: send the INI gzip-compressed when the browser accepts it
    Small deflate compressor (LZ77 with hash chains + one dynamic Huffman block,
    ~10 kB of tables) in comprimi.h: the example file goes from 15.7 kB to 6.1 kB
    on the network and the browser decompresses it natively. Falls back to the
    plain file when the ESP is short of memory (X-Compresso: memoria). The page
    shows the compressed size. New test: 66 texts compressed and checked with
    Python's gzip; e2e checks the headers.
    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
2026-11-06 Pages: system fonts, preloading, last known state, WebSocket panel
    - No Google Fonts: system font stacks only (no Internet request, none in AP).
    - Panel, when idle: prefetch /config once per ESP firmware, then refresh the
    browser copy of PRESEPE.INI (signature check) so the editor opens with it.
    - Editor shows the browser copy at once while checking it with the board;
    does not overwrite edits made meanwhile if the file changed.
    - Panel shows the last known state (dimmed) until the real one arrives.
    - WebSocket on port 81 (ws_mini.h, no extra library; per-boot key handed
    out by /api/stato): state pushed as it arrives, commands and ping on the
    same connection; silent pages closed after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
2026-11-07 ESP: gzip the INI in pieces, within the memory left while it is in RAM
    On the real board the heap is ~32 kB at rest and ~15 kB while the INI is
    held: the previous compressor (10 kB tables + whole output buffer) would
    never have run. Now: three passes (frequencies, size for Content-Length,
    writing), output streamed in 256-byte pieces with a 20 s source timeout,
    LZ77 tables freed while the Huffman trees are built; peak ~9 kB. Window
    2 kB: 6.3 kB instead of 6.1 kB for the example file. The test checks the
    size pass against the written bytes.
    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
2026-11-07 Revert WebSocket, preloading, system fonts and streamed gzip
    On the real board everything got worse (pages stopped loading, transfers
    broke off). Back to the state of main (851a79b).
    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
2026-11-08 [COSTELLAZIONI]: groups of stars lit together, outside the random ones
    "costellazione = lum | 01:3, 01:7, 01:12-14, 02:5" (up to 8 lines): stars of
    either chain, own luminosity per group, steady light, all fading in together
    in the dusk and out together in the dawn along the star level; never among
    the random stars (fewer random stars if few are free). Whole line rejected
    on a bad or repeated star; stars beyond numero dropped by cfgValida.
    Example INI: commented-out section. Simulator parser and meters. New host
    test of the star engine (test_stelle.cpp); config tests; READMEs.
    Claude-Session: https://claude.ai/code/session_01S57jeHAWRE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
2026-11-10 Editor: Costellazioni view to define constellations and hook their stars
    Lists the [COSTELLAZIONE] sections; adds and deletes them; name, luminosity,
    mode, own colour; both chains as numbered buttons (tap to hook / unhook,
    stars of another constellation refused). On the board the chosen
    constellation lights on the real sky through the existing web test
    commands (PC, PA, P), or a single star with "Solo vederla accesa".
    Writes only that section (stelle lines with runs, split under 100
    chars). No Mega change. ESP BIN rebuilt (pages only). READMEs.
    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
2026-11-11 Regia: constellation lanes edit only the times
    Luminosity and mode removed from the constellation panel of the Grafico
    view (they live in the Costellazioni view); a button opens that view on
    the same constellation. READMEs.
    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
2026-11-12 Editor: say what the board did (or why not) in the Costellazioni view
    Messages of the live commands go to the view in use (they were shown only in
    the Grafico view, hidden while in Costellazioni): which stars are lit, or
    STOP / colour mode / no answer.
    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
2026-11-12 Live editor: stars and constellations follow the timeline on the board
    New "S 3 integer hundredths 0" in web test: the Mega shows the stars (random
    ones and constellations, with times, modes and twinkle) as at that point of
    the cycle, from the saved file, and keeps them twinkling; P / PA / PC go
    back to pixel mode. stelleAPosizione() split out of aggiornaScena (same
    behaviour in the cycle). The editor sends it with the strips at every
    position. No ESP C++ change (S is already allowed). Tests, mock, READMEs.
    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
